dgorman/overlanding/battery-box/renders/cube/cards-lifted.png

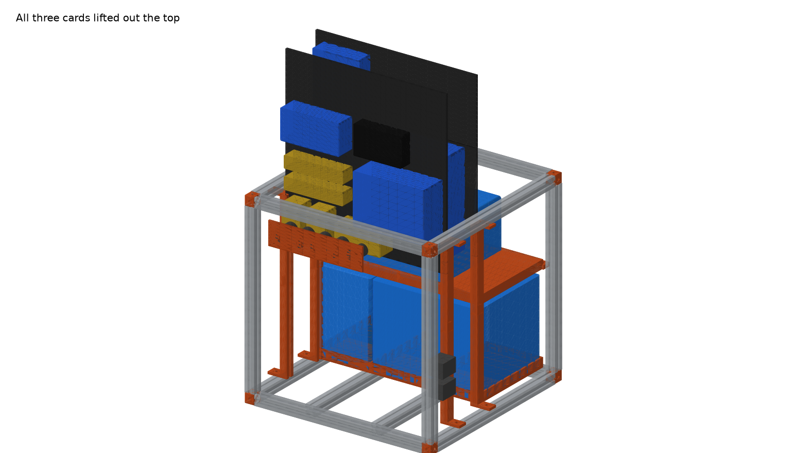
battery-box/renders/cube/cards-lifted.png
