dgorman/overlanding/battery-box/renders/master/front.png

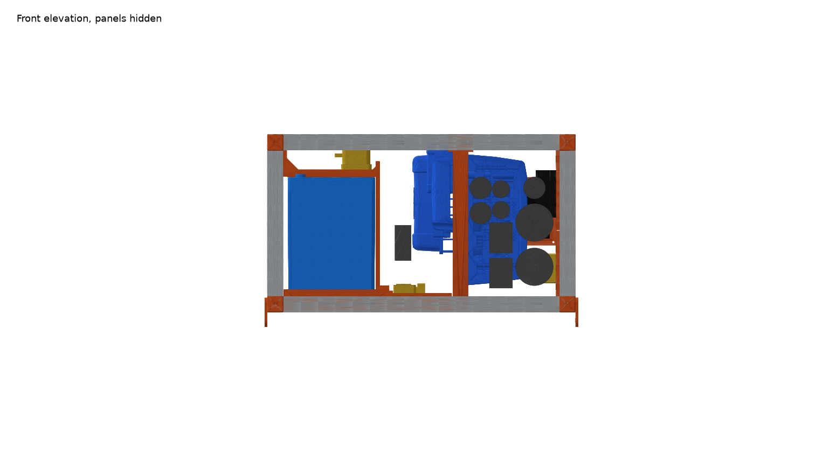
battery-box/renders/master/front.png
