dgorman/overlanding/battery-box/renders/master/iso-back.png

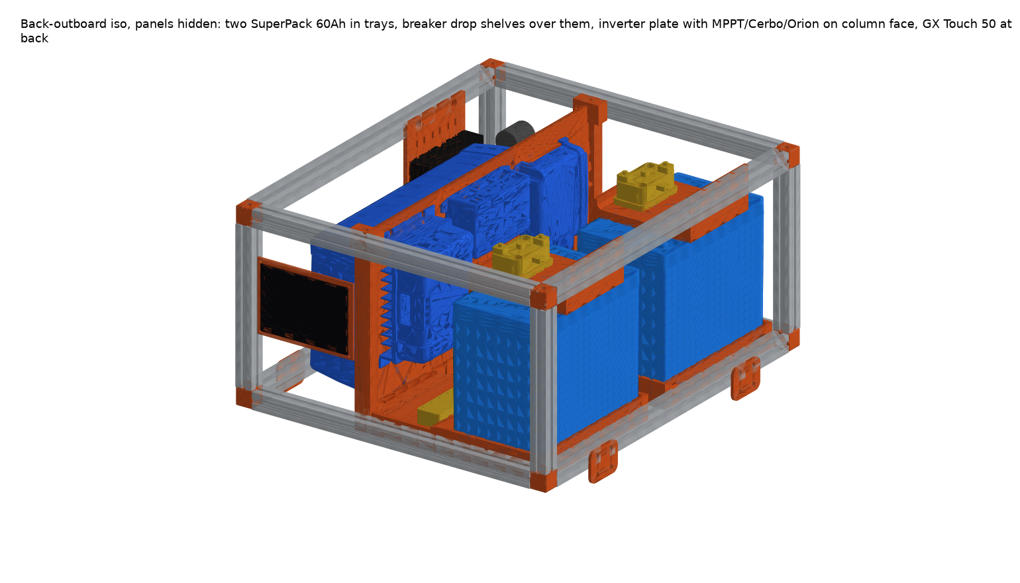
battery-box/renders/master/iso-back.png
