dgorman/overlanding/battery-box/renders/master/with-icebox-top.png

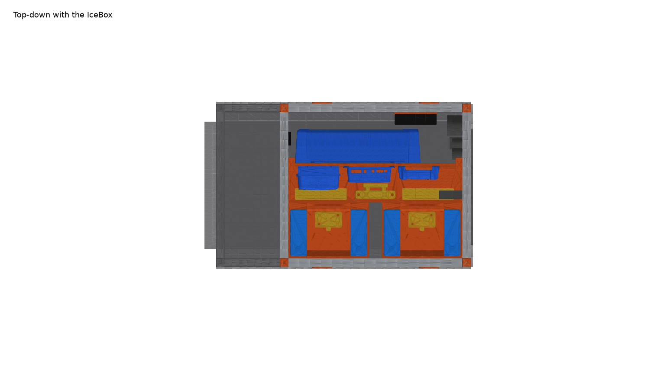
battery-box/renders/master/with-icebox-top.png
