dgorman/overlanding/battery-box/renders/pack2/cards-lifted.png

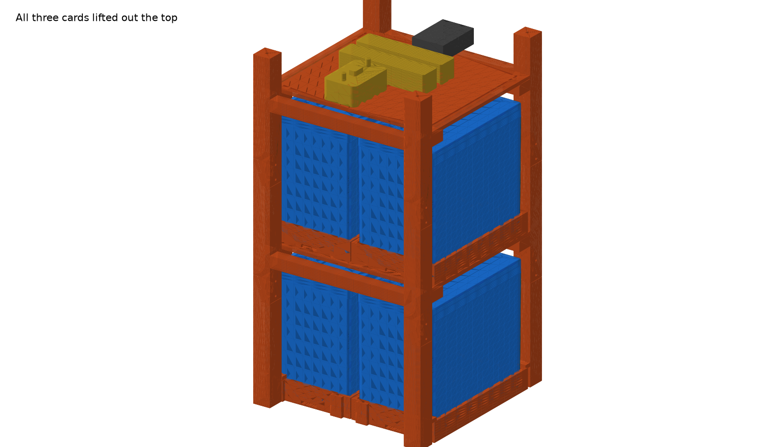
battery-box/renders/pack2/cards-lifted.png
