dgorman/overlanding/goose-gear-icebox-matching-parts.md

# Building a Matching Box for the Goose Gear IceBox 1.3

> **Outcome (updated 2026-10-30):** The matching electronics box (**`v12s`**) is built from the frame, corner cubes, and panels of a **donor 25 in Goose Gear IceBox 1.3** cut down to `571.5 × 488.1 × 281.7 mm` (`22.5 × 19.2 × 11.1 in`), plus **one bar from a Goose Gear Extrusion Frame Modification Kit x.31** to supply the missing bottom-front width rail (`436.6 mm`). Caliper measurement of the donor frame confirmed the MaxLite™ profile is **metric 25-series (`25.0 × 25.0 mm`, `6.5 mm` slot opening)** with **`25.75 mm` corner cubes** and **`6.0 mm` phenolic-faced plywood panels** captured in the rail centre slots (`1/4-20` 10-series drop-in T-nuts `6000N501` fit the `6.5 mm` slot). See [`battery-box/README.md`](battery-box/README.md) and [`battery-box/MANUAL.md`](battery-box/MANUAL.md). The notes below remain as the initial identification research.

**Vehicle:** Toyota 4Runner
**Goal:** Build an additional storage box that attaches to the Goose Gear IceBox 1.3 and looks identical — same silver extrusion, black corner cubes, and black textured panels.
**Why DIY:** Goose Gear will not sell raw parts. Their current frame profile is a proprietary extrusion they call **MaxLite™** (6063-T6 aluminum), which is why nothing ships as components — but every element has an off-the-shelf visual twin.

*Researched 2026-09-25 from close-up photos of the actual box (macro shots of the extrusion, tape-measure shot of the profile, corner detail).*

---

## What the IceBox is made of (identified from photos)

| Element | Identification |
|---|---|
| Frame | **1" × 1" T-slot aluminum extrusion** (measured ~1" wide), clear anodized — the "silver" finish is standard clear anodize, not paint |
| Corners | **Black 3-way squared corner cube** with counterbored thru-holes on each face (Goose Gear describes theirs as fiber-reinforced nylon; the 80/20 black-anodized aluminum part is a dead ringer) |
| Top panel | Birch-core plywood faced with **black phenolic film, hexa-grip anti-slip texture** (the dotted pattern) |
| Side panels | Same plywood, **smooth black phenolic** face — CNC-cut slots show the bare yellow ply core edges |
| Fasteners | Stainless Torx flanged button-head screws into slot T-nuts; wing-bolt eyelet tie-downs riding in the T-slot |
| Panel core note | Goose Gear's own spec is Joubert **okoume** marine ply (Lloyds-certified, ~half the weight of birch), laminated in-house with PVA cold-press. Phenolic-faced birch is the accessible look-alike; expect a few extra pounds per panel. |

---

## Parts list (10-series, 1" fractional)

### Extrusion

80/20 **10-series** 1" × 1", clear anodize. The smooth-faced variant (1010-S) matches the IceBox's clean look better than the grooved standard 1010.

| Source | Notes |
|---|---|
| [TNUTZ](https://www.tnutz.com) — EX-1010 | Economy equivalent, cut-to-length + end-tap service, roughly half of 80/20 pricing |
| [8020.net — 1010 family](https://8020.net/4042.html) | Cut-to-length, offers the 1/4-20 end-tap machining |
| Amazon | Stock lengths (24–48") if cutting at home |

#### About the bevel

The MaxLite profile has a **beveled/soft-edged face** that standard 80/20 1010 (square edges, small corner radius) doesn't replicate. Options, best match first:

1. **Genuine Goose Gear extrusion via their mod kits.** They won't sell raw stock, but they DO sell the [Extrusion Frame Modification Kit x.31](https://www.goose-gear.com/products/extrusion-frame-modification-kit-x-31-for-campkitchen-icebox) (~$139) — "includes both Extrusion Bars and hardware," sized for the CampKitchen 2.3 / IceBox 1.3 footprint. Buying one or two mod kits = real MaxLite bars with the exact bevel and anodize. Call Goose Gear for bar lengths before ordering (8-week build-to-order lead time). Their [Anchor Kits](https://www.goose-gear.com/products/goose-gear-anchor-kits) cover matching tie-down hardware.
2. **TSLOTS (Futura) TS10-10QR "Quarter Round"** — 1" × 1", **two T-slots + large radius outer corner**: slots face the panels, the soft corner faces out. Much closer to the Goose Gear edge than square 1010. Sold by [Framing Tech](https://www.framingtech.com/shop/1-0x1-0-r-240inch-1-x-1-t-slot-profile-2-26-tslots-quarter-round-402620) and [Automation Werks](https://www.automationwerks.com/products/tslots-1012-s-1-in-x-1-in-quarter-round-extrusion-650040/2217522000016375453); 0.26" slots, center bore taps 1/4-20.
3. **Standard 1010 / 1010-S** — square-edged but visually close at arm's length; cheapest and most available.

Don't chamfer standard 1010 yourself — routed edges expose bare (shinier) aluminum that won't match the anodize.

### Corner cubes

**80/20 #4042-Black — 10 Series 3-Way Squared Corner Connector.**

- [8020.net product page](https://8020.net/4042-black.html)
- [Amazon](https://www.amazon.com/80-20-Inc-4042-Black-Connector/dp/B09QXFMVCX)
- [Global Industrial](https://www.globalindustrial.com/p/8020-10-series-3-way-squared-corner-connector-black)

Fastens with bolts threaded into the **ends** of the extrusion → order extrusion with **1/4-20 end taps**, or hand-tap the center bore yourself (easy).

### Panels

Black phenolic film-faced birch plywood — hexa-grip texture for the top, smooth black for sides:

| Source | Notes |
|---|---|
| [Penn Elcom — 12mm black hexa birch (M847113)](https://www.penn-elcom.com/12mm-film-faced-high-quality-birch-with-black-hexa-pattern-m847113) | Road-case supplier, sells cut panels; also [12mm smooth black phenolic (X11120S)](https://www.penn-elcom.com/us/12mm-film-faced-high-quality-birch-with-black-smooth-phenolic-x11120s) |
| [Woodworkers Source — Ultra-X pre-cut packs](https://www.woodworkerssource.com/birch-plywood/UltraGripX/12-thin-black-hex-pattern-anti-slip-phenolic-exterior.html) | 1/2", hex pattern one side / smooth the other, exterior glue |
| [MakerStock — Hex-Ply](https://makerstock.com/products/hex-phenolic-baltic-birch-plywood-black) | 12–18mm anti-slip phenolic birch |

### Hardware

- 1/4-20 **flanged button-head screws** (stainless Torx to match) + **10-series economy T-nuts** — TNUTZ, 8020, or Amazon 10-series kits
- Slot-mount **eyelet / wing-bolt tie-down anchors** in 10-series

---

## ⚠️ Measure before ordering

Two caliper checks on the existing IceBox:

1. **Profile width:** exactly **1.000"** → fractional 10-series (order above). **0.984" (25mm)** → metric 25-series instead (8020 sells that too; M6 hardware).
2. **Slot opening:** 10-series ≈ **0.26"**; 25-series ≈ 6mm. Determines which T-nuts fit.

Goose Gear builds in the USA, so fractional 10-series is the strong bet — but the check costs nothing and a wrong guess costs a return.

---

## Build approach

1. Cut 1010 to length with 1/4-20 end taps at every corner-cube joint.
2. Join the frame with 4042-Black cubes.
3. Screw phenolic panels to the frame faces: button-heads through the panel into T-nuts in the slots (exactly how the IceBox panels attach).
4. **Attaching to the IceBox:** both boxes have open T-slots — bolt them together with T-nuts and joining plates. No drilling into the Goose Gear unit.

---

## Reference links

- [Goose Gear IceBox 1.3 product page](https://www.goose-gear.com/products/icebox-1-3-25-deep-module) (MaxLite™ extrusion, okoume panel spec, ~42 lb)
- [80/20 3-way squared corner connector family](https://8020.net/fasteningmethods/externalfasteners/bracketsgussetscorners/triconnectioncornerbrackets/3waysquaredcornerconnector.html)
- [Expedition Portal — Goose Gear thread](https://expeditionportal.com/forum/threads/goose-gear.132936/)
- [Expedition Portal — 80/20 "erector set for campers"](https://forum.expeditionportal.com/threads/80-20-erector-set-for-campers.154860/)
