dgorman/overlanding/battery-box/stl/icebox/print_post_main_1_0.stl

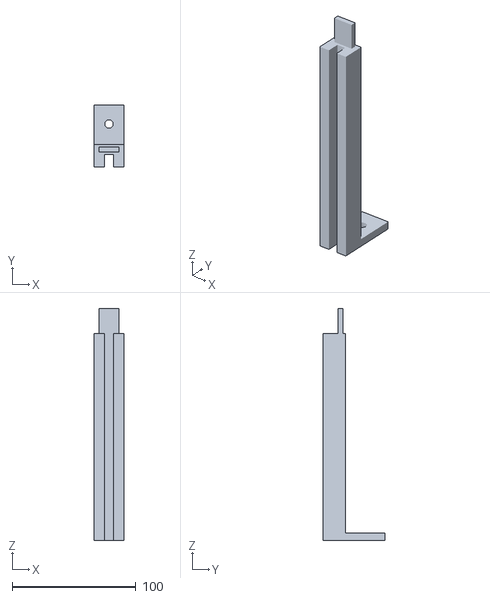
[picture p10: CAD file, 2026-10-23]
battery-box/stl/icebox/print_post_main_1_0.stl
24.0 x 50.0 x 187.3
