dgorman/overlanding/battery-box/stl/cube/print_post_main_1_0.stl

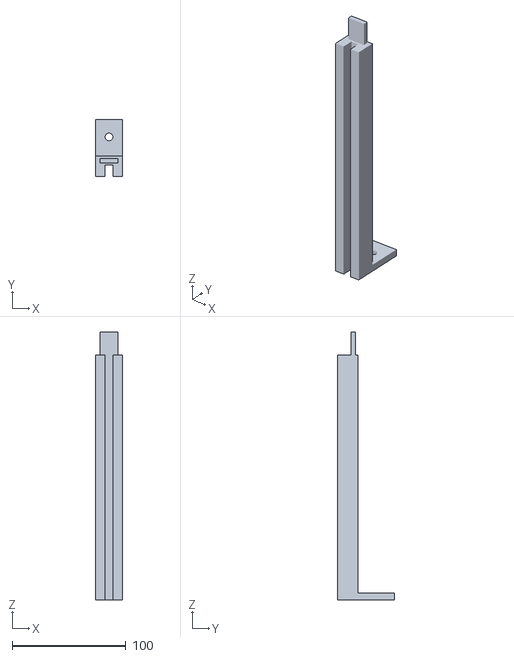
[picture p11: CAD file, 2026-10-23]
battery-box/stl/cube/print_post_main_1_0.stl
24.0 x 50.0 x 235.3
