dgorman/overlanding/battery-box/stl/icebox/print_post_main_0_2.stl

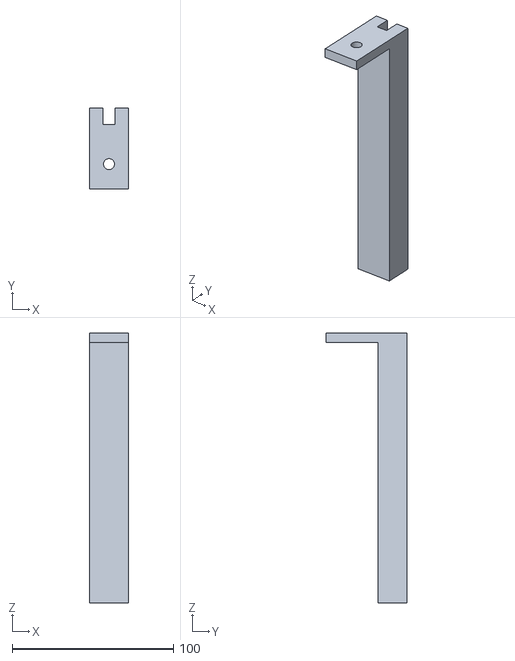
[picture p12: CAD file, 2026-10-23]
battery-box/stl/icebox/print_post_main_0_2.stl
24.0 x 50.0 x 167.3
