dgorman/overlanding/battery-box/stl/cube/print_post_main_0_1.stl

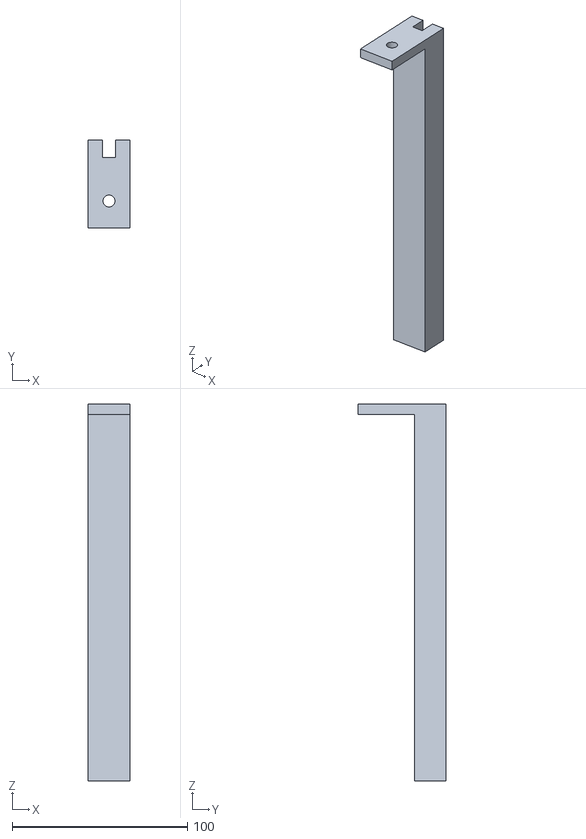
[picture p13: CAD file, 2026-10-23]
battery-box/stl/cube/print_post_main_0_1.stl
24.0 x 50.0 x 215.3
