dgorman/overlanding/battery-box/stl/icebox/print_post_main_1_1.stl

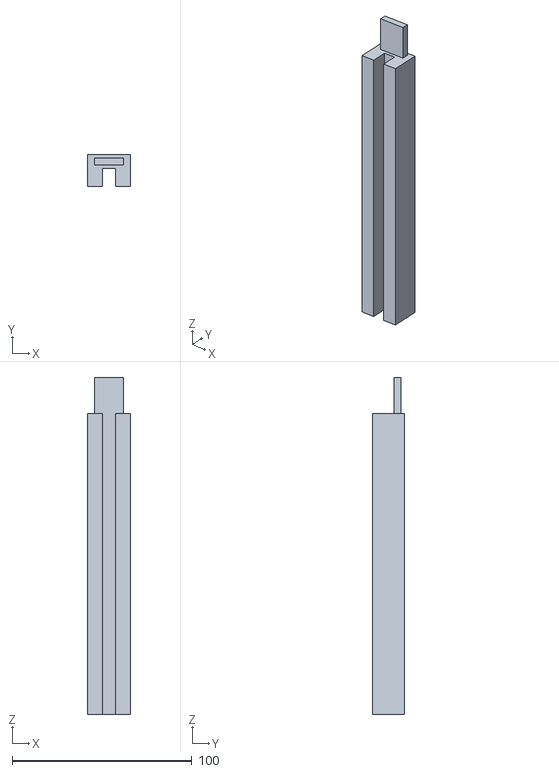
[picture p14: CAD file, 2026-10-23]
battery-box/stl/icebox/print_post_main_1_1.stl
24.0 x 18.0 x 187.3
