dgorman/overlanding/battery-box/cad/step/anderson_sb50_housing.stp

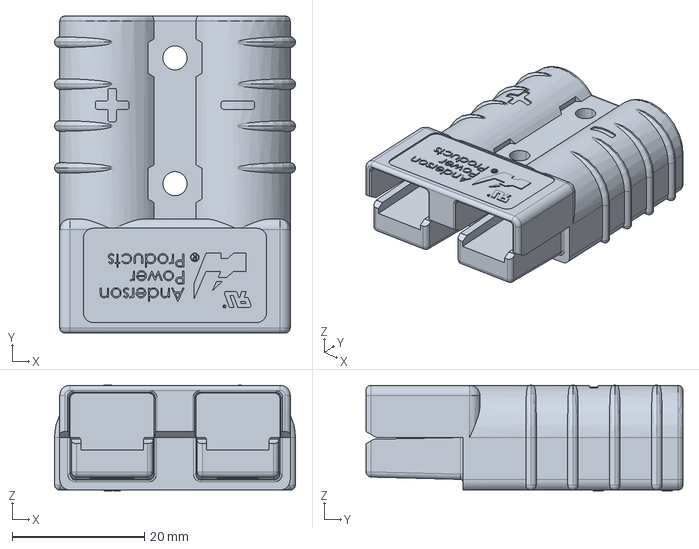
[picture p15: CAD file, 2026-10-23]
battery-box/cad/step/anderson_sb50_housing.stp
36.5 x 48.0 x 16.0 mm
