dgorman/overlanding/battery-box/stl/bookshelf/print_cube_101.stl

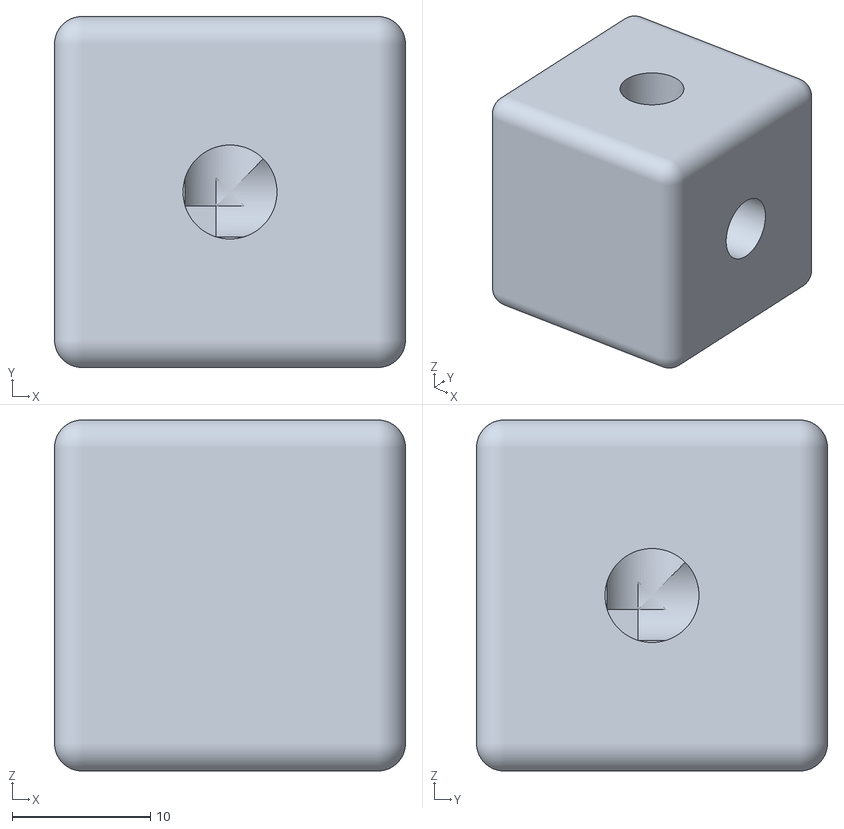
[picture p16: CAD file, 2026-10-23]
battery-box/stl/bookshelf/print_cube_101.stl
25.4 x 25.4 x 25.4
