dgorman/overlanding/battery-box/stl/icebox/print_shelf_stack_0.stl

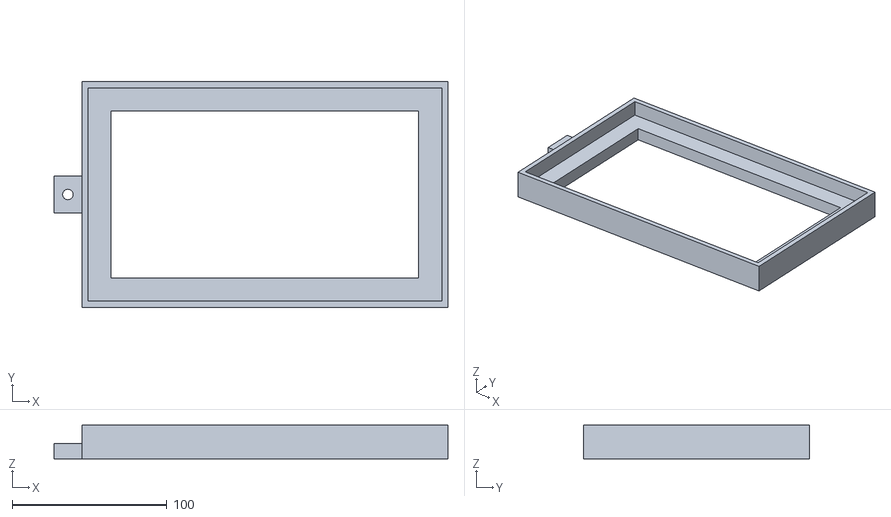
[picture p17: CAD file, 2026-10-23]
battery-box/stl/icebox/print_shelf_stack_0.stl
255.0 x 146.0 x 22.0
