dgorman/overlanding/battery-box/stl/master/print_panel_front_inboard_ports_multicolor.3mf

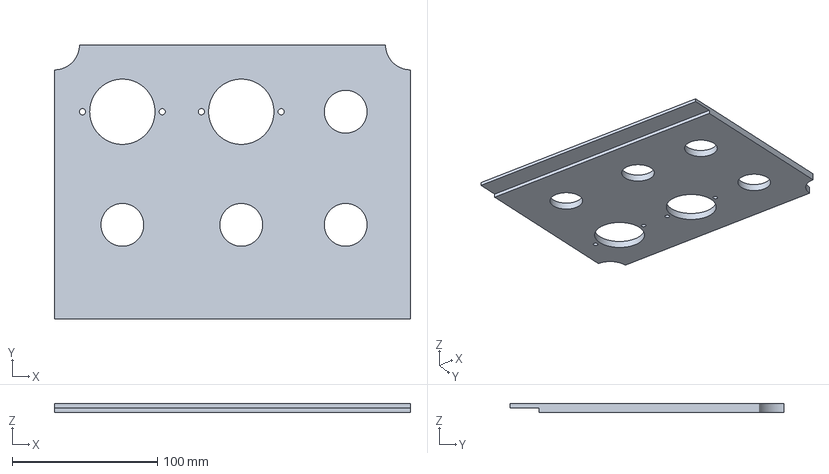
[picture p18: CAD file, 2026-11-13]
battery-box/stl/master/print_panel_front_inboard_ports_multicolor.3mf
245.5 x 189.1 x 6.25 mm
