dgorman/overlanding/battery-box/stl/pack2/print_pack_panel_front_spline_v1_424.stl

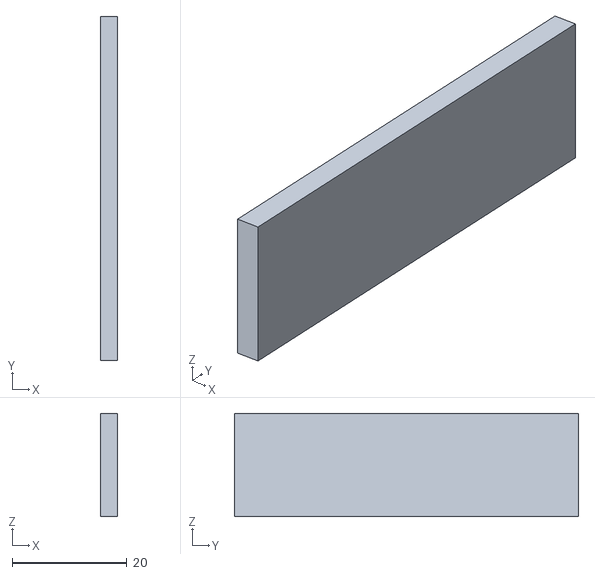
[picture p19: CAD file, 2026-10-23]
battery-box/stl/pack2/print_pack_panel_front_spline_v1_424.stl
3.00 x 60.0 x 18.0
