dgorman/overlanding/battery-box/stl/v12_1200/print_plate_inverter_tile_00.stl

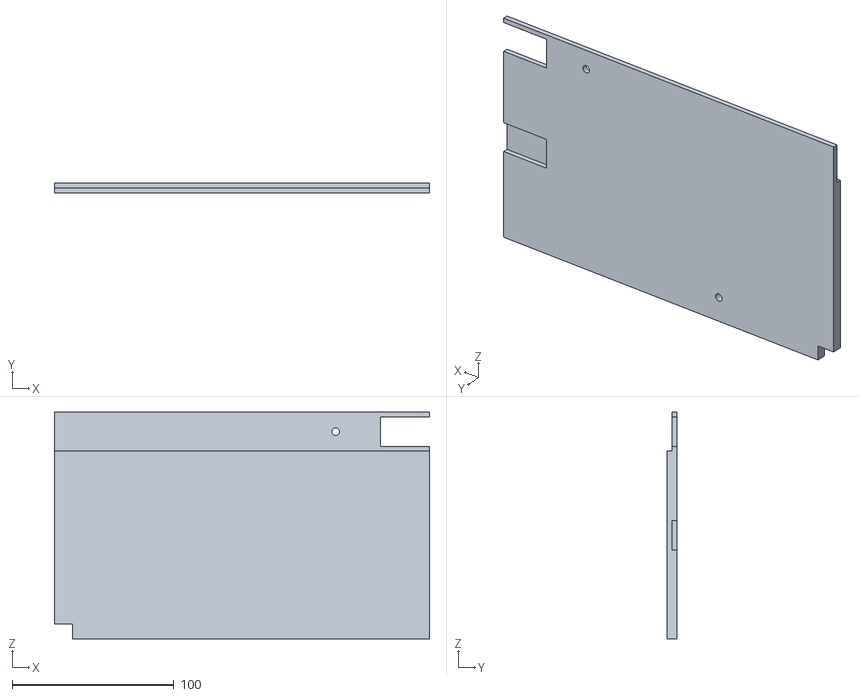
[picture p20: CAD file, 2026-10-23]
battery-box/stl/v12_1200/print_plate_inverter_tile_00.stl
231.7 x 6.00 x 140.0
