dgorman/overlanding/battery-box/stl/v12s/print_breaker_shelf_1.stl

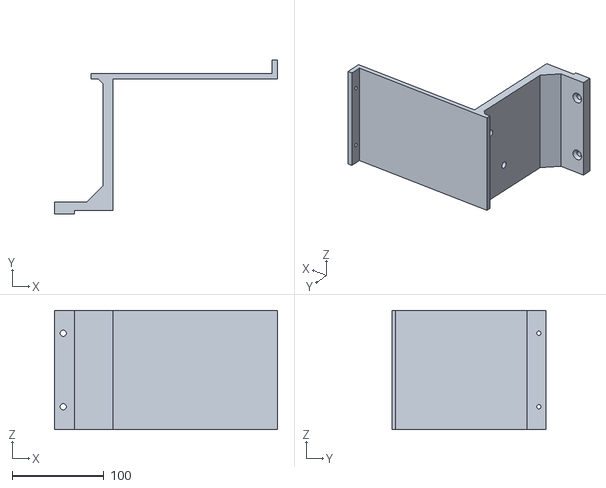
[picture p21: CAD file, 2026-11-07]
battery-box/stl/v12s/print_breaker_shelf_1.stl
242.7 x 168.0 x 130.0
