dgorman/overlanding/battery-box/stl/v14/print_panel_front_outboard.stl

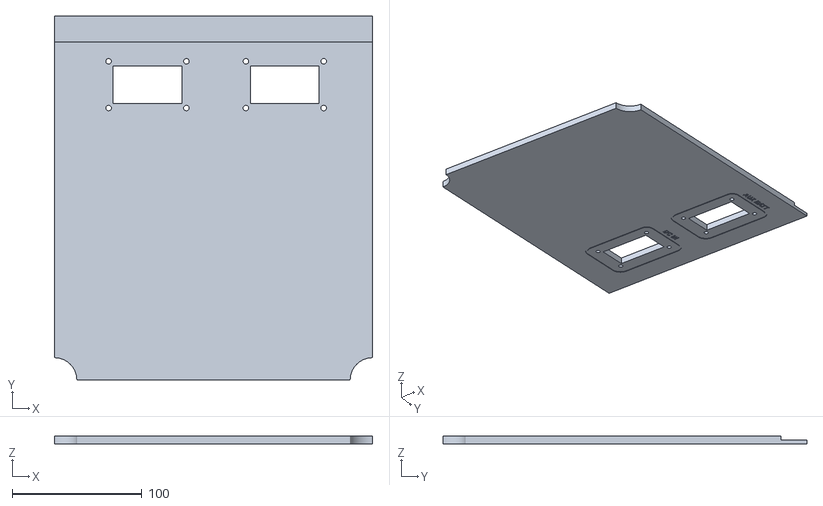
[picture p22: CAD file, 2026-11-13]
battery-box/stl/v14/print_panel_front_outboard.stl
245.5 x 281.0 x 6.25
