dgorman/overlanding/battery-box/cad/step/anderson_sb175_housing.stp

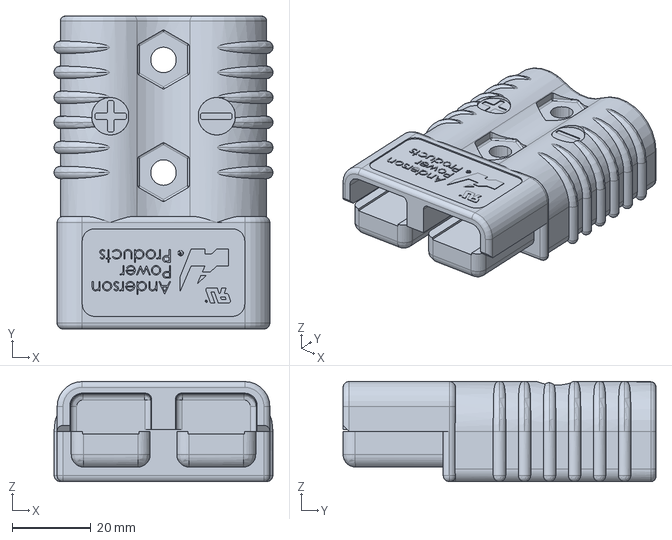
[picture p23: CAD file, 2026-10-23]
battery-box/cad/step/anderson_sb175_housing.stp
55.6 x 79.4 x 25.5 mm
