dgorman/overlanding/battery-box/stl/bookshelf60/print_leg_1_0_364_42.stl

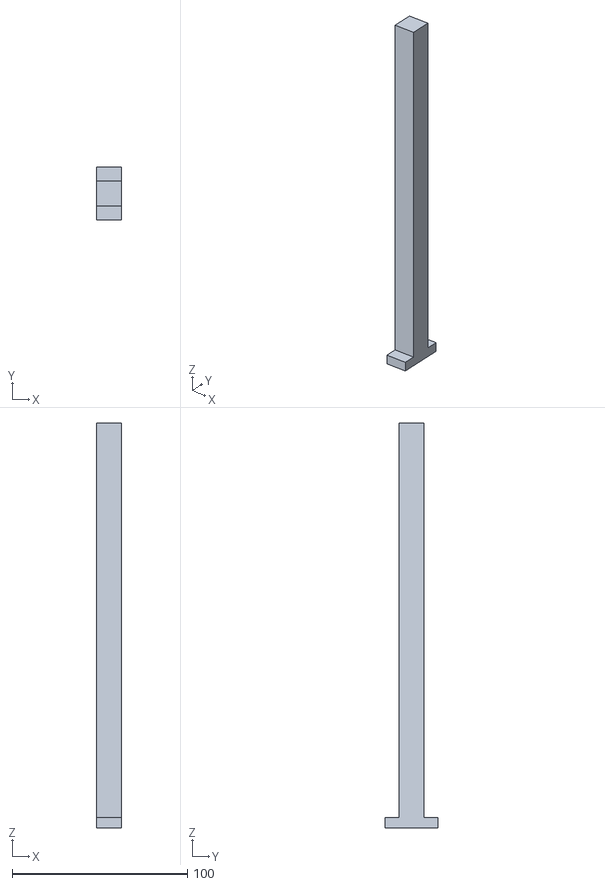
[picture p24: CAD file, 2026-10-23]
battery-box/stl/bookshelf60/print_leg_1_0_364_42.stl
14.0 x 30.0 x 231.0
