dgorman/overlanding/battery-box/stl/master/print_panel_front_outboard_inlay_white.stl

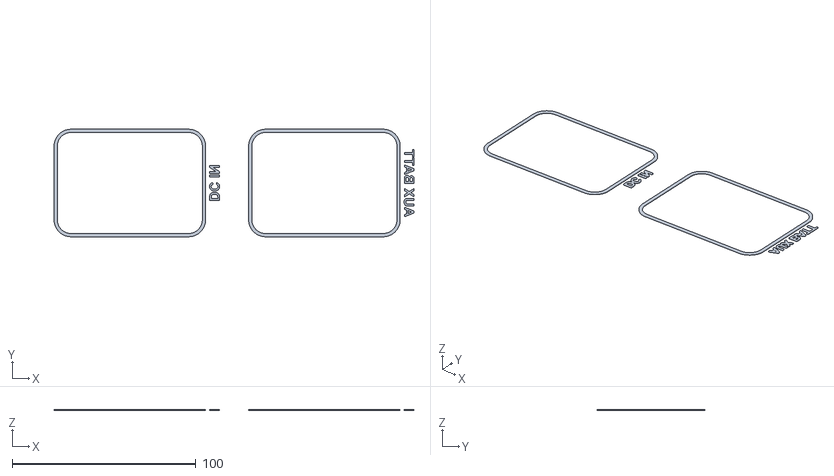
[picture p25: CAD file, 2026-11-13]
battery-box/stl/master/print_panel_front_outboard_inlay_white.stl
196.1 x 58.6 x 0.6
