dgorman/overlanding/battery-box/stl/pack2/print_pack_tray_11.stl

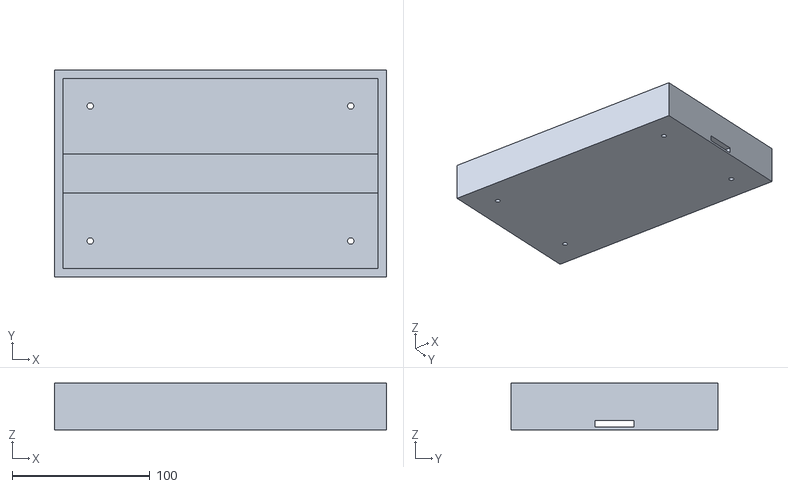
[picture p26: CAD file, 2026-10-23]
battery-box/stl/pack2/print_pack_tray_11.stl
241.0 x 150.0 x 34.0
