dgorman/overlanding/battery-box/stl/bookshelf/print_feet_mp_484.stl

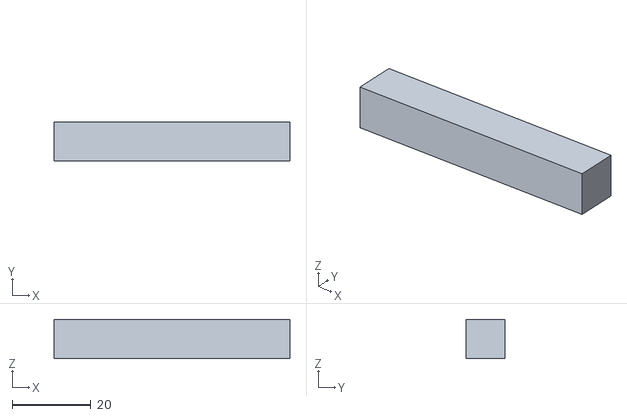
[picture p27: CAD file, 2026-10-23]
battery-box/stl/bookshelf/print_feet_mp_484.stl
60.0 x 10.0 x 10.0
