dgorman/overlanding/battery-box/stl/cube/print_socket_insert.stl

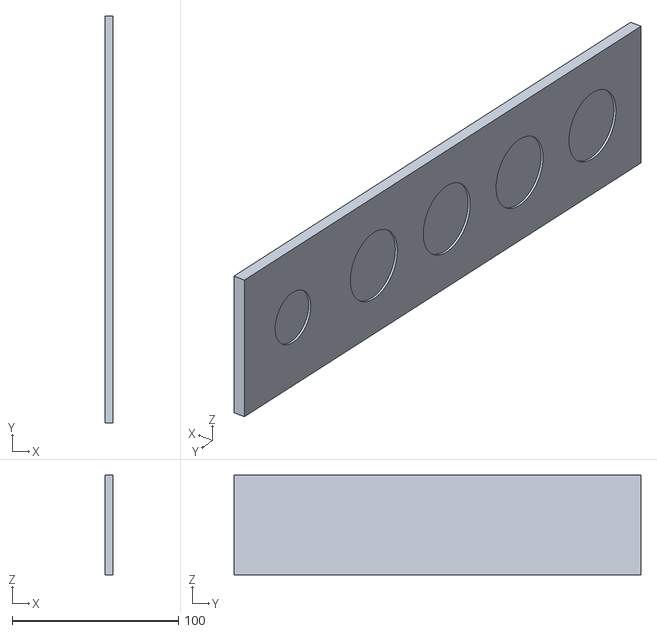
[picture p28: CAD file, 2026-10-23]
battery-box/stl/cube/print_socket_insert.stl
5.00 x 245.0 x 60.0
