dgorman/overlanding/battery-box/stl/pack2/print_pack_panel_back_tile_10.stl

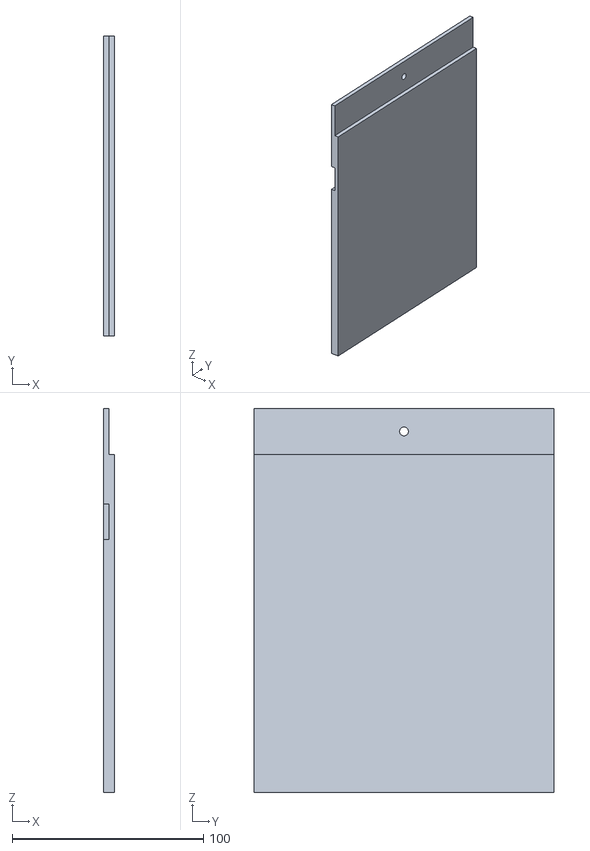
[picture p29: CAD file, 2026-10-23]
battery-box/stl/pack2/print_pack_panel_back_tile_10.stl
6.00 x 157.0 x 200.7
