dgorman/overlanding/battery-box/stl/v12_1200/print_bus_shelf_1.stl

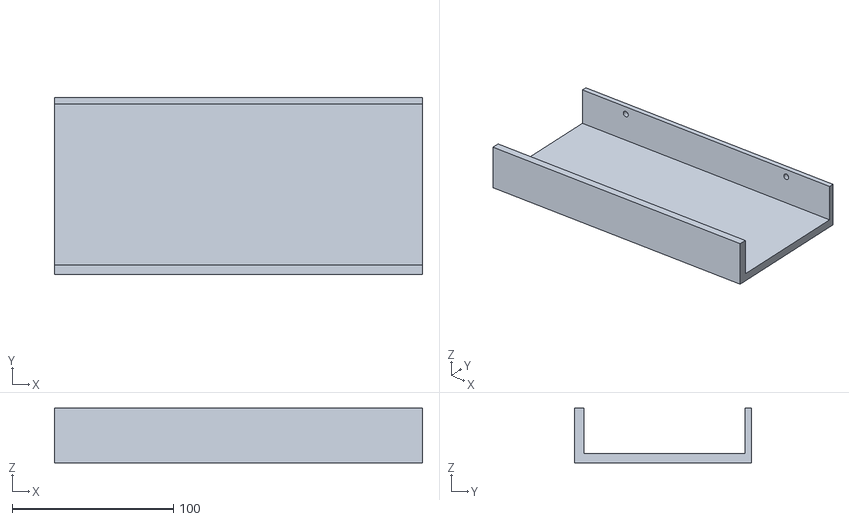
[picture p30: CAD file, 2026-10-23]
battery-box/stl/v12_1200/print_bus_shelf_1.stl
228.0 x 109.6 x 34.0
