dgorman/overlanding/battery-box/stl/v12s_pack/print_stack_strap.dxf

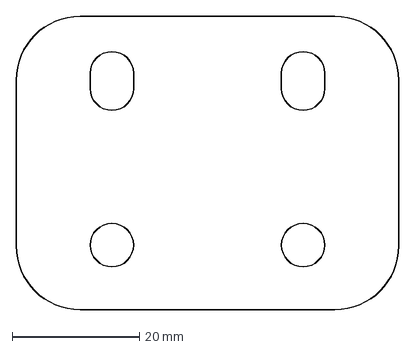
[picture p31: CAD file, 2026-11-07]
battery-box/stl/v12s_pack/print_stack_strap.dxf
60.0 x 46.0 mm
