dgorman/overlanding/battery-box/stl/cube/print_feet_mp_343.stl

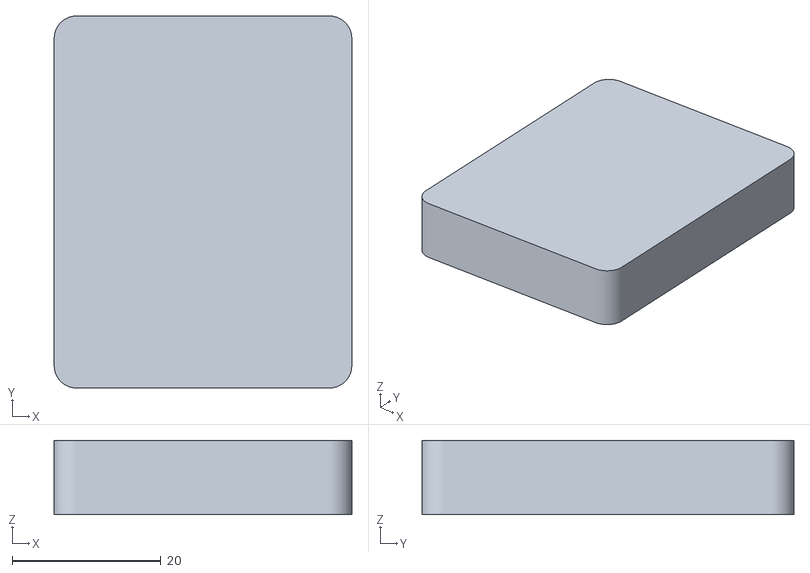
[picture p32: CAD file, 2026-10-23]
battery-box/stl/cube/print_feet_mp_343.stl
40.0 x 50.0 x 10.0
