dgorman/overlanding/battery-box/stl/pack2/print_pack_tray_00.stl

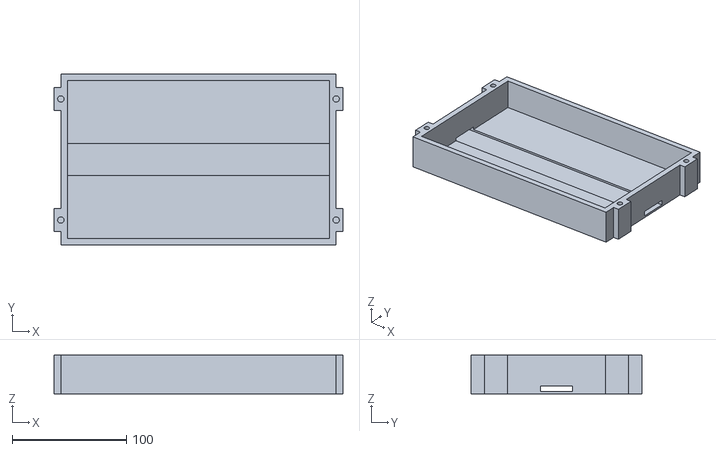
[picture p33: CAD file, 2026-10-23]
battery-box/stl/pack2/print_pack_tray_00.stl
253.0 x 150.0 x 34.0
