dgorman/overlanding/battery-box/stl/v12_1200/print_plate_inverter_tile_01.stl

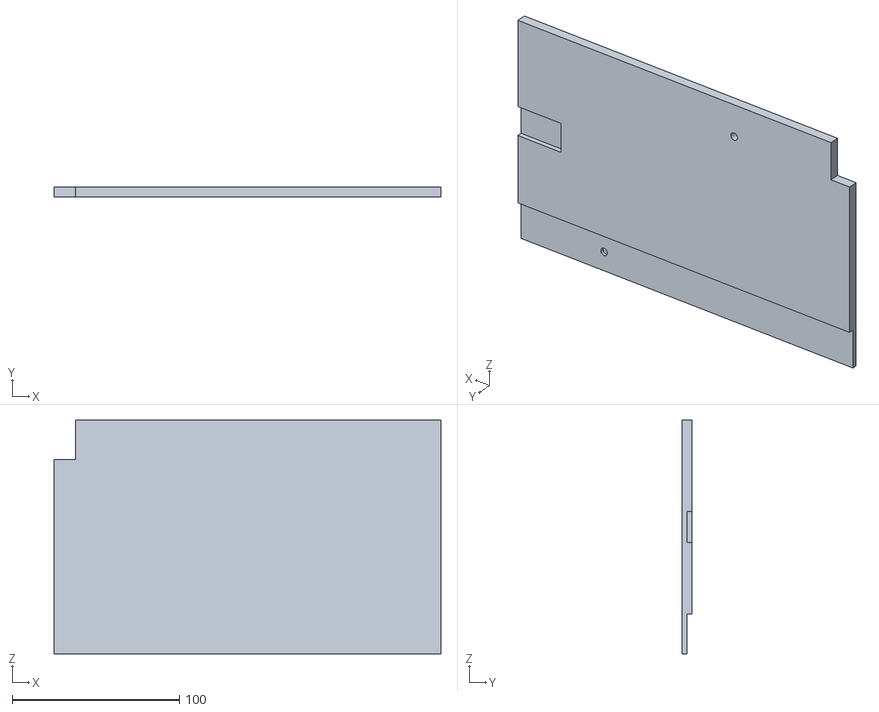
[picture p34: CAD file, 2026-10-23]
battery-box/stl/v12_1200/print_plate_inverter_tile_01.stl
231.7 x 6.00 x 140.0
