dgorman/overlanding/battery-box/stl/v12s/print_bus_shelf_2.stl

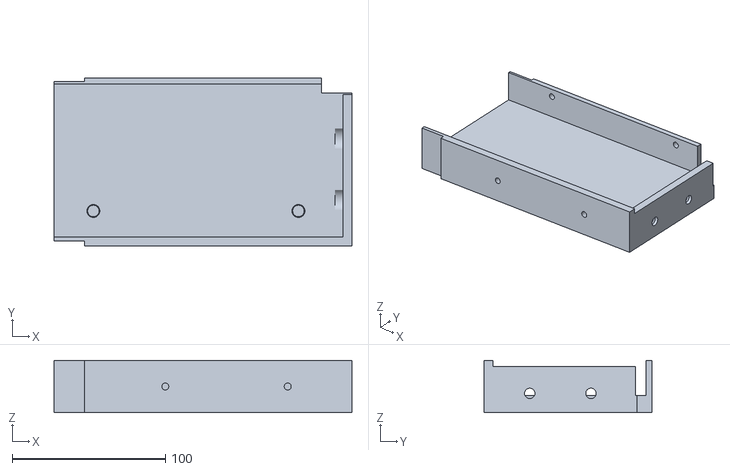
[picture p35: CAD file, 2026-11-07]
battery-box/stl/v12s/print_bus_shelf_2.stl
194.7 x 110.0 x 34.0
