dgorman/overlanding/battery-box/stl/v12s_h2d/print_tray_battery_1.stl

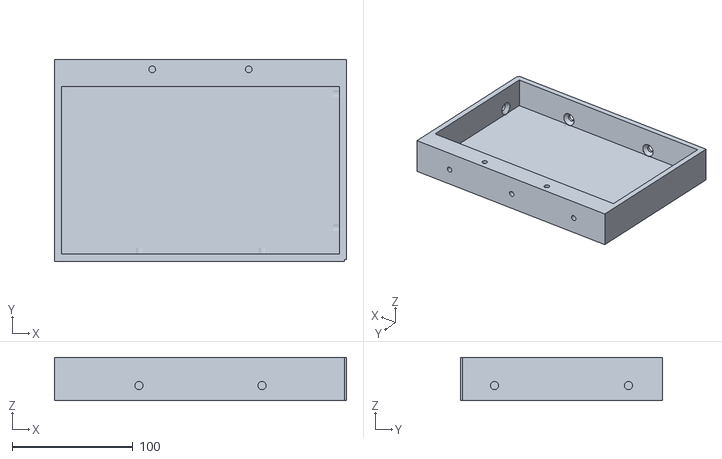
[picture p36: CAD file, 2026-11-07]
battery-box/stl/v12s_h2d/print_tray_battery_1.stl
242.0 x 167.0 x 36.0
