dgorman/overlanding/battery-box/stl/v14/print_panel_front_inboard_ports.stl

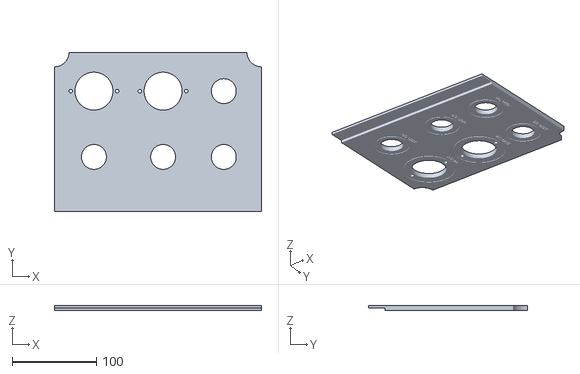
[picture p37: CAD file, 2026-11-13]
battery-box/stl/v14/print_panel_front_inboard_ports.stl
245.5 x 189.1 x 6.25
