dgorman/overlanding/battery-box/stl/bookshelf/print_socket_insert.stl

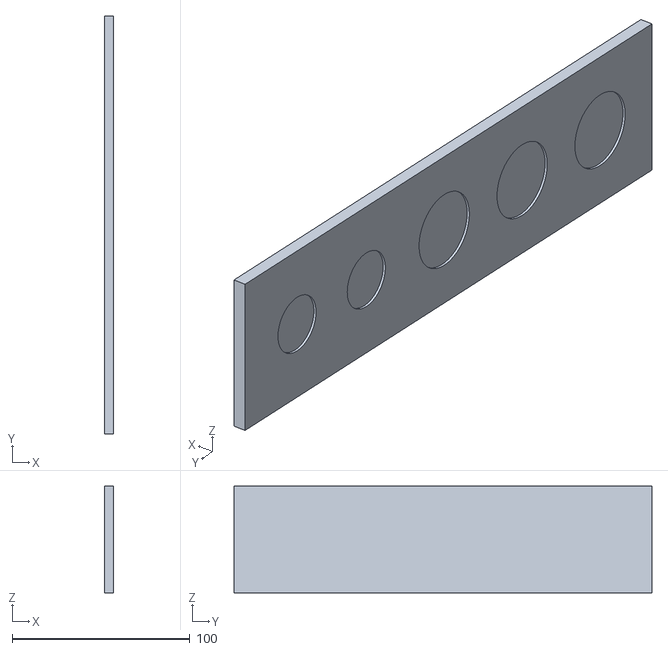
[picture p39: CAD file, 2026-10-23]
battery-box/stl/bookshelf/print_socket_insert.stl
5.00 x 235.0 x 60.0
