dgorman/overlanding/battery-box/stl/master/print_panel_side_inboard_back_inlay_green.stl

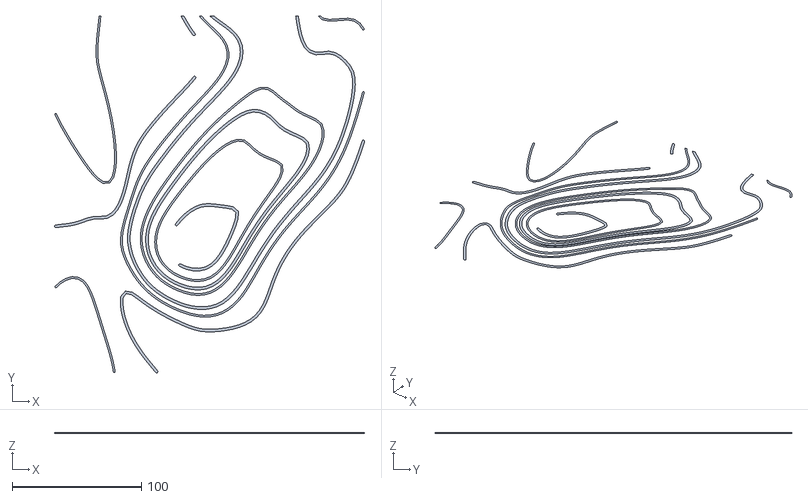
[picture p40: CAD file, 2026-11-13]
battery-box/stl/master/print_panel_side_inboard_back_inlay_green.stl
239.7 x 275.8 x 0.6
