dgorman/overlanding/battery-box/stl/pack2/print_pack_panel_outboard_tile_11.stl

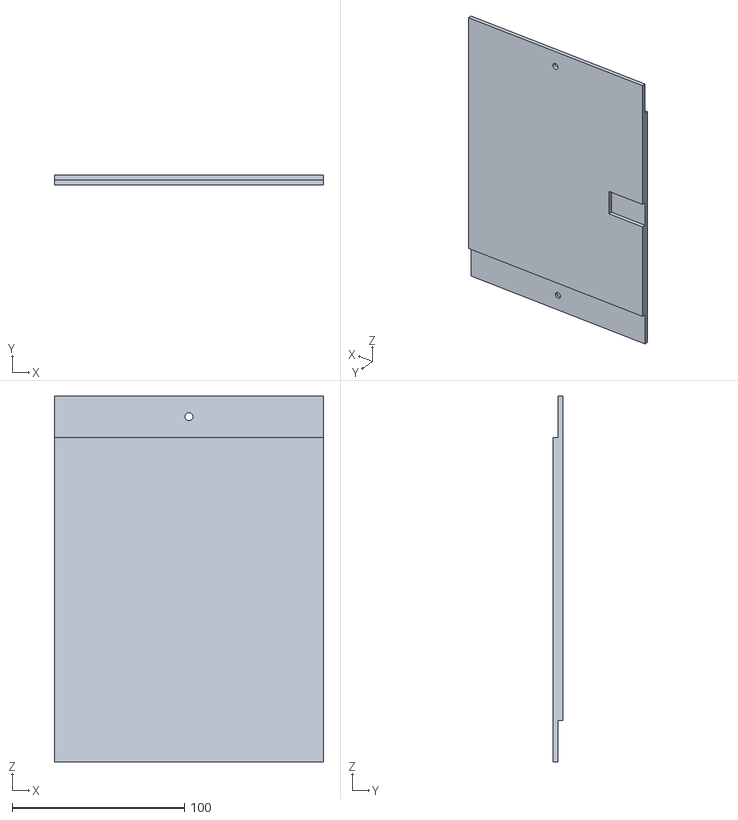
[picture p41: CAD file, 2026-10-23]
battery-box/stl/pack2/print_pack_panel_outboard_tile_11.stl
156.5 x 6.00 x 212.7
