dgorman/overlanding/battery-box/stl/v12s/print_bus_shelf_0.stl

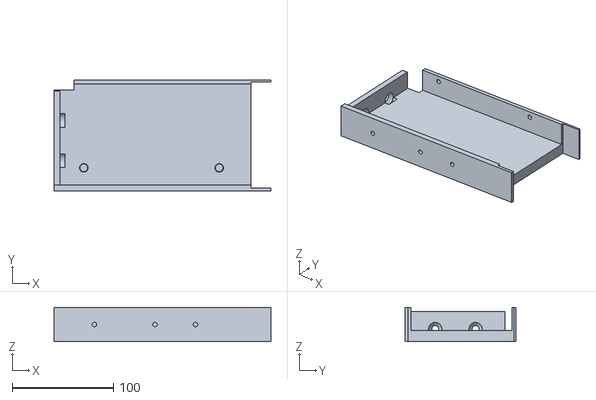
[picture p42: CAD file, 2026-11-07]
battery-box/stl/v12s/print_bus_shelf_0.stl
214.7 x 110.0 x 34.0
