dgorman/overlanding/battery-box/stl/v14/print_panel_side_inboard_front.stl

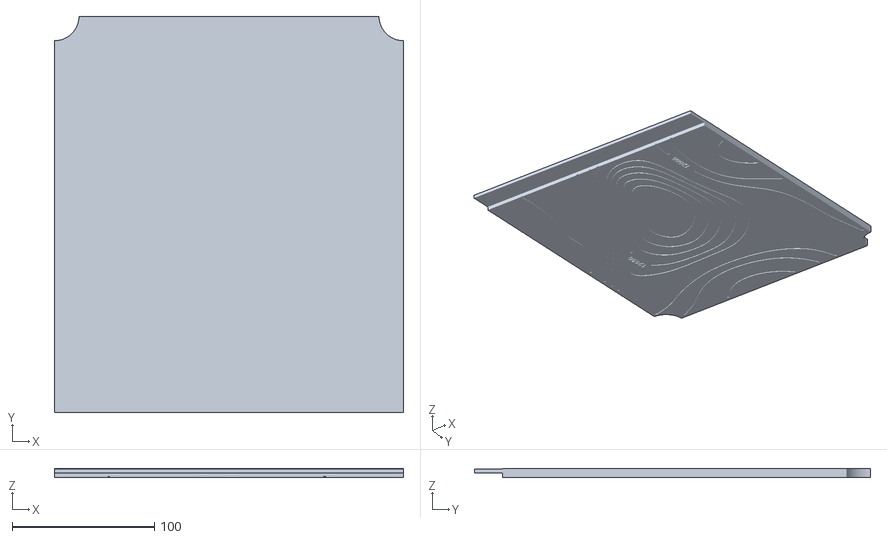
[picture p43: CAD file, 2026-11-13]
battery-box/stl/v14/print_panel_side_inboard_front.stl
245.5 x 278.9 x 6.25
