dgorman/overlanding/battery-box/stl/pack2/print_pack_lid_01.stl

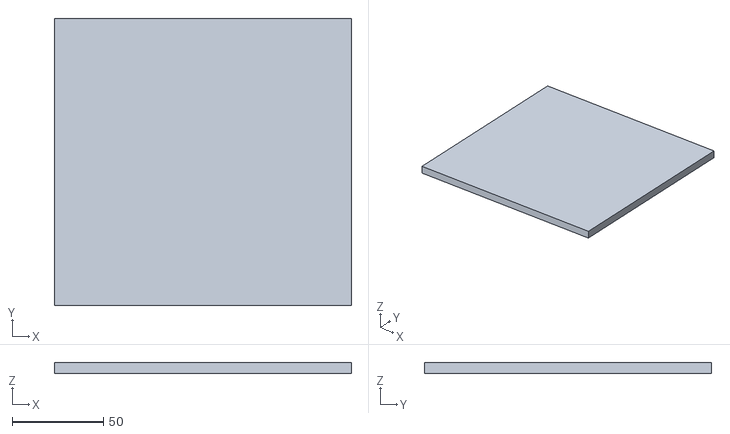
[picture p45: CAD file, 2026-10-23]
battery-box/stl/pack2/print_pack_lid_01.stl
162.5 x 157.0 x 6.00
