dgorman/overlanding/battery-box/stl/v12_1200/print_tray_rail_bracket_11.stl

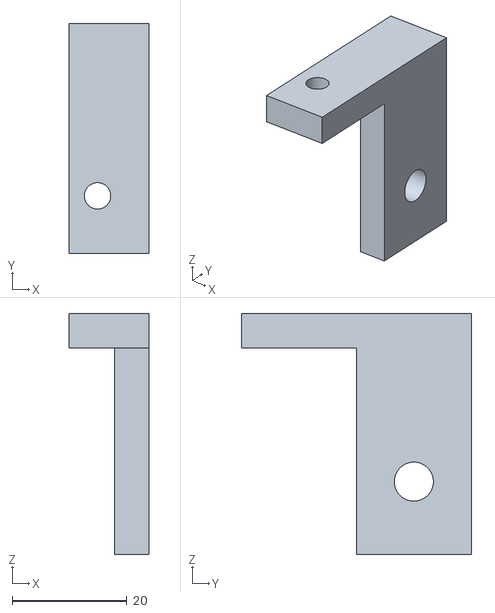
[picture p46: CAD file, 2026-10-23]
battery-box/stl/v12_1200/print_tray_rail_bracket_11.stl
14.0 x 40.0 x 42.0
