dgorman/overlanding/battery-box/stl/v14/print_panel_side_inboard_front_inlay_green.stl

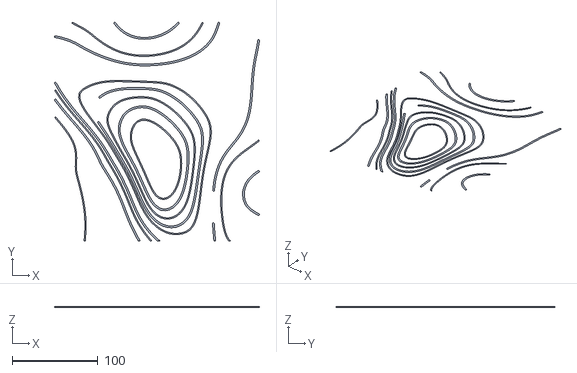
[picture p47: CAD file, 2026-11-13]
battery-box/stl/v14/print_panel_side_inboard_front_inlay_green.stl
239.8 x 255.8 x 0.6
