dgorman/overlanding/battery-box/stl/bookshelf/print_leg_1_0_364_42.stl

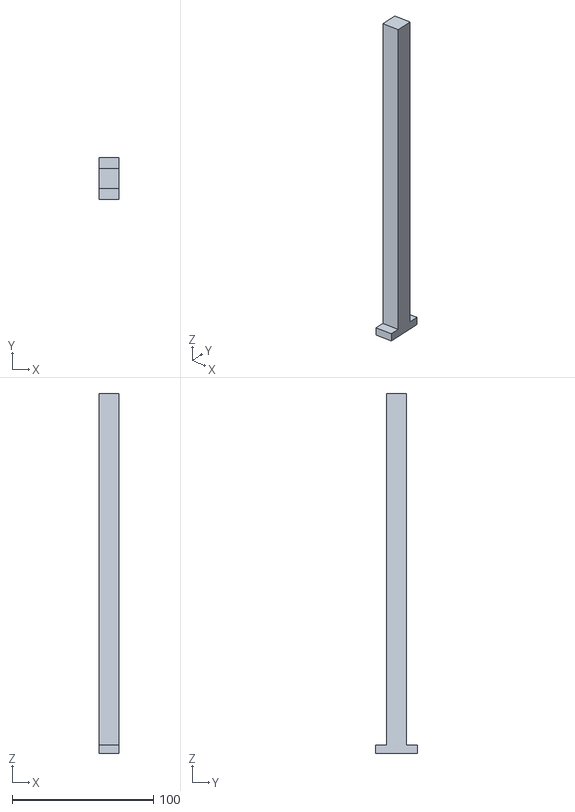
[picture p48: CAD file, 2026-10-23]
battery-box/stl/bookshelf/print_leg_1_0_364_42.stl
14.0 x 30.0 x 255.0
