dgorman/overlanding/battery-box/stl/v12s_h2d/print_touch_bezel.stl

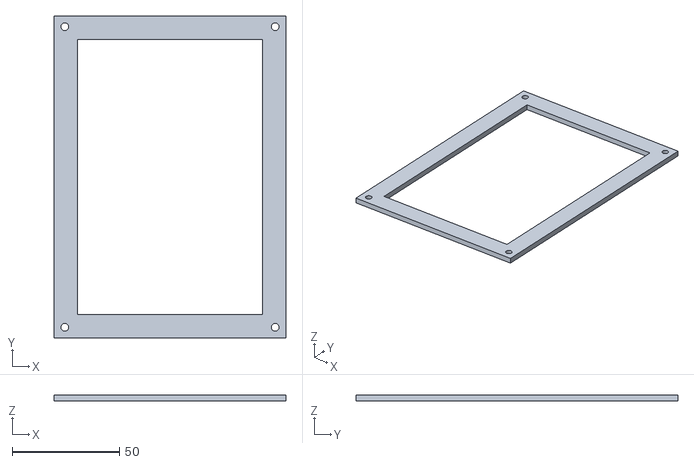
[picture p51: CAD file, 2026-10-31]
battery-box/stl/v12s_h2d/print_touch_bezel.stl
108.0 x 150.0 x 3.00
