dgorman/overlanding/battery-box/stl/master/print_panel_side_outboard_back_inlay_white.stl

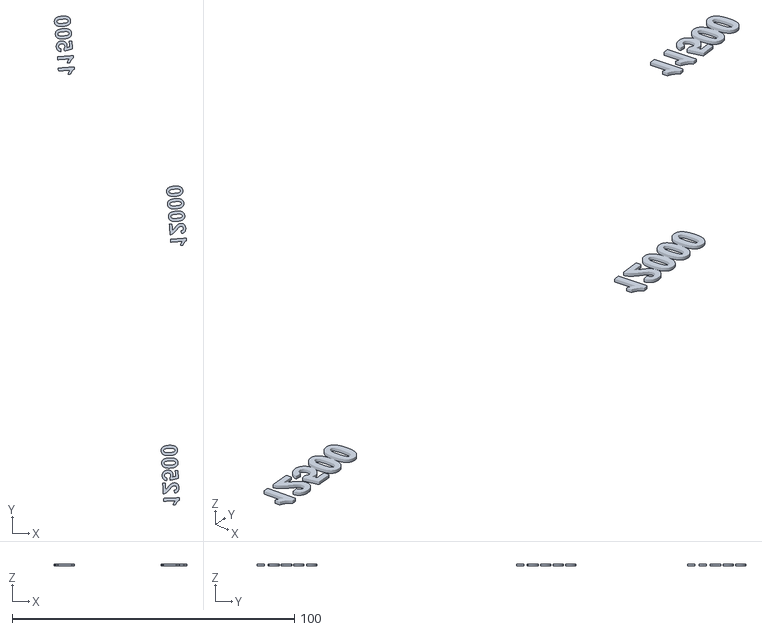
[picture p53: CAD file, 2026-11-13]
battery-box/stl/master/print_panel_side_outboard_back_inlay_white.stl
47.0 x 173.3 x 0.6
