dgorman/overlanding/battery-box/stl/v12s/print_plate_inverter_tile_11.stl

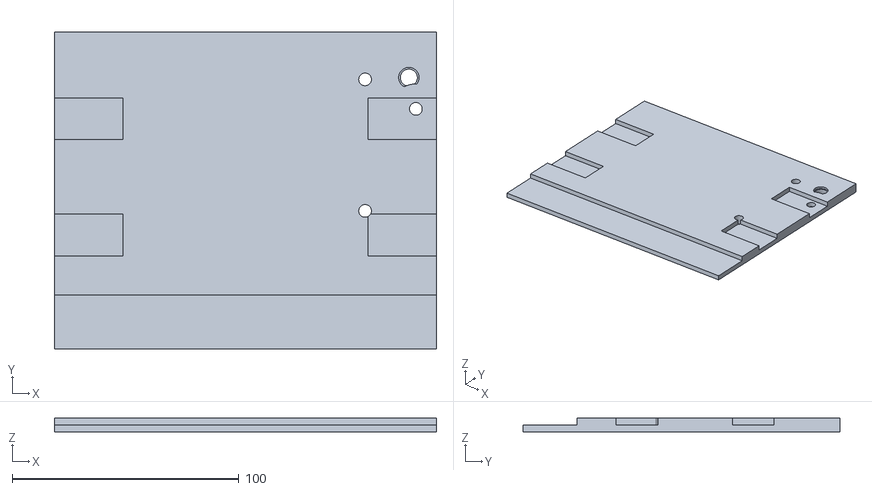
[picture p54: CAD file, 2026-11-02]
battery-box/stl/v12s/print_plate_inverter_tile_11.stl
168.5 x 140.0 x 6.00
