dgorman/overlanding/battery-box/stl/master/print_panel_side_outboard_back_multicolor.3mf

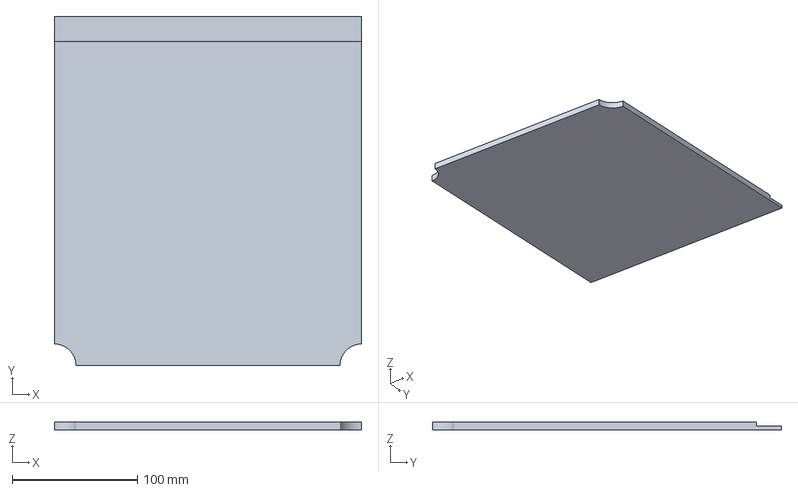
[picture p55: CAD file, 2026-11-13]
battery-box/stl/master/print_panel_side_outboard_back_multicolor.3mf
245.5 x 278.9 x 6.25 mm
