dgorman/overlanding/battery-box/stl/v12_1200/print_bus_shelf_2.stl

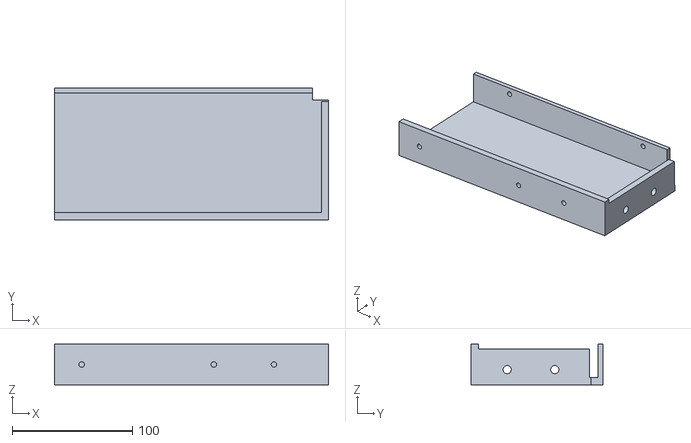
[picture p56: CAD file, 2026-10-23]
battery-box/stl/v12_1200/print_bus_shelf_2.stl
228.0 x 109.6 x 34.0
