dgorman/overlanding/battery-box/stl/v14/print_panel_side_inboard_back_inlay_white.stl

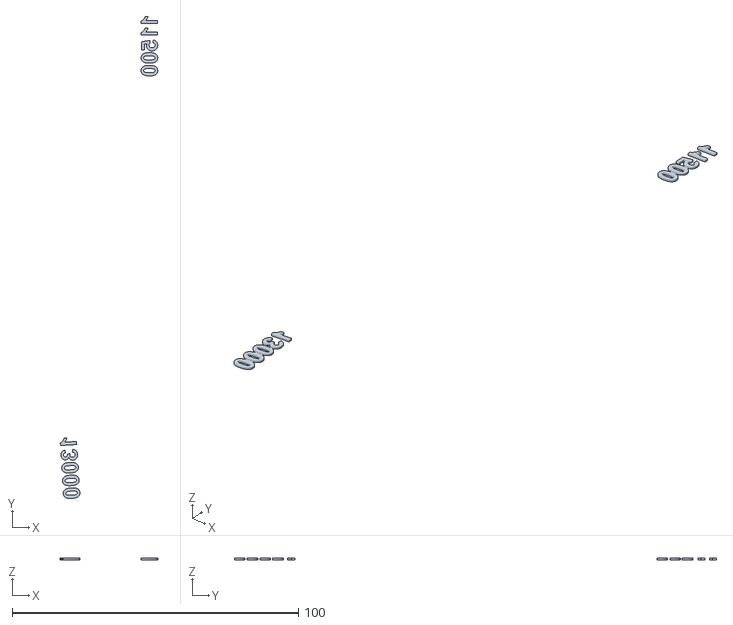
[picture p57: CAD file, 2026-11-13]
battery-box/stl/v14/print_panel_side_inboard_back_inlay_white.stl
34.1 x 168.5 x 0.6
