dgorman/overlanding/battery-box/stl/bookshelf60/print_tray_battery_1.stl

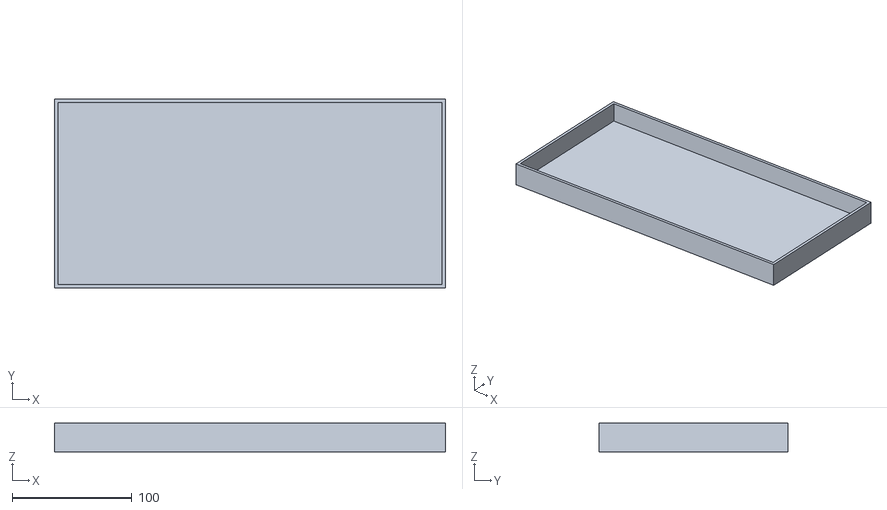
[picture p58: CAD file, 2026-10-23]
battery-box/stl/bookshelf60/print_tray_battery_1.stl
327.0 x 158.0 x 24.0
