dgorman/overlanding/battery-box/stl/pack2/print_pack_shelf_0.stl

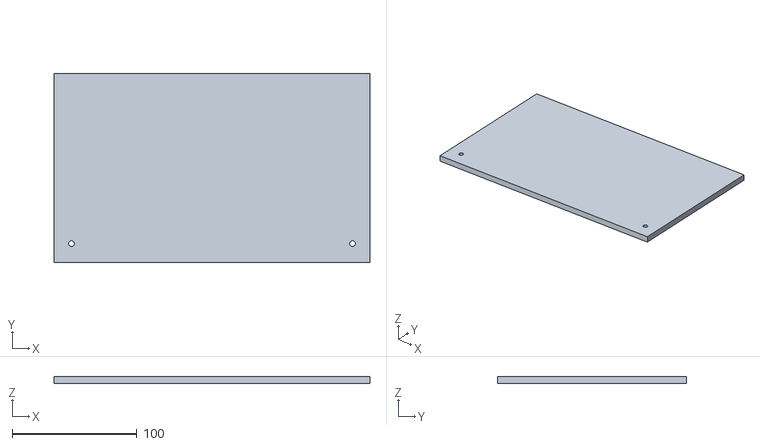
[picture p59: CAD file, 2026-10-23]
battery-box/stl/pack2/print_pack_shelf_0.stl
253.0 x 151.0 x 6.00
