dgorman/overlanding/battery-box/stl/v12_1200/print_tray_battery_0.stl

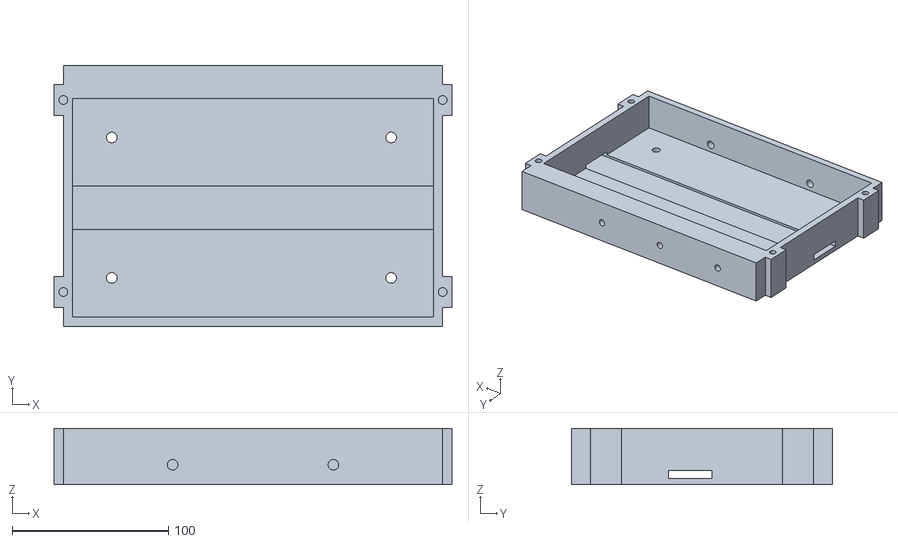
[picture p60: CAD file, 2026-10-23]
battery-box/stl/v12_1200/print_tray_battery_0.stl
255.0 x 167.0 x 36.0
