dgorman/overlanding/battery-box/stl/v12s_pack/print_plate_inverter_tile_20.stl

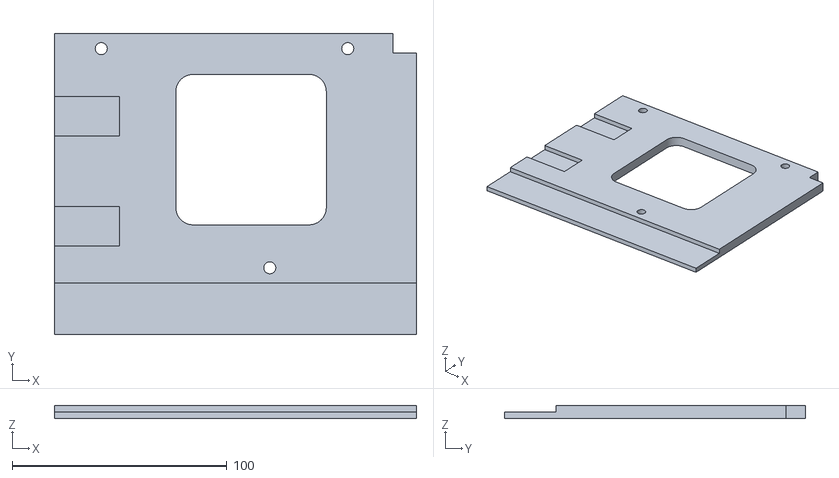
[picture p61: CAD file, 2026-10-31]
battery-box/stl/v12s_pack/print_plate_inverter_tile_20.stl
168.5 x 140.0 x 6.00
