dgorman/overlanding/battery-box/stl/pack2/print_pack_post_289_6_1.stl

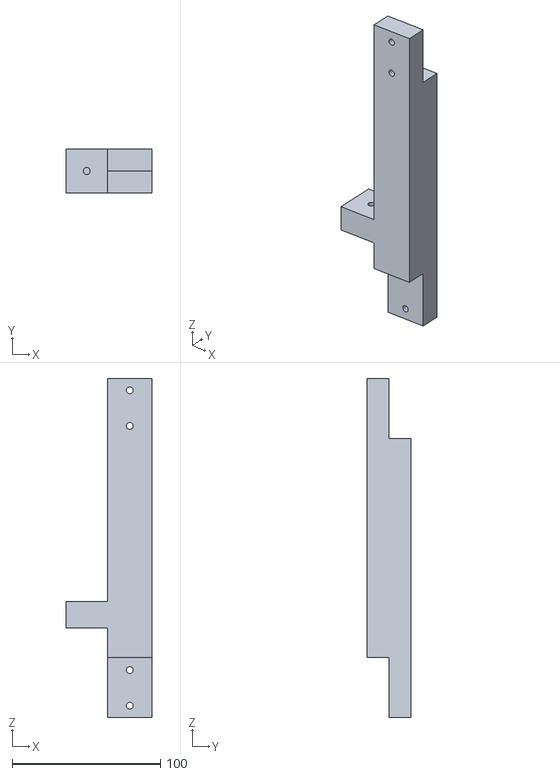
[picture p62: CAD file, 2026-10-23]
battery-box/stl/pack2/print_pack_post_289_6_1.stl
58.0 x 30.0 x 228.7
