dgorman/overlanding/battery-box/stl/v12_1200/print_post_inverter_0.stl

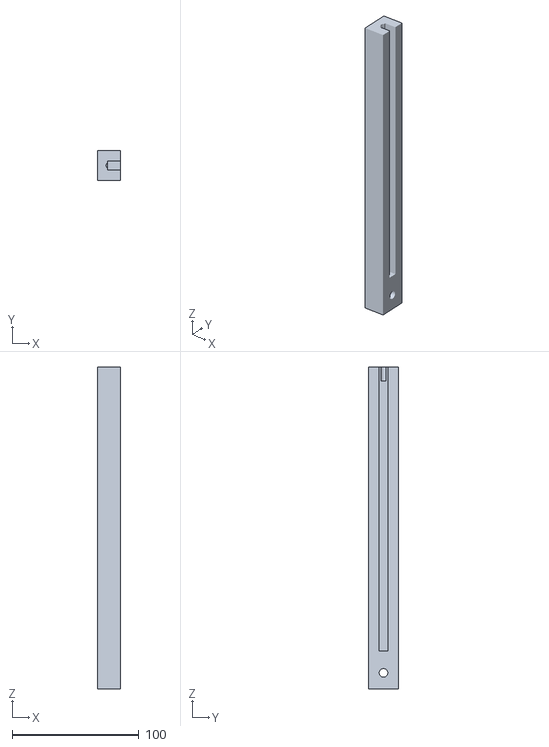
[picture p63: CAD file, 2026-10-23]
battery-box/stl/v12_1200/print_post_inverter_0.stl
18.0 x 24.0 x 254.0
