dgorman/overlanding/battery-box/stl/v14/print_panel_side_inboard_front_inlay_white.stl

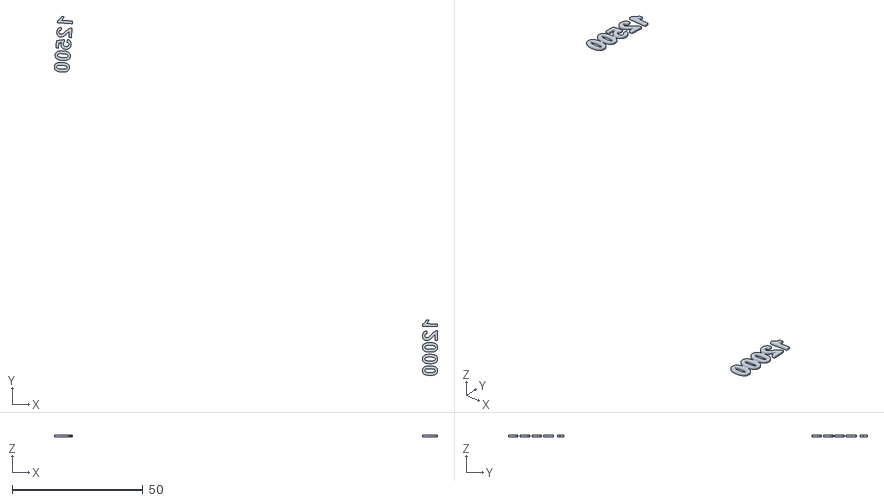
[picture p64: CAD file, 2026-11-13]
battery-box/stl/v14/print_panel_side_inboard_front_inlay_white.stl
146.7 x 137.4 x 0.6
