dgorman/overlanding/battery-box/stl/bookshelf60/print_shelf_1_0.stl

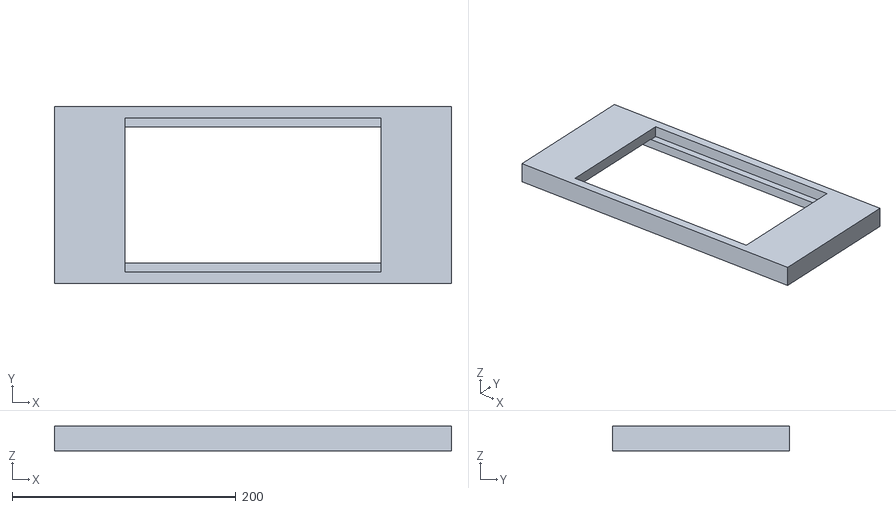
[picture p65: CAD file, 2026-10-23]
battery-box/stl/bookshelf60/print_shelf_1_0.stl
355.0 x 158.0 x 22.0
