dgorman/overlanding/(list of files, cad)

Other CAD files:
battery-box/stl/icebox/print_post_main_0_0.stl
battery-box/stl/cube/print_post_main_0_0.stl
battery-box/stl/icebox/print_post_main_1_2.stl
battery-box/stl/cube/print_post_main_1_1.stl
battery-box/stl/icebox/print_post_main_0_1.stl
battery-box/stl/bookshelf60/print_post_dist_back_1.stl
battery-box/stl/cube/print_cube_010.stl
battery-box/stl/v12s_pack/print_breaker_shelf_0.stl
battery-box/stl/bookshelf/print_post_inverter_front_2.stl
battery-box/stl/bookshelf2/print_cube_111.stl
battery-box/stl/cube/print_cube_100.stl
battery-box/stl/icebox/print_post_dist_0_1.stl
battery-box/stl/v12s/print_breaker_shelf_0.stl
battery-box/stl/v12s_h2d/plate_breaker_shelf.stl
battery-box/stl/v14/print_panel_front_outboard_multicolor.3mf
battery-box/stl/bookshelf2/print_post_dist_back_2.stl
battery-box/stl/bookshelf60/print_cube_110.stl
battery-box/stl/icebox/print_post_dist_1_1.stl
battery-box/stl/master/print_panel_front_outboard_multicolor.3mf
battery-box/stl/v12s/plate_breaker_shelf.stl
battery-box/stl/v12s_h2d/print_breaker_shelf_0.stl
battery-box/stl/bookshelf/print_post_dist_back_0.stl
battery-box/stl/bookshelf2/print_post_dist_front_2.stl
battery-box/stl/bookshelf60/print_post_dist_front_1.stl
battery-box/stl/v12s_pack/plate_breaker_shelf.stl
battery-box/stl/bookshelf/print_cube_110.stl
battery-box/stl/bookshelf2/print_post_inverter_front_0.stl
battery-box/stl/cube/print_cube_101.stl
battery-box/stl/pack2/print_pack_panel_inboard_tile_10.stl
battery-box/stl/v12_1200/print_bus_shelf_0.stl
battery-box/stl/v12s/print_tray_battery_0.stl
battery-box/stl/v14/print_panel_front_inboard_ports_multicolor.3mf
battery-box/stl/bookshelf60/print_post_dist_back_0.stl
battery-box/stl/v12_1200/print_cube_111.stl
battery-box/stl/v12s_h2d/print_tray_battery_0.stl
battery-box/stl/bookshelf/print_post_dist_front_1.stl
battery-box/stl/bookshelf2/print_post_dist_back_1.stl
battery-box/stl/bookshelf60/print_post_inverter_front_0.stl
battery-box/stl/cube/print_post_dist_1_0.stl
battery-box/stl/v12s_pack/print_tray_battery_0.stl
battery-box/stl/bookshelf2/print_feet_mp_218.stl
battery-box/stl/bookshelf60/print_leg_1_0_705_186.stl
battery-box/stl/cube/print_cube_011.stl
battery-box/stl/icebox/print_cube_110.stl
battery-box/stl/pack2/print_pack_panel_front_tile_01.stl
battery-box/stl/bookshelf/print_post_inverter_back_0.stl
battery-box/stl/bookshelf2/print_post_dist_front_1.stl
battery-box/stl/bookshelf60/print_leg_0_0_23_42.stl
battery-box/stl/cube/print_feet_mp_93.stl
battery-box/stl/icebox/print_post_dist_0_2.stl
battery-box/stl/pack2/print_pack_panel_outboard_tile_12.stl
battery-box/stl/v12_1200/print_cube_101.stl
battery-box/stl/v12s_h2d/print_plate_inverter_spline_v1_200.stl
battery-box/stl/v12s_pack/print_plate_inverter_tile_10.stl
battery-box/stl/bookshelf/print_post_inverter_front_1.stl
battery-box/stl/bookshelf2/print_post_inverter_back_1.stl
battery-box/stl/bookshelf60/print_cube_011.stl
battery-box/stl/cube/print_cube_001.stl
battery-box/stl/icebox/print_post_dist_0_0.stl
battery-box/stl/pack2/print_pack_panel_back_tile_11.stl
battery-box/stl/v12s/print_plate_inverter_tile_10.stl
battery-box/stl/v12s_pack/print_plate_inverter_tile_21.stl
battery-box/stl/bookshelf/print_post_dist_back_2.stl
battery-box/stl/bookshelf2/print_cube_010.stl
battery-box/stl/icebox/print_post_dist_1_2.stl
battery-box/stl/master/print_panel_side_outboard_front.stl
battery-box/stl/v12s/print_plate_inverter_tile_01.stl
battery-box/stl/v14/print_panel_side_outboard_back_multicolor.3mf
battery-box/stl/bookshelf/print_leg_0_0_23_186.stl
battery-box/stl/bookshelf2/print_tray_battery_1.stl
battery-box/stl/bookshelf60/print_cube_100.stl
battery-box/stl/cube/print_post_dist_0_1.stl
battery-box/stl/icebox/print_feet_mp_93.stl
battery-box/stl/bookshelf/print_cube_111.stl
battery-box/stl/bookshelf2/print_cube_011.stl
battery-box/stl/cube/print_post_dist_0_0.stl
battery-box/stl/backup/bookshelf/print_cube_000.stl
battery-box/stl/backup/bookshelf/print_cube_001.stl
battery-box/stl/backup/bookshelf/print_cube_010.stl
battery-box/stl/backup/bookshelf/print_cube_011.stl
battery-box/stl/backup/bookshelf/print_cube_100.stl
battery-box/stl/backup/bookshelf/print_cube_110.stl
battery-box/stl/backup/bookshelf/print_cube_111.stl
battery-box/stl/backup/bookshelf/print_feet_mp_218.stl
battery-box/stl/backup/bookshelf/print_leg_0_0_23_186.stl
battery-box/stl/backup/bookshelf/print_leg_0_0_23_42.stl
battery-box/stl/backup/bookshelf/print_leg_1_0_364_186.stl
battery-box/stl/backup/bookshelf/print_leg_1_0_705_186.stl
battery-box/stl/backup/bookshelf/print_leg_1_0_705_42.stl
battery-box/stl/backup/bookshelf/print_post_dist_back_0.stl
battery-box/stl/backup/bookshelf/print_post_dist_back_1.stl
battery-box/stl/backup/bookshelf/print_post_dist_back_2.stl
battery-box/stl/backup/bookshelf/print_post_dist_front_0.stl
battery-box/stl/backup/bookshelf/print_post_dist_front_1.stl
battery-box/stl/backup/bookshelf/print_post_dist_front_2.stl
battery-box/stl/backup/bookshelf/print_post_inverter_back_0.stl
battery-box/stl/backup/bookshelf/print_post_inverter_back_1.stl
battery-box/stl/backup/bookshelf/print_post_inverter_back_2.stl
battery-box/stl/backup/bookshelf/print_post_inverter_front_0.stl
battery-box/stl/backup/bookshelf/print_post_inverter_front_1.stl
battery-box/stl/backup/bookshelf/print_post_inverter_front_2.stl
battery-box/stl/backup/bookshelf/print_shelf_0_0.stl
battery-box/stl/backup/bookshelf/print_shelf_1_0.stl
battery-box/stl/backup/bookshelf/print_tray_battery_0.stl
battery-box/stl/backup/bookshelf2/print_cube_000.stl
battery-box/stl/backup/bookshelf2/print_cube_001.stl
battery-box/stl/backup/bookshelf2/print_cube_010.stl
battery-box/stl/backup/bookshelf2/print_cube_011.stl
battery-box/stl/backup/bookshelf2/print_cube_100.stl
battery-box/stl/backup/bookshelf2/print_cube_110.stl
battery-box/stl/backup/bookshelf2/print_cube_111.stl
battery-box/stl/backup/bookshelf2/print_feet_mp_218.stl
battery-box/stl/backup/bookshelf2/print_post_dist_back_0.stl
battery-box/stl/backup/bookshelf2/print_post_dist_back_1.stl
battery-box/stl/backup/bookshelf2/print_post_dist_back_2.stl
battery-box/stl/backup/bookshelf2/print_post_dist_front_0.stl
battery-box/stl/backup/bookshelf2/print_post_dist_front_1.stl
battery-box/stl/backup/bookshelf2/print_post_dist_front_2.stl
battery-box/stl/backup/bookshelf2/print_post_inverter_back_0.stl
battery-box/stl/backup/bookshelf2/print_post_inverter_back_1.stl
battery-box/stl/backup/bookshelf2/print_post_inverter_back_2.stl
battery-box/stl/backup/bookshelf2/print_post_inverter_front_0.stl
battery-box/stl/backup/bookshelf2/print_post_inverter_front_1.stl
battery-box/stl/backup/bookshelf2/print_post_inverter_front_2.stl
battery-box/stl/backup/bookshelf2/print_tray_battery_0.stl
battery-box/stl/backup/bookshelf2/print_tray_battery_1.stl
battery-box/stl/backup/bookshelf60/print_cube_000.stl
battery-box/stl/backup/bookshelf60/print_cube_001.stl
battery-box/stl/backup/bookshelf60/print_cube_010.stl
battery-box/stl/backup/bookshelf60/print_cube_011.stl
battery-box/stl/backup/bookshelf60/print_cube_100.stl
battery-box/stl/backup/bookshelf60/print_cube_110.stl
battery-box/stl/backup/bookshelf60/print_cube_111.stl
battery-box/stl/backup/bookshelf60/print_feet_mp_218.stl
battery-box/stl/backup/bookshelf60/print_leg_0_0_23_186.stl
battery-box/stl/backup/bookshelf60/print_leg_0_0_23_42.stl
battery-box/stl/backup/bookshelf60/print_leg_1_0_364_186.stl
battery-box/stl/backup/bookshelf60/print_leg_1_0_705_186.stl
battery-box/stl/backup/bookshelf60/print_leg_1_0_705_42.stl
battery-box/stl/backup/bookshelf60/print_post_dist_back_0.stl
battery-box/stl/backup/bookshelf60/print_post_dist_back_1.stl
battery-box/stl/backup/bookshelf60/print_post_dist_back_2.stl
battery-box/stl/backup/bookshelf60/print_post_dist_front_0.stl
battery-box/stl/backup/bookshelf60/print_post_dist_front_1.stl
battery-box/stl/backup/bookshelf60/print_post_dist_front_2.stl
battery-box/stl/backup/bookshelf60/print_post_inverter_back_0.stl
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
