dgorman/overlanding/battery-box/manual/audit-2026-10-30.md

# Audit against the box as built (2026-10-30)

Done before the 22.5 in redo, against the donor IceBox 1.3 and the rails already cut. Each line says what was modelled, what is real, and what changed.

| Item | Was modelled | Real / decided | Done |
|---|---|---|---|
| Rail section | 25.4 mm (1 in, 10-series) | **25 × 25 mm metric 25-series**; slot 6.5 mm (the 6000N501 drop-in nuts fit, user to confirm in a slot) | model `bar=25.0`; slot centrelines now 12.5 up |
| Corner cubes | 25.4 | **25.75**; stand 0.375–0.75 proud of the rail faces at every corner | model `cube=25.75`; trays notched 2 mm at the corner that meets two rails; panel tongues stop at the cubes |
| Height rails | 231.2 | **cut to 230.2** (9 1/16 in) | box height 281.7; clips 27.7; hangers follow |
| Depth rails | 584.2 uncut, box 635 (25 in) | **cut to 520.0**, box 571.5 (22.5 in) | 4 cuts + 4 taps still to do |
| Width rails | 436.6 uncut | unchanged; box width 488.1 with the real cubes | |
| Bottom front width rail | assumed from the donor | **donor has none**; mod-kit x.31 bar ordered | docs |
| Lid | full 635 × 487 sheet on top | the IceBox top panel is slot-captured and too small; **user sourcing a flat 571.5 × 488 panel** (lid) and optionally a floor; both bolt to the rails' free top/bottom-face slots | model draws the lid as a flat sheet on top at the real size; nothing printed mounts to it |
| Floor | none | none (trays hang from the rails; a flat floor can be added under the frame later) | |
| Garmin PowerSwitch | plate's inverter face, 59 mm in front of the MultiPlus cable end | at 571.5 deep that gap is 21 mm: **on a two-piece full-height printed hanger panel between the top and bottom inboard rails** (user's idea), in the 76 mm lane beside the MultiPlus, 20 mm behind the port bodies, with 5 rows of cable-tie slots; feed through the plate window | `print_garmin_hanger` + `print_garmin_hanger_lower`: 4 countersunk 1/4-20 + 4 drop-in nuts (24 total in box), 2 short M4 inserts |
| Bus shelf | 3 equal plates | **end plates unchanged (194.7, as printed)**, middle plate 132 + tongue | `shelf_end_len` |
| Inverter plate | 6 tiles 189 × 140 | 6 tiles 168.5 × 140, window and layout moved with the front rail | |
| Screws | 1/4-20 × 3/4 everywhere; M4 × 10, M5 × 12 | per joint: 1/2 in on the 6 mm walls, 7/8 in for the clips and sills; M4 × 8 band/Cerbo/Orion; M4 × 35 clip-to-post; M5 × 10 keyholes/breakers; M5 × 8 MPPT (order 3 placed) | manual hardware table |
| Countersinks | counterbores cut in the air | 82° cones, probed by `--clash` (16/16) | since 2026-10-25 |
| Plate pilots | bottom band missing | all pilots probed by `--clash` (22/22) | since 2026-10-25 |
| Top front width rail | assumed present | **unverified**: confirm the donor has it (the post clip and the lid hold-down use it) | ask |
| Rail on cube offset | flush | flush on the outside faces assumed; if the rails are centred on the cubes every tie is 0.375 off, inside the bolt-hole play | note |
| Cube screw thread | 1/4-20 | **unverified**: 25-series bores are M6-sized; check a donor cube screw against a 1/4-20 nut before tapping | ask |

Slot ledger (what occupies each slot of each rail, so no two parts claim one):

| Rail | top face | bottom face | inner face | outer face |
|---|---|---|---|---|
| bottom depth rails | side panel tongue | free (floor, if any) | outboard: tray outer walls (2 per tray); inboard: the Garmin hanger's lower plate (2) | free |
| top depth rails | free (lid hold-down) | side panel tongue | outboard: drop-shelf hangers (2 per shelf); inboard: the Garmin hanger plate (2) | free |
| bottom width rails | back/front panel tongue | free (floor) | tray end wall (2), bus shelf end wall (2), post sill (1) | free |
| top width rails | free (lid hold-down) | back/front panel tongue | post clip (1) | free |
