dgorman/overlanding/battery-box/manual/img/part-print_bus_shelf_1.png

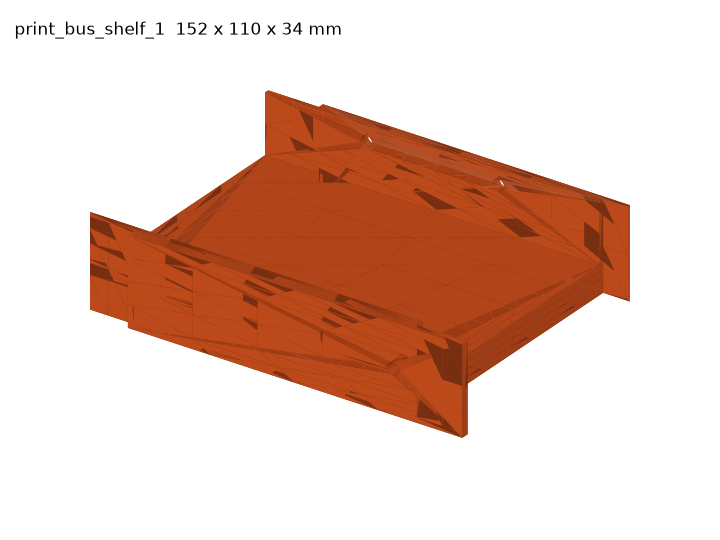
battery-box/manual/img/part-print_bus_shelf_1.png
