dgorman/overlanding/battery-box/v14_200ah_battery_and_bms_verification.jpg

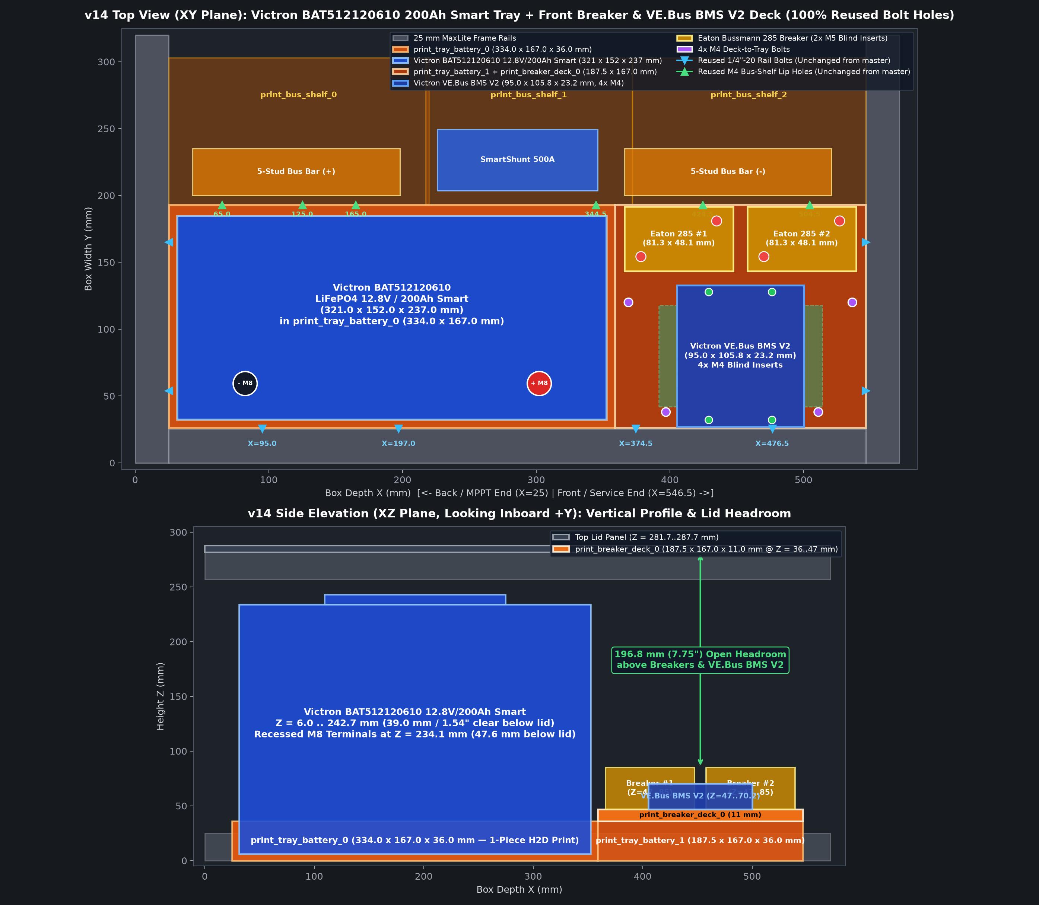
battery-box/v14_200ah_battery_and_bms_verification.jpg
