dgorman/overlanding/(commit log)

2026-09-25 Document Goose Gear IceBox 1.3 matching parts research
2026-09-25 Add bevel-matching options: Goose Gear mod kit, TSLOTS quarter round
2026-10-04 Add 4Runner electronics card cage: concept, parametric CAD, STLs, viewer
    Replaces the plywood battery box with a MaxLite-framed box whose small
    electronics ride on a drop-in card. Two Victron SuperPack 60Ah batteries
    and the MultiPlus 12/1200 stay on the floor; MPPT stands under the card.
    - battery-box/README.md: design, layout, printed parts, cut list,
    Phase 2 (4 batteries + MultiPlus-II) envelope check, open questions
    - battery-box/components.md: datasheet dims + sources for every unit
    - cad/cage.py: CadQuery model, fit report, STL/GLB export
    - cad/render.py: shaded PNG views
    - stl/: 23 printable parts, viewer/: three.js GLB viewer, photos/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
    [print_bracket_mppt.stl, print_cradle_multiplus_00.stl, print_cradle_multiplus_01.stl, print_cradle_multiplus_10.stl, print_cradle_multiplus_11.stl, print_cube_000.stl, print_cube_001.stl, print_cube_010.stl]
2026-10-04 Card cage: IceBox 1.3 in the model, kit-bar + printed-rail frame, confirmed inventory
    - IceBox 1.3 (19-3/16 x 22 x 25 in) modelled with its slotted back panel
    against the cage end; ghosted/toggleable in the viewer, new renders
    - No off-the-shelf extrusion: allocate_rails() splits the 4 mod kits'
    bars (count/length still unverified) across the short rails and the
    first 635 mm of each long rail, prints the rest as 250 mm segments
    with cross-shaped splices
    - Inventory per owner: MultiPlus 12/800/35 (360x240x100, 6.4 kg) replaces
    the 12/1200 guess; unidentified parts dropped; 2x Anderson SB50 solar
    ingress cut into the far end panel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
    [print_cradle_multiplus_00.stl, print_cradle_multiplus_01.stl, print_cradle_multiplus_10.stl, print_cradle_multiplus_11.stl, print_rail_0_1.stl, print_rail_0_2.stl, print_rail_1_1.stl, print_rail_1_2.stl]
2026-10-04 Card cage v2: half-depth twin of the IceBox 1.3 with three drop-in cards
    Owner's framing: another IceBox 1.3 at half depth, everything on cards
    that slide down from the top. Outer 317.5 x 487.4 x 558.8 mm.
    - Rear layer: two SuperPacks stacked (printed tray + mid-shelf) outboard,
    a distribution card (breakers, SmartShunt, bus bars, Cerbo) inboard in
    its own printed guides
    - Lower card: MultiPlus 12/800 on its side on printed feet; upper card:
    MPPT 100/30 and Orion XS upright, Garmin PowerSwitch above
    - Removable front panel with vent slots + socket insert; Anderson SB50
    solar inlets in the inboard side
    - Frame: 8 kit bars take the height/width rails, depth rails print
    - Report now g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
    [print_bracket_mppt.stl, print_cradle_multiplus_00.stl, print_cradle_multiplus_01.stl, print_cradle_multiplus_10.stl, print_cradle_multiplus_11.stl, print_cube_001.stl, print_cube_010.stl, print_cube_011.stl]
2026-10-04 Card cage: frame from 16 kit bars with a cut plan, no printed rail
    Four more Extrusion Frame Modification Kits ordered (8 total, 16 bars).
    Each bar is an IceBox width rail (~437 mm). allocate_rails() is now a
    cut-plan allocator over the bar pool: height rails = full bar + 71 mm
    piece (all four pieces from one bar) with a printed splice, width rails
    = full bars, depth rails = bars cut to 267. 13 bars used, 3 spare.
    [print_rail_d0_0.stl, print_rail_d0_1.stl, print_rail_d1_0.stl, print_rail_d1_1.stl, print_rail_d2_0.stl, print_rail_d2_1.stl, print_rail_d3_0.stl, print_rail_d3_1.stl]
2026-10-04 Card cage v3: 487 mm cube from 12 uncut kit bars, rail-bolted guide posts
    - No cutting: every rail is one full ~437 mm kit bar, so the frame is
    487.4 mm each way (IceBox width, 71 mm lower than the IceBox); 4 bars spare
    - Card guides are now printed posts with feet that bolt through the floor
    panel into the bottom rail T-slot and up into the top rail; the dist
    card's divider post reaches back to the back width rails. Nothing
    depends on side panels any more
    - Panels screw to the outside of the bars (Goose Gear style); the floor
    panel rests on the bottom rails
    - Batteries end to end in depth (431 mm inner height can't take a stack),
    one printed tray each; Garmin joins the upper ca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
    [print_cube_001.stl, print_cube_010.stl, print_cube_011.stl, print_cube_100.stl, print_cube_101.stl, print_cube_110.stl, print_cube_111.stl, print_feet_mp_343.stl]
2026-10-04 Card cage v4: four SuperPacks in the cube, dist card in the front layer
    - Three batteries upright in a row (one printed tray each) with the
    fourth on its long side on a two-piece printed shelf; Victron permits
    upright or long side. Stack is 379 of 431 mm.
    - Distribution card moves to the front layer, full width, parts facing
    the removable front panel: breakers, shunt, bus bars, Cerbo, Garmin.
    Sockets in the panel's top band clear its parts by 9 mm.
    - Lower card gets 60 mm corner notches so the 6 AWG battery runs pass the
    main cards; two spare kit bars become floor joists under the batteries.
    - Report prints the battery stack and the depth chain; ~57 kg.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
    [print_feet_mp_343.stl, print_feet_mp_93.stl, print_post_dist_0_0.stl, print_post_dist_0_1.stl, print_post_dist_1_0.stl, print_post_dist_1_1.stl, print_post_dist_div_0.stl, print_post_dist_div_1.stl]
2026-10-04 Card cage v5: second-IceBox variant alongside the v4 cube
    cage.py now takes a variant: 'cube' (v4, tagged cage-v4-cube) or
    'icebox' (v5: a stock IceBox 1.3 frame, 635 x 487 x 559, fridge slide
    removed). v5 has 502 mm inside so the four SuperPacks go in two upright
    stacks of two on printed mid-shelves, with 149 mm beside them for a third
    stack; the dist card moves right up to the front panel, leaving 132 mm
    of air behind it for a future card. Kit bars are not needed for v5.
    Renders and STLs are per variant; the viewer gets a version switch and
    loads cage-cube.json / cage-icebox.json. README adds a Versions table.
    [print_cube_000.stl, print_cube_001.stl, print_cube_010.stl, print_cube_011.stl, print_cube_100.stl, print_cube_101.stl, print_cube_110.stl, print_cube_111.stl]
2026-10-05 Card cage: MPPT + Cerbo on the dist card, battery stacks at the walls, inverter sizing check
    - Dist card (front) now carries the MPPT next to the shunt, with the
    Cerbo and Garmin; the upper card keeps only the Orion
    - v5 battery stacks justified to the side walls, 145 mm channel between
    - cage.py takes --inverter=multiplus|multiplus_ii|multiplus_4k and reports
    the fit: the MultiPlus-II 12/3000 (578 mm) and 12/4k (631 mm) do not
    fit a 437 mm card in any orientation
    - README: inverter sizing table against four SuperPack 60Ah (30 A
    continuous each = 120 A, ~1.5 kW); SuperPack weight corrected to 7.5 kg
    from the Victron datasheet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
    [print_post_dist_0_0.stl, print_post_dist_0_1.stl, print_post_dist_0_2.stl, print_post_dist_1_0.stl, print_post_dist_1_1.stl, print_post_dist_1_2.stl, print_shelf_stack_1.stl, print_tray_battery_1.stl]
2026-10-05 Card cage: name the cards (distribution, inverter/charger) and the battery bay
2026-10-05 Card cage v6 draft: side-mount cards front to back for a MultiPlus-II
    Third variant 'bookshelf': the inverter/charger and distribution cards
    run along the inboard wall in the XZ plane, sliding down between posts on
    the back and front width rails. MultiPlus-II 12/3000 on its side on
    12 mm standoffs (578 on a 567 card, 3 mm to the end rails), MPPT + Orion
    above it; dist card with bus bars, shunt, breakers, VE.Bus BMS V2, Cerbo,
    Garmin facing the battery column. Battery column 180 mm wide: two
    Lithium Smart 100Ah stacked (200 Ah), tray + mid-shelf with a back-rail
    tab and printed front legs into the joists, independent of the cards.
    Viewer gets the third version; README has the Y-stack table.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
    [print_cube_000.stl, print_cube_001.stl, print_cube_010.stl, print_cube_011.stl, print_cube_100.stl, print_cube_101.stl, print_cube_110.stl, print_cube_111.stl]
2026-10-05 Card cage: owner's IceBox is the 30" model; v6 column = two Lithium Smart 200Ah end to end
    - icebox_D / v5 / v6 frame depth 635 -> 762 (711 inside); renders redone
    - v6 battery column: --column and --arrange options; default is two
    Lithium Smart 12.8/200 end to end (662 of 711 deep, 400 Ah, 400 A rec),
    one printed tray each, no shelf. A stacked arrangement now gets a
    printed rack with four legs through the floor into the joists
    - README/components/viewer updated; Victron allows mixed capacities in
    parallel (max 20)
    [print_cube_100.stl, print_cube_101.stl, print_cube_110.stl, print_cube_111.stl, print_feet_mp_132.stl, print_feet_mp_506.stl, print_feet_mp_570.stl, print_feet_mp_68.stl]
2026-10-05 Card cage v6: 2 x 200Ah column with 20 mm vents, plus a 4 x 200Ah 2x2 variant with a printed rack
    - Column widened to 192 mm (Victron's 20 mm vent gap on every side of a
    Lithium Smart) by moving the Cerbo up to the inverter card and trimming
    the standoff/gaps; two 200Ah end to end use 702 of 711 mm
    - New 'bookshelf4' variant: two stacks of two 200Ah in a printed rack
    (trays, mid-shelves, six 14 mm legs in three rows bolted through the
    floor into the joists). Fits only with 15 mm end gaps and 11 mm above
    the top lugs; README recommends against it
    - Column height now checked against the lid underside (527) rather than
    the rail underside, since the column sits inboard of the rails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
    [print_cube_000.stl, print_cube_001.stl, print_cube_010.stl, print_cube_011.stl, print_cube_100.stl, print_cube_101.stl, print_cube_110.stl, print_cube_111.stl]
2026-10-05 Card cage v6: MultiPlus 12/1200, four 200Ah in a 2x2 rack, Victron STEP geometry
    - Inverter is the owner's MultiPlus 12/1200/50 (406x250x100); column widens
    to 240 mm. 'bookshelf' = 2x2 of Lithium Smart 200Ah on the plate (user's
    choice), 'bookshelf2' = two end to end
    - Real Victron STEP bodies (housing solids only, cached as BREP, raw files
    gitignored with URLs in components.md); MPPT flipped 180 about the card
    axis so the fins sit on the card and the terminals point down
    - Battery column stands on the Goose Gear plate (floor cut away under it):
    43 mm over the top lugs in the 2x2
    - glTF repacked to one primitive per mesh without normals (viewer computes
    them); model files 4-6 M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
    [print_cube_000.stl, print_cube_001.stl, print_cube_010.stl, print_cube_011.stl, print_cube_100.stl, print_cube_101.stl, print_cube_110.stl, print_cube_111.stl]
2026-10-05 Card cage v6: narrow 440 mm frame, SuperPack-in-200Ah-trays check, dimension lines
    - narrow=True sizes the frame width from the Y stack (column tray + 20 mm
    vents + cards): 440 mm, 48 mm narrower than the IceBox for bike pedals;
    width rails are kit bars cut to 389. pedal_gap adds slack back
    - bookshelf60: the owner's four SuperPack 60Ah in the 200Ah trays (fits
    with 92 x 14 mm of slack -> printed spacer blocks), 240 Ah
    - dims_bookshelf() writes dims-<variant>.json; the viewer draws labelled
    dimension lines with a toggle
    [print_cube_000.stl, print_cube_001.stl, print_cube_010.stl, print_cube_011.stl, print_cube_100.stl, print_cube_101.stl, print_cube_110.stl, print_cube_111.stl]
2026-10-05 Card cage v7: 345 mm wide, four SuperPack 60Ah touching, lengthwise cards in front
    - 200Ah Smarts and MultiPlus-II shelved
    - Battery bay at the IceBox end on the plate: two touching stacks of two
    SuperPack 60Ah in printed trays/shelves/legs (294 of 294 wide, 266 deep)
    - Two spare kit bars cut to the inner width as cross-members top and
    bottom at the bay's front edge (printed corner brackets); they stop the
    batteries and carry the rear card posts
    - Inverter/charger and distribution cards lengthwise in front (396 x 494):
    MultiPlus 12/1200 upright + Orion + Cerbo; bus/shunt/breakers/MPPT/Garmin.
    96 mm of cable space against the outboard wall
    - 5.6 in narrower than the IceBox for bike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
    [print_bracket_bot_25.stl, print_bracket_bot_289.stl, print_bracket_top_25.stl, print_bracket_top_289.stl, print_cube_000.stl, print_cube_001.stl, print_cube_010.stl, print_cube_011.stl]
2026-10-05 Card cage v7: port wall pulled in to the gear (642 deep), printed lattice cards
    - depth='fit': frame depth = battery bay + cross-bar + 280 mm card zone,
    642 x 345 x 559 (4.7 in shorter in depth, 5.6 in narrower, same height)
    - Cards are 2 x 2 ribbed printed tiles (141 x 247 x 6) joined by splines;
    the 12/1200 stands upright alone on its card, Orion and Cerbo move to
    the distribution card
    - 9 mm rack legs so the shelves fit the bed; IceBox depth rails cut to 592
    [print_bracket_bot_25.stl, print_bracket_bot_289.stl, print_bracket_top_25.stl, print_bracket_top_289.stl, print_card_dist_spline_h1_397.stl, print_card_dist_spline_h1_427.stl, print_card_dist_spline_h1_467.stl, print_card_dist_spline_h1_527.stl]
2026-10-05 Card cage v8: three cards across the box, 598 x 345 x 559
    - v7's battery bay (four SuperPack 60Ah, two touching stacks on the plate)
    with the cards turned to face across the box like v4: inverter card
    (12/1200 upright + shunt), charge card (MPPT, Orion, Cerbo, Garmin),
    distribution card (bus bars, breakers). Each card only costs its own
    thickness in depth: 6.5 in shorter than the IceBox
    - Posts on the depth rails, no cross-members; sockets in the front
    panel's lower band; printed 2 x 2 lattice tiles per card
    - README: v8 section, v7 depth update, printed-card notes
    [print_card_charge_spline_h1_138.stl, print_card_charge_spline_h1_207.stl, print_card_charge_spline_h1_69.stl, print_card_charge_spline_v1_123.stl, print_card_charge_spline_v1_246.stl, print_card_charge_spline_v1_370.stl, print_card_charge_tile_00.stl, print_card_charge_tile_01.stl]
2026-10-05 Card cage: how units attach to the printed cards
    Mounting hole patterns per unit (Victron drawings; bus bar/breaker/Garmin
    marked verify). Lattice tiles grow a 22 mm solid boss with a 4.6 mm
    pilot at every hole for heat-set inserts (M4/M5/M6 by unit); the
    MultiPlus gets M6 through-bolts with printed backing plates and sits on
    its feet. Report prints the fastener list. v7 renders added.
    [print_backing_inverter_14_343.stl, print_backing_inverter_14_99.stl, print_backing_inverter_235_343.stl, print_backing_inverter_235_99.stl, print_card_charge_tile_00.stl, print_card_charge_tile_01.stl, print_card_charge_tile_10.stl, print_card_charge_tile_11.stl]
2026-10-05 README: insert counts match the report
2026-10-05 Card cage: MultiPlus stands on 18 mm printed feet, bosses follow
    [print_backing_inverter_14_343.stl, print_backing_inverter_14_99.stl, print_backing_inverter_235_343.stl, print_backing_inverter_235_99.stl, print_card_dist_tile_00.stl, print_card_dist_tile_01.stl, print_card_dist_tile_10.stl, print_card_dist_tile_11.stl]
2026-10-05 Card cage: MultiPlus bosses on the 374.6 mm body, solid card region under the inverter
    The datasheet's 406 mm includes the bracket; the STEP body is 374.6.
    Keyholes now 68 / 311.8 mm above the body bottom. Lattice tiles keep
    the inverter footprint (+10 mm) solid so it can be re-drilled.
    [print_backing_inverter_14_311.stl, print_backing_inverter_14_68.stl, print_backing_inverter_234_311.stl, print_backing_inverter_234_68.stl, print_card_charge_spline_h1_138.stl, print_card_charge_spline_h1_207.stl, print_card_charge_spline_h1_69.stl, print_card_charge_spline_v1_123.stl]
2026-10-05 Card cage: all cards printed as solid 6 mm tiles
    Same construction as the region under the inverter, on every card in v7
    and v8: pilot holes for inserts, splined 2 x 2 tiles, nothing threaded
    through the card so it still lifts out. Lattice kept as an option.
    [print_card_charge_tile_00.stl, print_card_charge_tile_01.stl, print_card_charge_tile_10.stl, print_card_charge_tile_11.stl, print_card_dist_tile_00.stl, print_card_dist_tile_01.stl, print_card_dist_tile_10.stl, print_card_dist_tile_11.stl]
2026-10-05 Card cage v9: bus deck on the battery rack, two cards that unplug and lift alone
    - Printed 6 mm deck on extended rack legs at 468 mm: bus bars, two
    battery breakers, SmartShunt, SB175 + 3 x SB50 receptacles at its front
    edge, hand window over the lugs
    - Two cards (inverter + SB175 pigtail; MPPT/Orion/Cerbo/Garmin + SB50s),
    nothing wired card to card; 539 x 345 x 559
    - Cable/fuse/connector table from the Victron manuals in the report and
    README (12/1200: 2 AWG + 150 A; Orion XS: 6 AWG + 60-70 A; MPPT: 10 AWG + 40 A)
    [print_backing_inverter_14_311.stl, print_backing_inverter_14_68.stl, print_backing_inverter_234_311.stl, print_backing_inverter_234_68.stl, print_bus_deck.stl, print_card_charge_spline_h1_138.stl, print_card_charge_spline_h1_207.stl, print_card_charge_spline_h1_69.stl]
2026-10-05 Card cage v9: wiring room (70 mm deck-to-inverter card, 45 mm card-to-ports), 636 deep; inverter run 4 AWG
    [anderson_sb50_housing.stp, print_backing_inverter_14_311.stl, print_backing_inverter_14_68.stl, print_backing_inverter_234_311.stl, print_backing_inverter_234_68.stl, print_card_charge_spline_h1_138.stl, print_card_charge_spline_h1_207.stl, print_card_charge_spline_h1_69.stl]
2026-10-05 Card cage v9: real Anderson SB175/SB50 housings, sideways-unplug layout, every part fits the P1S bed
    - Anderson STEP housings on the deck, mating axis across the box; the
    cards' flying halves mate from the inboard side and pull off sideways
    (25 / 15 mm) from above. Report checks the travel room
    - Rack legs split into two 12 mm segments on a tenon, top segment ends in
    a 16 mm boss with an M4 insert; deck in two 255 x 147 halves on splines,
    8 x M4 into the bosses; shelves 237 long. No part exceeds the bed
    - README: connector explanation, printing and assembly table; components:
    Anderson file sources
    [anderson_sb175_housing.stp, print_backing_inverter_14_311.stl, print_backing_inverter_14_68.stl, print_backing_inverter_234_311.stl, print_backing_inverter_234_68.stl, print_bus_deck_0.stl, print_bus_deck_1.stl, print_bus_deck_spline_127.stl]
2026-10-05 Card cage v9: each card carries its own upward-facing Andersons; deck extended with forward-facing halves
    Inverter card: SB175 on its rear face at the bottom. Charge card: 3 x SB50
    rear (deck pigtails) + 2 x SB50 front (panel inlets). Pigtail halves lift
    off before a card is pulled. Deck gains a 40 mm extension carrying its
    halves pointed at the cards with room to unplug forward. 657 deep.
    [print_bus_deck_ext_0.stl, print_bus_deck_ext_1.stl, print_bus_deck_ext_spline_0.stl, print_bus_deck_ext_spline_1.stl, print_card_charge_spline_h1_138.stl, print_card_charge_spline_h1_207.stl, print_card_charge_spline_h1_69.stl, print_card_charge_spline_v1_123.stl]
2026-10-05 Card cage v9: card connectors at the top of the rear faces; charge card's inlet SB50s join the rear row
2026-10-05 Card cage v9: cards cut down 25 mm; connector stacks leave 35 mm of cable room under the lid
    [print_card_charge_spline_h1_138.stl, print_card_charge_spline_h1_207.stl, print_card_charge_spline_h1_69.stl, print_card_charge_spline_v1_117.stl, print_card_charge_spline_v1_234.stl, print_card_charge_spline_v1_351.stl, print_card_charge_tile_00.stl, print_card_charge_tile_01.stl]
2026-10-05 Card cage v9: cards cut down 50 mm (444 tall), 60 mm of cable room under the lid
    [print_card_charge_spline_h1_138.stl, print_card_charge_spline_h1_207.stl, print_card_charge_spline_h1_69.stl, print_card_charge_spline_v1_110.stl, print_card_charge_spline_v1_221.stl, print_card_charge_spline_v1_332.stl, print_card_charge_tile_00.stl, print_card_charge_tile_01.stl]
2026-10-05 Card cage v9: Garmin PP45 block, stronger battery rack, assembly procedure
    - Powerpole PP45 block (10 AWG, 4 circuits) at the top of the charge card's
    front face for the Garmin socket harness, mating face up
    - Rack: 6 mm tray walls, 30 mm lips, 4 x M6 per tray into the plate, strap
    slots; shelves with 15 mm lips screwed M4 through their end walls into
    inserts in the legs; loads explained in the report and README
    - README: 7-step assembly order, rack strength table, ASA recommendation
    [print_backing_inverter_14_311.stl, print_backing_inverter_14_68.stl, print_backing_inverter_234_311.stl, print_backing_inverter_234_68.stl, print_bus_deck_0.stl, print_bus_deck_1.stl, print_bus_deck_ext_0.stl, print_bus_deck_ext_1.stl]
2026-10-05 Renders for v9 (bus deck, upward-facing card connectors, strengthened rack)
2026-10-06 Card cage v9: tray L tabs onto the bottom rails, guide-post feet on the rails
    Each battery tray gets two integral L tabs on its outer side wall (flange on
    the depth rail, 1/4-20 T-nut) and two printed back brackets (M5 into pads on
    the back wall, T-nut into the back width rail) so the frame carries the
    stacks when the box is lifted as one unit; the tray floor stays flat on the
    plate. Guide-post bottom feet step down 6 mm to sit on the depth rail
    instead of floating above it beside the floor panel; hole on the slot
    centreline; feet no longer poke through the side panels. README dims
    corrected to 661 x 353 (6 mm tray walls).
    [print_post_charge_0_0.stl, print_post_charge_0_2.stl, print_post_charge_1_0.stl, print_post_charge_1_2.stl, print_post_inverter_0_0.stl, print_post_inverter_0_2.stl, print_post_inverter_1_0.stl, print_post_inverter_1_2.stl]
2026-10-06 Card cage v9: rack connections reworked (foot tabs, half-lap legs, deck ties, lengthwise straps)
    Audit of how the battery supports connect found four broken joints: leg
    feet collided with the bottom rails and each other and bolted to the plate
    (so the box could not lift as a unit); the shelf's M4 landed in the leg
    tenon pocket; the deck's M4 holes were 1 mm from the deck edge; the
    crosswise strap slots were blocked by the touching trays and the rail.
    Now: trays get corner pads with M4 inserts; each lower leg stands on the
    plate and has a foot tab screwed to its pad; the two leg segments join on a
    37 mm half-lap that the shelf's end-wall M4 pins (one screw, shelf + lap);
    each upper leg ends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
    [print_bus_deck.stl, print_bus_deck_0.stl, print_bus_deck_1.stl, print_bus_deck_ext_0.stl, print_bus_deck_ext_1.stl, print_bus_deck_ext_spline_0.stl, print_bus_deck_ext_spline_1.stl, print_bus_deck_spline_122.stl]
2026-10-06 Card cage v9: flush card backs, strap slot cleared
    The "bumps" on the card backs were the 3 mm splines glued across the tile
    joints and the MultiPlus backing plates. Splines now sit in 3 mm pockets
    recessed into the back face (tiles print front face down, pockets up) and
    the backing plates are replaced by M6 fender washers, so the back of each
    card is flat apart from its Anderson halves. The tray's back bracket pads
    moved from y 30-70 to 18-58 so they no longer half-cover the lengthwise
    strap slot at 61-89.
    [print_backing_inverter_14_311.stl, print_backing_inverter_14_68.stl, print_backing_inverter_234_311.stl, print_backing_inverter_234_68.stl, print_card_charge_spline_h1_142.stl, print_card_charge_spline_h1_213.stl, print_card_charge_spline_h1_71.stl, print_card_charge_spline_v1_110.stl]
2026-10-06 Card cage v9: two-tile cards on a half-lap, posts stood off the rails
    Guide posts move 18 mm in from the depth rails (post_standoff), so each
    card is 249 mm wide and prints as two 249 x 234 x 6 tiles instead of four.
    The tiles meet on a 24 mm half-lap across the card's middle: the lower tile
    keeps the back half of the strip, the upper the front half, so each prints
    flat with its rabbet facing up and needs no supports; glued and bolted with
    3 x M4 through the lap. Splines remain only for vertical joints (legacy
    variants). Inverter card is exactly the MultiPlus width (unit at y=0);
    Garmin PowerSwitch turned 90 deg beside the Orion (garmin_up); the SB50 row
    re-pitched to 47 mm; the solid-foot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
    [print_card_charge_spline_h1_142.stl, print_card_charge_spline_h1_213.stl, print_card_charge_spline_h1_71.stl, print_card_charge_spline_v1_110.stl, print_card_charge_spline_v1_221.stl, print_card_charge_spline_v1_332.stl, print_card_charge_tile_00.stl, print_card_charge_tile_01.stl]
2026-10-06 Card cage v10 study: full-length deck, charge card removed
    cage.py v10 = v9 with deck="full": the bus deck continues past the inverter
    card through a slot (middle plates to the card, front plates ahead of it on
    post ledges and front corner-bar ties). MPPT, Garmin and Cerbo lie on the
    front plate, the Orion on the middle plate, bus bars/breakers/shunt over the
    rack; the charge card, its posts and its five SB50s are gone, only the
    inverter keeps an SB175. 634 deep: 27 mm shorter than v9, because MPPT 186 +
    Orion 123 = 309 exceeds the 302 mm deck width so they can't share the front
    plate. Report lists fits, lid clearances, coverage and the Victron
    vertical-mounting caveat. Viewer gets the v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
    [print_bus_deck_0.stl, print_bus_deck_1.stl, print_bus_deck_ext_0.stl, print_bus_deck_ext_1.stl, print_bus_deck_ext_spline_0.stl, print_bus_deck_ext_spline_1.stl, print_bus_deck_front_0.stl, print_bus_deck_front_1.stl]
2026-10-06 Revert "Card cage v10 study: full-length deck, charge card removed"
    This reverts commit a2e4ad8b01494d68d24823a7fc03688e7d5a8fb4.
    [print_bus_deck_0.stl, print_bus_deck_1.stl, print_bus_deck_ext_0.stl, print_bus_deck_ext_1.stl, print_bus_deck_ext_spline_0.stl, print_bus_deck_ext_spline_1.stl, print_bus_deck_front_0.stl, print_bus_deck_front_1.stl]
2026-10-06 Card cage v9: MPPT at the top, 618 mm deep (24.3 in)
    The MPPT (70 deep) moves to the top of the charge card; the Orion and a
    turned Cerbo fill the middle band and the bottom band of the card is left
    empty. Every panel-mounted connector now sits in that bottom band (12 V /
    USB socket row at socket_z 90, and the newly modelled L14-30 shore inlet,
    L14-30 inverter outlet and two SB50 panel inlets, FRONT_INLETS) with 90 mm
    of depth behind the panel, so the front grace drops from 45 to 10 mm, the
    charge gap from 8 to 4 and the inverter gap from 26 to 22: 661 -> 618 deep.
    The Garmin PowerSwitch moves to the inverter card's rear face (layout
    face="rear") facing the 70 mm wiring gap, with its own SB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
    [print_card_charge_tile_00.stl, print_card_charge_tile_01.stl, print_card_inverter_tile_00.stl, print_cube_100.stl, print_cube_101.stl, print_cube_110.stl, print_cube_111.stl, print_post_charge_0_0.stl]
2026-10-06 Card cage v9: deck connector row removed, Garmin on the deck, 568 mm deep (22.4 in)
    The deck no longer carries fixed Anderson halves: every pigtail is lugged
    to a bus bar or breaker on the deck and plugs into the card's own receptacle
    at its far end (SB175 on the inverter card; five SB50s on the charge card,
    whose pigtails run forward in the 18 mm chase between the outboard rail and
    the guide posts). The 40 mm deck extension goes, the Garmin PowerSwitch
    lies on the deck where the SB50 row was with a PP45 output block at the
    deck's front edge, and the inverter card closes up to 20 mm from the deck
    (its SB175 housing + 4). 618 -> 568 deep. Clash check clean.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
    [print_bus_deck_ext_0.stl, print_bus_deck_ext_1.stl, print_bus_deck_ext_spline_0.stl, print_bus_deck_ext_spline_1.stl, print_card_charge_tile_00.stl, print_card_charge_tile_01.stl, print_card_inverter_tile_00.stl, print_card_inverter_tile_01.stl]
2026-10-06 Card cage v10: two batteries in one stack, charge card in the column, 454 mm deep
    cage.py v10 (deck="column"): one SuperPack stack with the v9 rack and a
    245 x 151 deck (bus bars along the depth, breakers, hand window); the charge
    card turns lengthwise along the inboard wall in the freed column (250 x 444,
    units facing the stack, five SB50s + PP45 on its rear face mating upward;
    16 x 24 posts standing 12 mm off the inboard rail with feet on the bottom
    and top inboard depth rails, three half-lapped segments pinned by M4s); the
    inverter card 10 mm in front of the bay; the whole port band above the
    MultiPlus. 454 x 353 x 559 (17.9 in deep). Report states the tradeoff:
    120 Ah, 60 A continuous,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
    [print_bus_deck_0.stl, print_card_charge_tile_00.stl, print_card_charge_tile_01.stl, print_card_inverter_tile_00.stl, print_card_inverter_tile_01.stl, print_colpost_back_0.stl, print_colpost_back_1.stl, print_colpost_back_2.stl]
2026-10-06 Card cage v10: add-on battery pack from the IceBox offcuts
    build_pack(): the two displaced SuperPacks side by side in their own
    329 x 353 x 359 cage, rendered 80 mm in front of the v10 box. Same trays,
    tabs, one-piece 231 mm legs and deck halves as the main rack; bus bars
    along the depth between the hand windows and a breaker per battery on the
    deck; SB175 panel inlet on its back panel facing the main box. The main
    box gets a matching SB175 inlet beside its socket row (sockets shifted
    left; inlet bodies generalized). Height rails = the four 308 mm offcuts
    of the IceBox depth rails, uncut; width and depth rails from 8 kit bars.
    Pack dims in the overlay; cut list in the report. Clash check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
    [print_pack_cube_000.stl, print_pack_cube_001.stl, print_pack_cube_010.stl, print_pack_cube_011.stl, print_pack_cube_100.stl, print_pack_cube_101.stl, print_pack_cube_110.stl, print_pack_cube_111.stl]
2026-10-06 Card cage v10: all-printed add-on pack, Blue Sea 187 breakers
    The pack cage is now printed (P pack="printed", --pack=bars keeps the bar
    frame): four 30 x 30 x 306 ASA corner posts in two half-lapped segments
    with foot tabs into the tray corner pads and lid inserts on top, deck
    corners on post ledges, 6 mm panel tiles (2 x 2 per side, card-style
    joints) screwed outside the posts, a four-tile lid with handle. 325 x 314
    x 312. The two batteries are paralleled battery-to-battery with ONE Blue
    Sea 187-series 150 A breaker in the + lead to the SB175 and no bus bars;
    the inlet drops to z 240 and the lid to 312. Blue Sea 187 dimensions
    (67 x 43 x 66, long axis along the depth) replace the generic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
    [print_pack_cube_000.stl, print_pack_cube_001.stl, print_pack_cube_010.stl, print_pack_cube_011.stl, print_pack_cube_100.stl, print_pack_cube_101.stl, print_pack_cube_110.stl, print_pack_cube_111.stl]
2026-10-06 v10 renders: two-battery box with the printed add-on pack
2026-10-06 Treat the printed pack's panel and lid tiles as panels in the renders and the viewer legend
2026-10-06 v10 renders: printed add-on pack shown open beside the box
2026-10-06 Blue Sea 7148 breaker at its real size, STEP hook, decks re-laid
    The 187-series surface-mount 150 A breaker is Blue Sea part 7148 (not
    7187, which is the 285-series 100 A); 3.439 x 2.323 x 1.797 in = 87.4 x
    59 x 45.6 mm. COMPONENTS updated, a dimensioned stand-in with two 5/16
    studs and the trip button draws until cad/step/BlueSea-7148.step exists
    (STEP_FILES wired; Blue Sea's site blocks scripted downloads, so the file
    is fetched by hand). Decks re-laid for the real footprint: 100 x 55 hand
    windows at the back, bus bars along the depth between them, breakers along
    the depth at the deck edges; v9 gets the SmartShunt across and the Garmin
    on edge; v10 and the pack keep one breaker between t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
    [print_bus_deck_0.stl, print_bus_deck_1.stl, print_pack_deck_0.stl, print_pack_deck_1.stl]
2026-10-06 Card cage v10: ports moved to the inboard side beside the inverter
    Ports above the MultiPlus blocked the inverter card's lift. Every external
    port (5 sockets, 2 x L14-30, 2 x SB50 inlets, the pack SB175) now sits on
    the inboard side panel in the column zone, beside the inverter's vertical
    face (SIDE_PORTS); the front panel is plain. The column card's posts stand
    55 mm off the inboard rail so 64 mm behind the card takes the port bodies;
    the inverter card's SB175 moves to y 130 to clear the column card's front
    post. Clash checks clean for v9 and v10.
    [print_card_charge_tile_00.stl, print_card_charge_tile_01.stl, print_colpost_back_0.stl, print_colpost_back_1.stl, print_colpost_back_2.stl, print_colpost_front_0.stl, print_colpost_front_1.stl, print_colpost_front_2.stl]
2026-10-06 Inverter SB175 position per variant: 150 in v9 (clears the rack legs), 132 in v10 (clears the column post)
2026-10-06 Card cage v10: ports in one vertical line beside the inverter, outboard
    The inverter card rides on asymmetric posts (36 mm off the outboard rail,
    0 off the inboard) so a 44 mm strip opens on the front panel between the
    outboard corner bar and the MultiPlus's side. Every external port stacks
    there (FRONT_PORTS): pack SB175 on end, 3 x 12 V, 2 x USB, SB50 solar and
    alternator inlets, IEC C20 AC in and C19 AC out (L14-30 flanges don't fit
    the strip; the 12/1200 is a 16 A unit). Port bodies sit beside the
    inverter, out of its lift path. Column card back to 12 mm off the inboard
    rail; inverter SB175 back to y 150. Clash check clean.
    [print_card_charge_tile_00.stl, print_card_charge_tile_01.stl, print_card_inverter_tile_00.stl, print_card_inverter_tile_01.stl, print_colpost_back_0.stl, print_colpost_back_1.stl, print_colpost_back_2.stl, print_colpost_front_0.stl]
2026-10-06 Card cage v10: ports on the pedal-side wall beside the inverter, 365 wide; pedal-room dimension
    Every v10 port moves to the y=0 side wall (the side set in from the IceBox
    face) in the inverter zone, bodies pointing at the MultiPlus's side: 2 x
    L14-30 (restored), 2 x SB50 inlets, 3 x 12 V, 2 x USB and the SB175 pack
    inlet, between the card's post and the front corner bar. The inverter
    card rides on 48 / 0 posts and the frame gets extra_width=12 (365) so the
    82 mm gap takes the SB175's 79. The dimension overlay now shows the
    pedal room from the IceBox face (123 mm / 4.8 in at 365; 134 / 5.3 in for
    v9 at 353). Clash checks clean.
    [print_card_charge_tile_00.stl, print_card_charge_tile_01.stl, print_card_inverter_tile_00.stl, print_card_inverter_tile_01.stl, print_colpost_back_0.stl, print_colpost_back_1.stl, print_colpost_back_2.stl, print_colpost_front_0.stl]
2026-10-06 Card cage v11: v10 swapped, MultiPlus in the column, 431 mm deep
    cage.py v11 (deck="column", swap=True): the MultiPlus stands lengthwise on
    the column card beside the stack (249 along the card, 10 mm feet, SB175 on
    the rear face; column posts 21 off the inboard rail for 30 mm behind) -
    147 of the 163 mm column; the charge gear (MPPT, Orion, Cerbo, Garmin,
    SmartShunt) is the front card with five SB50s on its rear face and the
    Garmin's PP45 on the front. Front zone = MPPT 70 instead of MultiPlus
    101: 431 x 365 x 559. Ports in a single column on the pedal-side wall
    beside the front card. build_column_card takes layout/conn/feet. Clash
    check clean.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
    [print_bus_deck_0.stl, print_card_charge_tile_00.stl, print_card_charge_tile_01.stl, print_card_inverter_tile_00.stl, print_card_inverter_tile_01.stl, print_colpost_back_0.stl, print_colpost_back_1.stl, print_colpost_back_2.stl]
2026-10-06 Card cage v11: one port column at the IceBox end, inverter SB175 removed, inverter 35 mm off the batteries
    Round ports and the rectangular faces share one vertical line on the
    pedal-side wall, centred 32 mm from the front card's post (as far toward
    the IceBox as the L14-30 flange allows), so the holes are spread and the
    panel stays stiff. The inverter's SB175 is removed pending a decision on
    where it goes; with nothing behind the column card its posts stand 2 mm
    off the rail and the MultiPlus moves to 35 mm from the tray wall.
    [print_card_inverter_tile_00.stl, print_card_inverter_tile_01.stl, print_colpost_back_0.stl, print_colpost_back_1.stl, print_colpost_back_2.stl, print_colpost_front_0.stl, print_colpost_front_1.stl, print_colpost_front_2.stl]
2026-10-06 Card cage v11: inverter SB175 lateral above the MultiPlus, column card raised to 480
    The SB175 (sb175_h, 79 x 26 x 56) lies on the column card's unit face
    above the inverter's top, mating forward along the box; the pigtail's
    flying half pulls forward 25 mm to unplug before the card lifts. The
    column card is full height again (480: two 252 mm tiles; 494 would put
    them 3 mm over the bed). Standing it mating-face-up would need 193 mm
    above the inverter; there are 99. Clash check clean.
    [print_card_inverter_tile_00.stl, print_card_inverter_tile_01.stl]
2026-10-06 Card cage v11: built to the 17.25 in limit (437.8), the 7 mm spent on wiring room
    [print_card_charge_tile_00.stl, print_card_charge_tile_01.stl, print_card_inverter_tile_00.stl, print_card_inverter_tile_01.stl, print_colpost_front_0.stl, print_colpost_front_1.stl, print_colpost_front_2.stl, print_cube_100.stl]
2026-10-06 Card cage v11: MultiPlus flush on a 264 mm column card, bracket modelled, SB175 above it
    The inverter is bolted flush to the column card (no feet) at its keyholes;
    the card grows to 264 (2 x 2 tiles) so the body sits between the posts'
    slot lips, which are cut 7 mm deep on this card; the 31 mm wall bracket is
    drawn above the body and the lateral SB175 moves up above it (z 414-470
    on the 480 card). The 7 mm of depth to the 17.25 in limit now goes 6
    behind the front card's SB50 row (which also gives the column card its
    length) and 1 in front of the MPPT. Clash check clean.
    [print_card_charge_tile_00.stl, print_card_charge_tile_01.stl, print_card_inverter_spline_v1_153.stl, print_card_inverter_spline_v1_273.stl, print_card_inverter_spline_v1_393.stl, print_card_inverter_tile_00.stl, print_card_inverter_tile_01.stl, print_card_inverter_tile_10.stl]
2026-10-06 v11 renders: swapped cards, flush MultiPlus, single port column, printed pack
2026-10-06 Card cage v11: deck extended over the inverter column, notch along the card, breaker on the extension
    A second deck plate (118 x 245) runs from the stack half's edge to 32 mm
    short of the inverter card, splined to the stack half and screwed to
    ledges on the column card's posts. The 32 mm notch along its length is
    for the SB175 lying above the inverter and the MultiPlus leads. The Blue
    Sea breaker moves onto it, uncrowding the stack half. The inverter card
    now lifts only after that plate is unbolted (user's call). Front card's
    SB50 row re-pitched to 38 to clear the front ledge. Clash check clean.
    [print_bus_deck_ext_column.stl, print_bus_deck_spline_122.stl, print_bus_deck_spline_183.stl, print_bus_deck_spline_61.stl, print_colpost_ledge_1.stl, print_colpost_ledge_268.stl]
2026-10-06 v11 deck extension: ledges reach under the plate, screw holes 9 mm inside its edge and through the plate
    [print_colpost_ledge_1.stl, print_colpost_ledge_268.stl]
2026-10-06 v11 deck extension: post to post in two splined plates, ledge holes inside the plates
    [print_bus_deck_ext_column.stl, print_bus_deck_ext_column_0.stl, print_bus_deck_ext_column_1.stl, print_bus_deck_ext_column_spline.stl, print_colpost_ledge_258.stl, print_colpost_ledge_268.stl]
2026-10-06 Card cage v11: no deck windows, 30 mm lug room, three-segment legs
    The hand windows would pin the battery leads under the deck, so v11
    drops them; the leads run under the deck to its back edge and up in the
    end gap. The 14 mm between battery top and deck was not enough for a
    4 AWG lug on an M6 stud (lug + bolt head ~19, cable 9), so v11 sets
    term_clear=30: deck at 500 (53 under the lid, breaker clears), shelf
    screw at 256 (SHELF_SCREW_Z now follows term_clear), rack legs 500 tall
    in three half-lapped segments (200 / 220 / 120) with M4 pins through the
    laps. The pack's SB175 inlet follows its deck. Clash check clean.
    [print_bus_deck_0.stl, print_bus_deck_ext_column_0.stl, print_bus_deck_ext_column_1.stl, print_bus_deck_ext_column_spline.stl, print_bus_deck_spline_122.stl, print_bus_deck_spline_183.stl, print_bus_deck_spline_61.stl, print_colpost_ledge_1.stl]
2026-10-06 v11 renders: deck extension on the ledges, no windows, 30 mm lug room
2026-10-06 Card cage v11: stack deck plate runs forward to the extension's line
    The stack half of the deck now ends on the same line as the column
    extension (5 mm short of the front card's SB50 row, over the front legs)
    instead of stepping back 15 mm. To stay under 256 mm it starts 8 mm
    later, on back-leg boss tabs lengthened from 16 to 24 mm (hole at tx+14);
    the back deck tie's pad grows to 66 with its holes at 52 / 60. The lead
    exit behind the deck widens to 21 mm as a side effect. Clash check clean.
    [print_bus_deck_0.stl, print_bus_deck_spline_122.stl, print_bus_deck_spline_126.stl, print_bus_deck_spline_183.stl, print_bus_deck_spline_190.stl, print_bus_deck_spline_61.stl, print_bus_deck_spline_63.stl, print_deck_tie_0.stl]
2026-10-06 Card cage v11: column floor plates tie the tray's inboard wall to the inverter card's posts
    The tray's inboard corners had nothing to hold them (no rail on that
    side). Two 4 mm plates now run under the column from the tray to the
    column posts, lap-joined at the middle: a 34 mm lip bolts through the
    tray's inboard wall (3 x M4, heads inside) and a 28 mm lip at each end
    bolts into the post's solid sill (2 x M4 inserts added there). The tray
    is tied to the frame on all four sides. Clash check clean.
    [print_colpost_back_0.stl, print_colpost_front_0.stl, print_column_floor_0.stl, print_column_floor_1.stl, print_tray_battery_0.stl]
2026-10-06 Card cage v11: column brackets replace the lap-joined floor plates
    The two 4 mm floor plates with a 2 mm lap were flimsy. Each of the
    tray's inboard corners now gets a jointless printed channel bracket:
    70 x 137 x 6 plate on the floor, 34 mm lip bolted through the tray's
    inboard wall (2 x M4, heads inside), 28 mm lip bolted into the column
    post's sill (2 x M4 inserts), 12 mm rib along the inner edge. The floor
    between them stays open for the MultiPlus leads. Clash check clean.
    [print_column_bracket_back.stl, print_column_bracket_front.stl, print_column_floor_0.stl, print_column_floor_1.stl, print_tray_battery_0.stl]
2026-10-06 Card cage v11: deck runs unbroken to the inboard rail; inverter card and SB175 under it
    The column extension now reaches the inboard rail as one flat surface,
    with cutouts only where the two column posts pass through (161 mm wide,
    two splined plates). The inverter card is cut to 464 and its lateral
    SB175 sits directly on the MultiPlus bracket, so both end 2.6 mm under
    the deck; the MultiPlus leads run under the deck along the floor. To
    unplug the SB175 and lift the inverter card the two plates come off
    first. Clash check clean.
    [print_bus_deck_ext_column_0.stl, print_bus_deck_ext_column_1.stl, print_bus_deck_ext_column_spline.stl, print_card_inverter_spline_v1_149.stl, print_card_inverter_spline_v1_153.stl, print_card_inverter_spline_v1_265.stl, print_card_inverter_spline_v1_273.stl, print_card_inverter_spline_v1_381.stl]
2026-10-06 Revert "Card cage v11: deck runs unbroken to the inboard rail; inverter card and SB175 under it"
    This reverts commit 80cf77bf194a8379379bb4fb7037fb1d1c300da1.
    [print_bus_deck_ext_column_0.stl, print_bus_deck_ext_column_1.stl, print_bus_deck_ext_column_spline.stl, print_card_inverter_spline_v1_149.stl, print_card_inverter_spline_v1_153.stl, print_card_inverter_spline_v1_265.stl, print_card_inverter_spline_v1_273.stl, print_card_inverter_spline_v1_381.stl]
2026-10-06 Card cage v11: continuous full-width column floor, two butted halves
    The column floor is a continuous 6 mm plate from the tray's inboard wall
    to the inverter card's posts, the full width of the column, in two halves
    that butt at the middle with no lap: each half is bolted at both ends
    (34 mm lip, 3 x M4 through the tray wall; 28 mm lip, 2 x M4 into the
    post's sill). Replaces the two short channel brackets. Deck unchanged
    (the previous deck edit was reverted). Clash check clean.
    [print_column_bracket_back.stl, print_column_bracket_front.stl, print_column_floor_back.stl, print_column_floor_front.stl, print_tray_battery_0.stl]
2026-10-06 Card cage v11: stack deck half post to post on the extension's lines, two splined plates
    The stack half of the deck now starts on the same back line as the column
    extension (x_in0 + 2), sitting on the whole of the back legs' boss tabs
    instead of leaving 17 mm of them exposed, and runs to the same front
    line; at 271 mm it prints as two plates splined at the middle, so the
    deck is four plates on common lines. Boss-tab reach and the deck tie
    revert to the standard 16 / 58; deck layout shifted 18 to match. Clash
    check clean.
    [print_bus_deck_0.stl, print_bus_deck_0_front.stl, print_bus_deck_0_spline_30.stl, print_bus_deck_0_spline_90.stl, print_bus_deck_spline_126.stl, print_bus_deck_spline_135.stl, print_bus_deck_spline_190.stl, print_bus_deck_spline_203.stl]
2026-10-06 v11 renders: four-plate deck, continuous column floor
2026-10-08 Card cage v11: 386 wide (4 in pedal room), SB175 behind the card, deck really connected to the posts
    Width 385.8 (extra_width 33): the column grows to 184, the inverter's
    SB175 goes back onto the column card's rear face mating upward (30 mm
    behind the card, card 444, no deck notch), and the extension runs to the
    card face with cutouts where the posts pass through. The deck-to-post
    connection is now real: each column post's top segment carries an
    integral gusseted ledge with an M4 insert from above, and two cleats under
    the stack/extension joint carry inserts on both sides of the line, so
    each extension plate is held by four screws and the splines only locate.
    Clash check clean.
    Co-Authored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
    [print_bus_deck_0.stl, print_bus_deck_0_front.stl, print_bus_deck_ext_column_0.stl, print_bus_deck_ext_column_1.stl, print_bus_deck_ext_column_spline.stl, print_card_inverter_spline_v1_144.stl, print_card_inverter_spline_v1_153.stl, print_card_inverter_spline_v1_255.stl]
2026-10-08 Card cage v11: ports on the front face in a 78 mm strip beside the front card
    The front card sits against the inboard rail (posts 69 / 0), which opens
    a 78 mm strip on the front panel between the pedal-side corner bar and
    the card. All ports stand there in one vertical column (SB175 pack inlet
    on end, sockets two per row, SB50 inlets, L14-30 in/out); bodies sit
    beside the card, 80 mm clear of its post, nothing in front of the MPPT,
    and the box works mirrored for the IceBox on the other side. The column's
    front-post ledge is 12 mm (hole at half length) to clear the front card's
    SB50 pigtails. Clash check clean.
    [print_bus_deck_ext_column_0.stl, print_card_charge_tile_00.stl, print_card_charge_tile_01.stl, print_colpost_back_2.stl, print_colpost_front_2.stl, print_post_charge_0_0.stl, print_post_charge_0_1.stl, print_post_charge_0_2.stl]
2026-10-08 Card cage v11: front column-post ledge hole brought under the deck plate; every deck hole asserted inside its plate
    The front post's integral ledge had its M4 hole 8 mm ahead of the post's
    back face while the extension plate ends 5 mm ahead of it, so the hole
    was 3 mm outside the plate. The ledge (and its gusset) now overhang the
    post 12 mm rearward with the hole at the overhang's centre, 9 mm inside
    the plate. The build now asserts that every deck screw hole (leg tabs,
    post ledges) lies at least 4 mm inside its plate, and the report lists
    the deck's fasteners. Clash check clean.
    [print_bus_deck_ext_column_1.stl, print_colpost_front_2.stl]
2026-10-08 Fastener rule: no loose nuts inside the box; deck ties and column floor lip use inserts
2026-10-08 v11 renders: 386 wide, front-face ports, deck on the post ledges
2026-10-12 Card cage v12: half-height IceBox footprint, not card based
    cage.py v12: v5's second-IceBox frame (487 x 762) at half the IceBox
    height (279.4), height rails cut to 229. Nothing lifts out: four
    SuperPacks in one 2 x 2 layer in the v9 trays (outboard tabs, back
    brackets, rows and columns bolted to each other); a three-plate printed
    bus shelf in the 135 mm column (breakers, shunt, Cerbo on end, bus bars)
    lipped to the trays and flanged onto the inboard rail; the MultiPlus on
    its long side (375 x 101 x 249) on a fixed two-tile plate in single-piece
    rail-footed posts; the Orion and a two-column port strip inside the front
    panel; the MPPT upright and the Garmin inside the inboard side panel on
    p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
    [print_bus_shelf_0.stl, print_bus_shelf_1.stl, print_bus_shelf_2.stl, print_cube_000.stl, print_cube_001.stl, print_cube_010.stl, print_cube_011.stl, print_cube_100.stl]
2026-10-12 Card cage v12: panels in the rail slots, every tie horizontal into the rails' inner slots
    The IceBox's panels are captured in the rails' centreline slots, so the
    rails' top and bottom slots are taken and L tabs lying on a rail cannot
    work. v12 now puts its panels in the slots (inside the bar envelope, 3 mm
    tongues into each slot, clear of the corner cubes) and ties everything
    through the rails' inner slots with horizontal 1/4-20 T-nut bolts:
    countersunk through the outboard trays' outer walls and the bus shelf's
    outer wall (heads flush inside), through the posts' solid sills, and
    through printed top clips on the posts into the top rails. Tray side
    flanges and back brackets removed. Clash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
    [print_bus_shelf_0.stl, print_bus_shelf_1.stl, print_bus_shelf_2.stl, print_mount_garmin.stl, print_mount_mppt.stl, print_mount_orion.stl, print_plate_inverter_tile_00.stl, print_plate_inverter_tile_10.stl]
2026-10-13 v12: 10 in tall, Cerbo flat on a pedestal, Orion on its lugs
    - Height 279 -> 254 mm (10.0 in): the top rails only run along the box
    edges, so the MultiPlus (249 + 2 mm plate) and the batteries sit under
    the lid, not under a rail. Height rails now cut to 203. Ports re-stacked
    in three columns and the MPPT mount shortened so both stay under the rail.
    - Cerbo GX lies flat on the bus shelf (new cerbo_flat component, lugs down)
    on a printed pedestal: four M4-insert bosses + U wall, 36 mm tall so its
    plug edges clear the shelf lips. Was standing on end.
    - Orion XS flipped 180 so its mounting lugs face the front-panel mount
    (victron_shape gets a caller-side flip); the fins now face into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
    [print_cerbo_pedestal.stl, print_cube_001.stl, print_cube_011.stl, print_cube_101.stl, print_cube_111.stl, print_mount_garmin.stl, print_mount_mppt.stl, print_plate_inverter_spline_v1_112.stl]
2026-10-13 v12: plate to the MultiPlus tabs, Garmin to the front, Cerbo + Orion on the wall
    - Inverter plate 250 mm tall (was 225) so the MultiPlus's upper tabs bolt
    to it; it stands 21 mm above the posts in the rail-free middle with its
    top corners notched around the post clips.
    - Garmin PowerSwitch on the front panel beside the external ports it feeds.
    - Inboard wall now carries the Cerbo (edges horizontal), the Orion and the
    MPPT; the Cerbo pedestal leaves the bus shelf. victron_shape gains a
    `lugs` option that measures which end slab spans the full outline and
    turns the unit so the lug face meets the mount.
    - Clash check clean (69 parts).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
    [print_cerbo_pedestal.stl, print_mount_cerbo.stl, print_mount_garmin.stl, print_mount_mppt.stl, print_mount_orion.stl, print_plate_inverter_spline_v1_112.stl, print_plate_inverter_spline_v1_125.stl, print_plate_inverter_spline_v1_168.stl]
2026-10-13 README: v12 is the primary candidate; v12 printing notes; refreshed renders
2026-10-13 v13: MultiPlus-II 3 kVA + two Lithium Smart 200Ah at 11.1 in
    - New variant for a 1500 W AC load with height the only dimension allowed
    to grow (10 -> 11 in): 762 x 487 x 282. The MultiPlus-II 12/3000/120-50
    (578 x 277 x 148, Victron datasheet) fits no other way, so it lies on its
    long side along the inboard side, back on a printed plate that runs the
    depth in two v12 posts turned 90 deg against the width rails. Two Smart
    200Ah end to end outboard (the 60Ah bank's 120 A cannot feed 1500 W).
    - Trays split on a 20 mm half-lap (345 > bed), 6 mm floors, 1.5 mm pocket
    clearance; bus column between trays and plate with the shelf's thin wall
    as the plate's sill; MPPT, Cerbo, Orion, shu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
    [print_bus_shelf_0.stl, print_bus_shelf_1.stl, print_bus_shelf_2.stl, print_cube_000.stl, print_cube_001.stl, print_cube_010.stl, print_cube_011.stl, print_cube_100.stl]
2026-10-13 v13: floor tied in, tray rail brackets, cable window in the plate
    - The Garmin's loose floor pad is gone: the bus shelf now runs to the front
    width rail and bolts into its inner slot, and the Garmin hangs on the
    inverter plate's column face with the other charge gear.
    - L brackets from each tray's outer pads bolt into the back and front
    width rails' inner slots (M4 down into the pad insert, countersunk 1/4-20
    into the rail), so every tray is tied to three rails plus the shelf lip.
    - 72 x 85 cable window in the plate's front tile above the Garmin for the
    MultiPlus DC leads, Garmin outputs and inlet pigtails.
    - v13 render captions. Clash check clean (76 parts).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
    [print_bus_shelf_0.stl, print_bus_shelf_1.stl, print_bus_shelf_2.stl, print_mount_garmin.stl, print_plate_inverter_tile_21.stl, print_tray_rail_bracket_00.stl, print_tray_rail_bracket_01.stl, print_tray_rail_bracket_10.stl]
2026-10-13 v13: renders with the floor ties, brackets and cable window
2026-10-14 v12 in v13's form factor: one box, upgradeable inverter and batteries
    - v12 is now 762 x 487 x 282 (height rails cut to 231) with v13's front
    panel: the port strip on the inboard 150 mm for both variants, the
    Garmin on the outboard side of v12's panel.
    - Posts capped at 254 with 28 mm clips in both variants (same parts).
    - Upgrade path documented: frame, panels, lid, posts, clips and port
    strip carry over; reprint the trays, bus shelf and inverter plate, swap
    the MultiPlus and batteries, re-size the DC side.
    - Both variants clash-clean (69 / 76 parts).
    [print_cube_001.stl, print_cube_011.stl, print_cube_101.stl, print_cube_111.stl, print_mount_garmin.stl, print_plate_inverter_tile_00.stl, print_plate_inverter_tile_10.stl, print_post_clip_0.stl]
2026-10-14 v12 uses v13's interior: two SuperPack 60Ah + 12/1200 on the long plate
    - build_v13 takes the battery (P["batt"]) and inverter (P["inverter_long"])
    from the variant. v12 = two SuperPack 60Ah, one tray at each end of the
    outboard zone (167 wide like v13's, hollow channel beside the pocket,
    single-piece prints), MultiPlus 12/1200 on 22 mm shims so its keyholes
    land on the plate. Everything else is v13's part for part.
    - The earlier 2 x 2 interior stays as variant v12_4batt.
    - Phase-1 limit noted: 2 x 60Ah = 60 A continuous, ~700 W AC.
    - Both variants clash-clean (74 / 76 parts). README, viewer, renders.
    [print_bus_shelf_0.stl, print_bus_shelf_1.stl, print_bus_shelf_2.stl, print_inverter_shim_0.stl, print_inverter_shim_1.stl, print_mount_cerbo.stl, print_mount_garmin.stl, print_mount_mppt.stl]
2026-10-14 v12: MultiPlus 12/1200 mounting tabs onto the plate
    The lug-face probe used a 3 mm end slab, which missed the 12/1200's keyhole
    tabs (4 mm inside its fan guard) and turned the unit fins-to-plate. Probe
    widened to 6 mm; v13's units are unchanged. Both variants clash-clean.
2026-10-14 v12: MultiPlus-II with the two SuperPack 60Ah (inverter ordered 2026-10-14)
    The 12/1200 build stays as variant v12_1200. Report, README and viewer
    carry the 60 A bank limit, the 60 A charger setting and the advice to
    build the DC side for v13 now. Upgrade to v13 = trays and batteries only.
    [print_inverter_shim_0.stl, print_inverter_shim_1.stl, print_plate_inverter_tile_00.stl, print_plate_inverter_tile_01.stl, print_plate_inverter_tile_10.stl, print_plate_inverter_tile_11.stl, print_plate_inverter_tile_20.stl]
2026-10-14 v12: renders with the MultiPlus-II; charger limit after the upgrade is 120 A, the II's maximum
2026-10-17 v12s: the 12/1200 + two 60Ah box cut to 620 mm deep (24.4 in)
    Same interior as v12 with the charge gear stacked on the plate (Garmin over
    the Orion, cable window over the shunt) and the shelf's third plate
    shorter. No upgrade path: the MultiPlus-II and the 200Ah pair need 762.
    v13 shown to be depth-bound at 762. Clash-clean (74 parts).
    [print_bus_shelf_0.stl, print_bus_shelf_1.stl, print_bus_shelf_2.stl, print_cube_000.stl, print_cube_001.stl, print_cube_010.stl, print_cube_011.stl, print_cube_100.stl]
2026-10-17 Shims out, tray-to-shelf joint reworked, v12s drawn stacked on the IceBox
    - The inverter hangs on the plate by its keyholes or hook; the two floor
    shims under it did nothing and are gone (v12, v13, v12s, v12_1200).
    - Tray-to-shelf joint: the bolt heads used to sit inside the 60Ah tray's
    hollow channel where no tool reaches. The 60Ah tray's inboard wall is
    now a solid 21 mm block with three M4 inserts in its outer face; the
    shelf's lip has through-holes and bolts to it from the column side,
    heads reachable from above, at x positions clear of the breakers.
    Same scheme on the 200Ah trays.
    - stack_on_icebox: v12s is drawn on the IceBox's deck with the port face
    flush with the IceBo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
    [print_bus_shelf_0.stl, print_bus_shelf_1.stl, print_bus_shelf_2.stl, print_cube_000.stl, print_cube_001.stl, print_cube_010.stl, print_cube_011.stl, print_cube_100.stl]
2026-10-17 Assembly order: sub-assemblies, access fixes (clips, shelf laps, drop-in T-nuts)
    - README: bench sub-assemblies (frame, trays, bus shelf, inverter plate)
    and the in-box order posts -> brackets -> trays -> shelf -> plate ->
    inverter -> batteries, with the tool access for every fastener.
    - Post clips 40 wide with the rail bolt 10 mm off the plate line, so a
    key reaches it past the plate's top edge (was on the plate line).
    - The three shelf plates join on 20 mm floor half-laps with two M4
    each: one bus-shelf sub-assembly that drops in wired.
    - Tray brackets go on the rails before the trays; trays slide under.
    - Drop-in 1/4-20 T-nuts so the inner-slot ties can be added after the
    frame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
    [print_bus_shelf_0.stl, print_bus_shelf_1.stl, print_bus_shelf_2.stl, print_post_clip_0.stl, print_post_clip_1.stl]
2026-10-17 Breakers high on the plate face, shunt to the shelf; IceBox cubes and panels; printed front panel
    - The two Blue Sea 7148s mount on the inverter plate's column face near
    the top (48 mm under the lid in v12/v13, stacked at the front in v12s),
    reached from above; the SmartShunt moves down to the shelf beside the
    bus bars so the column holds only the low, lugged parts. The cable
    window drops to bus level. A hanging breaker tray over the batteries
    was declined: 9 mm of headroom over a 200Ah.
    - Corner cubes come with the second IceBox (cube_*, not printed), as do
    the two side panels and the perforated rear panel (cut to 237) and the
    top panel as the lid. Only the front panel is prin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
    [print_cube_000.stl, print_cube_001.stl, print_cube_010.stl, print_cube_011.stl, print_cube_100.stl, print_cube_101.stl, print_cube_110.stl, print_cube_111.stl]
2026-10-17 v12s: perforated back panel, clean trays; viewer sub-assembly legend
    - Back panel carries the IceBox's slot pattern (cut-down perforated rear
    panel), clear of the rail tongues.
    - Trays: only the two pads that take rail brackets; the optional M6
    floor holes (a 2 x 2 layout leftover) are gone. v12/v13 unchanged.
    - Viewer: a second legend toggles sub-assemblies (frame, tray 0, tray 1,
    bus shelf, inverter plate, posts, ports); visibility is the AND of the
    material and sub-assembly toggles.
    [print_tray_battery_0.stl, print_tray_battery_1.stl]
2026-10-17 v12, v13 renders: breakers on the plate face, IceBox cubes and panels, printed front
2026-10-17 v12s: insert pilot holes in the plate under every column-face unit; fastener table
    - Plate tiles carry pilot holes for the MPPT (upright pattern, transposed),
    Cerbo, Orion, Garmin and both 7148 breakers, not just the inverter.
    - Bosses near a tile joint no longer refill the half-lap; v12s unit
    heights moved so no insert lands in the lap band.
    - README: how each unit bolts to the plate (pattern, insert, screw, side).
    - Clash-clean (74 parts).
    [print_plate_inverter_tile_00.stl, print_plate_inverter_tile_01.stl, print_plate_inverter_tile_10.stl, print_plate_inverter_tile_11.stl, print_plate_inverter_tile_20.stl, print_plate_inverter_tile_21.stl]
2026-10-17 v12s renders: plate pilot holes
2026-10-18 v12s: front panel from the slotted offcut with a one-piece printed port bezel
    The IceBox rear panel is 514 tall inside its rails: the box's back panel
    is its bottom 237 (slot rows 0-3), the front its next 237 (rows 4-7).
    Ports cannot land on slots, so the front gets a 139 x 210 opening and a
    printed bezel (153 x 227 x 6, one print, 5 M4 from outside into inserts)
    carries them behind it. The two-tile printed front panel is gone from
    v12s; v12/v13 unchanged. Clash-clean.
    [print_panel_front_inboard_ports.stl, print_panel_front_outboard.stl, print_port_bezel.stl]
2026-10-18 v12s: front panel is a solid IceBox side-panel offcut, ports cut through; bezel dropped
    Each side panel cut to 237 leaves a 762 x 277 solid offcut; the front
    needs 443 x 237. No printed sheet on the box. Clash-clean.
    [print_port_bezel.stl]
2026-10-18 README: cutting and tapping the rails in one shot
2026-10-18 README: tapping tools BOM for the rail cuts
2026-10-18 pack2: stacked 2 x 2 SuperPack add-on pack for v12s; SB175 umbilical inlet on the v12s front
    - All-printed pack 325 x 314 x 572: four 30 mm posts in three lapped
    segments with gusseted ledges at two levels, mid-deck plates carrying
    the upper trays (bolted down from inside), top shelf with the two bus
    bars and one 150 A breaker, panel ribs under both plate levels, SB175
    inlet in the back panel at shelf level, panels in tiles, lid in four.
    - v12s front panel: SB175 inlet in front of the bus column (y 215, z 110).
    - Both clash-clean.
    [print_pack_deck_0.stl, print_pack_deck_1.stl, print_pack_lid_00.stl, print_pack_lid_01.stl, print_pack_lid_10.stl, print_pack_lid_11.stl, print_pack_panel_back_spline_v1_141.stl, print_pack_panel_back_spline_v1_283.stl]
2026-10-18 v12s_pack: v12s on the IceBox with pack2 on the floor in front of it
    [print_bus_shelf_0.stl, print_bus_shelf_1.stl, print_bus_shelf_2.stl, print_pack_deck_0.stl, print_pack_deck_1.stl, print_pack_lid_00.stl, print_pack_lid_01.stl, print_pack_lid_10.stl]
2026-10-18 README restructured around the v12s build
    Top: status, links, the v12s box zone by zone, electrical limits, the
    parts that come from the second IceBox, rail cutting and tapping with
    the tools BOM, how the units bolt to the plate, assembly order, printing
    notes, pack2, working with the model. Everything from v4 to v13 and the
    cube-era notes are collapsed under Reference designs; build log kept.
2026-10-20 v12s on the 25 in donor IceBox: 635 deep, depth rails uncut
    The second IceBox is the 25 in model, so v12s takes its full depth: only
    the four height rails are cut and tapped. Interior positions unchanged;
    v12s and v12s_pack clash-clean. README cut table and viewer updated.
    [print_bus_shelf_0.stl, print_bus_shelf_1.stl, print_bus_shelf_2.stl, print_pack_deck_0.stl, print_pack_deck_1.stl, print_pack_lid_00.stl, print_pack_lid_01.stl, print_pack_lid_10.stl]
2026-10-20 v12s renders at 635 (25 in donor frame)
2026-10-20 v12s: Bussmann 285 breakers on drop shelves over the batteries
    - The owner's breakers are Eaton Bussmann 285060F-121-S (60 A, 81.3 x
    48.1 x 31.5 + 6.4 PTT, holes 56.64 x 26.67 diagonal, M6 studs); the
    model, hole pattern, stand-in shape and components.md now say so.
    - Each breaker sits on a printed drop shelf over the middle of its
    battery: plate hung from the top outboard rail's inner slot (two
    countersunk 1/4-20 into drop-in T-nuts) and standing on the tray's
    21 mm inboard wall (two M4 into its top); breaker top 13 mm under the
    lid, positive lead straight up from the battery. Breakers leave the
    plate's column face.
    - v12s and v12s_pack clash-clean; README zones, fastener tabl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
    [print_breaker_shelf_0.stl, print_breaker_shelf_1.stl, print_plate_inverter_tile_20.stl, print_plate_inverter_tile_21.stl, print_tray_battery_0.stl, print_tray_battery_1.stl]
2026-10-20 Breaker drop shelf made buildable: foot tab, lip, gussets; print-and-build section
    The leg's two M4s had been drawn going down through the leg plate. The
    leg now ends in a 15 mm foot on the tray wall top with the M4s through
    it, carries on 24 mm above the plate as a lip, and has gussets at the
    two top corners (nothing below the plate: the battery is 6 mm under).
    Hanger countersinks on the inner face. Breaker 7 mm off the lip. README:
    how the shelf prints (on its side, no supports), its inserts, hardware
    and build order. v12s and v12s_pack clash-clean.
    [print_breaker_shelf_0.stl, print_breaker_shelf_1.stl, print_tray_battery_0.stl, print_tray_battery_1.stl]
2026-10-20 Build manual: step-by-step assembly with rendered diagrams, print list with STL links
    - MANUAL.md: what comes from the 25 in IceBox and its cuts, the printed
    parts table linking every STL in stl/v12s/ with bed orientation and
    settings, hardware and tool lists, bench work (rails, panels with the
    port hole positions, inserts, bus shelf and plate sub-assemblies),
    eleven assembly steps each with a diagram, wiring table, pack2 pointer.
    - cad/manual.py renders the diagrams from the model: parts placed in a
    step in colour, earlier parts grey, plus one image per printed part.
    - Linked from both READMEs.
2026-10-20 Manual: batteries go in before the breaker drop shelves
    A shelf covers the middle of its battery, so the battery cannot be
    dropped in afterwards. Steps reordered (batteries 6, shelves 7, bus
    shelf 8, plate 9, inverter and lugs 10), diagrams re-rendered, README
    assembly order and drop-shelf build notes corrected.
2026-10-20 Manual: McMaster-Carr order list for the hardware, inserts and tapping tools
2026-10-20 Manual: dimensioned placement drawing, part positions and T-nut positions
    cad/placement.py builds v12s and emits a plan drawing with the rails,
    every part's footprint and the drop-in T-nut positions along each rail,
    plus a JSON of the numbers. MANUAL.md gets a placement section before
    step 1: part positions measured from the back rail's and outboard rail's
    inner faces, and an 18-nut table per rail.
2026-10-20 Fasteners: M5 + washer for the inverter keyholes, breakers and shunt; short M4 inserts for the 6 mm plate
    M6 heat-set inserts are longer than the 6 mm plate and the 7.9 mm M4s
    poke through it, so: inverter keyholes, breakers and shunt take M5
    inserts, M5 x 12 button heads and washers; the plate's own units and
    its bottom band take short M4 inserts (94180A351); the 7.9 mm M4s go in
    the thick parts. Manual, order list and fastener table updated; first
    McMaster order (six verified lines) recorded.
2026-10-20 v12s: no lap bolts; order 2 list with verified washer and flat-head numbers
    The lap-bolt nuts on the bus shelf landed under the shunt and bus bars
    and the plate's under the MPPT, Cerbo and Orion. Dropped: each shelf
    plate bolts to the trays and the inverter plate on its own, and the
    plate's tiles are held by the units screwed across the laps plus the
    glued splines. M4 x 16 and locknuts off the BOM; M5 washer 93475A240
    and 1/4-20 x 3/4 flat-head 92210A540 (verify) added; order 2 block.
2026-10-20 v12s: the breaker drop shelf is the battery hold-down
    Plate lowered onto a 3 mm closed-cell foam pad on the battery's top
    (pad modelled), breaker now 16 mm under the lid; straps optional. Also
    carries the no-lap-bolt STLs from the previous commit. Clash-clean.
    [print_breaker_shelf_0.stl, print_breaker_shelf_1.stl, print_bus_shelf_0.stl, print_bus_shelf_1.stl, print_bus_shelf_2.stl, print_pack_panel_back_tile_00.stl, print_pack_panel_back_tile_01.stl, print_pack_panel_back_tile_02.stl]
2026-10-20 README: drop shelf as the battery hold-down
2026-10-20 Printed rail-end tap guide; Milwaukee tap set usable with chip clearing
    cad/tools.py writes print_tool_tap_guide.stl: a cap over the 1 in rail
    end with a 6.5 mm bore on the rail's centre, so the 1/4-20 tap starts
    square. Manual tool list, README tapping table and order list updated;
    the bought tap, handle and guide block come off the McMaster list.
    [print_tool_tap_guide.stl]
2026-10-20 Order list: McMaster order 2 placed (6000N501 drop-in nuts for 1 in rail)
2026-10-20 Manual/README: show the cube arithmetic behind the 231.2 height-rail cut; fix stale depth-cut log line
2026-10-21 Manual: panel cutting (same D1084L blade, table-saw rip method, port holes)
2026-10-21 Model: IceBox lid recessed in its rail slots (box stands rail on rail); README: self-contained tray load path, PLA caveat
2026-10-21 Renders: v12s with the IceBox lid recessed in its slots
2026-10-21 Export keeps the print_tool_* STLs (tools.py output) instead of wiping them; tap guide restored
2026-10-22 README printing notes: 0.4 mm nozzle, 0.20 mm Standard preset
2026-10-23 Print plate: all four tray rail brackets on their sides on one bed (cad/plates.py); docs say never print them standing
    [plate_tray_rail_brackets.stl]
2026-10-23 Print plate: breaker drop shelf pre-oriented on its side (print twice); docs updated
    [plate_breaker_shelf.stl]
2026-10-23 Print plate: both inverter posts (flat, slot up, at 45 deg) and both clips on one bed; plates.py lays parts on their largest flat face and checks overlaps
    [plate_inverter_posts.stl]
2026-10-23 Bracket plate: front pair printed upside down on their 14 x 40 top leg (on their side the leg was a fin that printed badly)
    [plate_tray_rail_brackets.stl]
2026-10-23 Export every print STL in its print orientation (plates.py rules); front-bracket-only plate; tap guide pocket up; docs: supports only on bus shelf plates 1 and 2
    [plate_breaker_shelf.stl, plate_inverter_posts.stl, plate_tray_rail_brackets.stl, plate_tray_rail_brackets_front.stl, print_breaker_shelf_0.stl, print_breaker_shelf_1.stl, print_bus_shelf_0.stl, print_bus_shelf_1.stl]
2026-10-24 Bus shelf: sacrificial strip across each lap pocket so the ledge bridges 20 mm
    Plate 1's pocket ceiling bridged 105 mm floor-down and strung. The U-channel
    plates cannot print upside down, so a 0.84 mm strip closes the pocket mouth and
    is cut off after printing. Plate 0 unchanged.
    [print_bus_shelf_1.stl, print_bus_shelf_2.stl]
2026-10-24 Bus shelf: half-laps move from the floor into the lip and inboard wall
    The floor half-lap's 3 mm pocket ceiling was a 105 mm bridge open at the
    plate edge and strung; the U-channel plates cannot print upside down. Now the
    floors butt and each wall carries a 20 mm vertical half-lap whose tongue is
    the outer half of the wall standing on the bed: no bridge or overhang on any
    plate, no sacrificial strip. Asserts the trays' lip bolts clear the laps.
    Clash report: 0 pairs. Reprint plates 0 and 1.
    [print_bus_shelf_0.stl, print_bus_shelf_1.stl, print_bus_shelf_2.stl]
2026-10-24 Breaker drop shelf: sit on the battery body, 150 A 285150F holes the right way round
    The SuperPack's 213 mm is to the top of its terminals; the flat body top is at
    208 (Victron STEP, 5 mm studs). The shelf plate drops 5 mm so its 3 mm pad sits
    on the body with no gap (batt_body_h / shelf_pad parameters on v12s). The two
    breaker holes were on the mirrored diagonal and did not fit the printed shelf;
    now lower-left to upper-right per the 285 series drawing, breaker is the
    150 A 285150F-121-S, stand-in studs on the opposite diagonal. Clash: 0 pairs.
    [plate_breaker_shelf.stl, print_breaker_shelf_0.stl, print_breaker_shelf_1.stl]
2026-10-24 v12s_pack: re-export with the breaker shelf and wall-lap bus shelf; viewer blurb 150 A
    [plate_breaker_shelf.stl, plate_inverter_posts.stl, plate_tray_rail_brackets.stl, plate_tray_rail_brackets_front.stl, print_breaker_shelf_0.stl, print_breaker_shelf_1.stl, print_bus_shelf_0.stl, print_bus_shelf_1.stl]
2026-10-24 v12s plate: Garmin on the inverter face above the window; MPPT, Cerbo, Orion in one row
    Garmin PowerSwitch turned 90 deg on the plate's inverter face (x 480-555,
    z 145-270): 59 mm in front of the MultiPlus's cable end, 24 mm behind the
    socket bodies, so only its feed passes through the cable window and its
    outputs run straight to the front-panel ports. MPPT, Cerbo and Orion tops
    aligned at 266 (Orion 255 so its lugs clear the tile lap), opening the band
    over the shelf's bus bars and shunt. Plate units may carry a side flag;
    asserts: every unit has a hole pattern, no insert in the tiles' lap band.
    README bolting table: screw lengths so nothing is proud on the far face.
    Clash: 0 pairs.
    Co-Aut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
    [print_plate_inverter_tile_00.stl, print_plate_inverter_tile_01.stl, print_plate_inverter_tile_10.stl, print_plate_inverter_tile_11.stl, print_plate_inverter_tile_20.stl, print_plate_inverter_tile_21.stl]
2026-10-24 Breaker stand-in modelled as the Bussmann 285 (285150F): flange with holes in corner wells, stud insulators on the opposite diagonal, PTT button, reset lever out of the -y side
    No STEP is published for the 285 series (Eaton's CAD configurator does not
    cover it); the body follows the series drawing. Clash: 0 pairs.
    [print_plate_inverter_tile_00.stl, print_plate_inverter_tile_01.stl, print_plate_inverter_tile_10.stl, print_plate_inverter_tile_11.stl, print_plate_inverter_tile_20.stl, print_plate_inverter_tile_21.stl]
2026-10-24 Inverter plate pilots cut through (1 mm skin was left on the column face)
    The pilot cut started 1 mm inside the plate instead of 1 mm outside it, so
    every pilot was blind from the column side, where the MPPT, Cerbo and Orion
    inserts are set. Verified with a 4 mm pin through all 18 pilots; drop-shelf
    holes verified against the breaker's holes the same way. Clash: 0 pairs.
    [print_plate_inverter_tile_00.stl, print_plate_inverter_tile_01.stl, print_plate_inverter_tile_10.stl, print_plate_inverter_tile_11.stl, print_plate_inverter_tile_20.stl, print_plate_inverter_tile_21.stl]
2026-10-25 Breaker drop shelf: 2 mm lower, M5 insert holes, full-length ribs instead of end gussets
    - shelf_drop=2 on v12s/v12s_pack: the plate sits 1 mm over the battery body (the user still saw 2 mm of daylight after the reprint); the modelled pad is pad - drop.
    - The two breaker holes were 8.0 mm for M6 inserts that were never ordered; now 6.4 mm for the McMaster 94180A361 M5 inserts and M5 x 12 + washer from the order.
    - The 18 mm end gussets are now ribs along the whole 130 mm (18 at the hanger, 5 at the lip, asserted clear of the breaker flange and the hanger countersinks): printed on its edge, the top pair of gussets was 162 mm2 hanging in air and strung. Overhang scan 534 -> 195 mm2, the rest i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
    [plate_breaker_shelf.stl, print_breaker_shelf_0.stl, print_breaker_shelf_1.stl]
2026-10-25 Inverter plate: add the six bottom-band pilots for the bus shelf wall bolts (were never collected); --clash now pin-checks every plate pilot
    Found by an external review of the exported code: the shelf wall had its M4 clearance holes at z 28 and the manual
    said to set six short inserts in the plate's bottom band, but the plate's patch list only held the inverter and unit
    holes. The shelf now records its sill hole positions and the plate takes them as pilots; check_plate_pilots() pushes a
    pin through all 24 and reports any blocked one.
    [print_plate_inverter_tile_00.stl, print_plate_inverter_tile_10.stl, print_plate_inverter_tile_20.stl]
2026-10-25 Inverter plate tiles: each row's lap rabbets and spline pockets on one face (zero unsupported area); 8 splines clear of the laps, on their own plate
    The lower row had its rabbet on the front and its pockets on the back, so printed on either face it carried
    18 mm bridges at the pockets (Gemini review). Now even rows cut the back face, odd rows the front, neighbours still
    keep opposite halves; two splines per row per vertical joint at 30/70 % of the row. plates.py wraps rows on the bed.
    All six tiles scan at 0 mm2 downward area; pilot pin check 24/24; clash clean. Manual images regenerated.
    [plate_inverter_splines.stl, print_plate_inverter_spline_v1_110.stl, print_plate_inverter_spline_v1_187.stl, print_plate_inverter_spline_v1_238.stl, print_plate_inverter_spline_v1_59.stl, print_plate_inverter_spline_v2_110.stl, print_plate_inverter_spline_v2_187.stl, print_plate_inverter_spline_v2_238.stl]
2026-10-25 Trays and bus shelf bolt straight to the width rails (no L brackets); real 82-degree countersinks with a face probe check; manual steps 1-10 regenerated
    - Each tray butts its width rail and takes two countersunk 1/4-20 through its end wall; brackets, pads and 4 inserts gone.
    - Bus shelf runs rail face to rail face: two 1/4-20 through each end wall (plate 2 had stopped 6.6 mm short of the front rail).
    - The 'countersinks' on the tray walls, brackets and shelf wall were 13 mm counterbores placed 0.5 mm off the wall, in air:
    plain holes, flat heads 4 mm proud against the batteries. Now countersink() cones; check_countersinks() probes all 16 under --clash.
    - 20 T-nuts / 20 flat heads / 12 long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
    [plate_breaker_shelf.stl, plate_tray_rail_brackets.stl, plate_tray_rail_brackets_front.stl, print_breaker_shelf_0.stl, print_breaker_shelf_1.stl, print_bus_shelf_0.stl, print_bus_shelf_1.stl, print_bus_shelf_2.stl]
2026-10-25 Viewer: v12s dimension overlay regenerated for the trays on the rails
2026-10-25 v12s trays: snug pocket (0.5 mm per side) and no strap groove or slots; placement, manual images and renders regenerated
    [print_bus_shelf_1.stl, print_bus_shelf_2.stl, print_tray_battery_0.stl, print_tray_battery_1.stl]
2026-10-25 Viewer: v12s + pack view rebuilt (direct rail ties, snug trays), labels updated, cache stamp bumped; v12s_pack STLs regenerated
    [plate_breaker_shelf.stl, plate_inverter_splines.stl, print_breaker_shelf_0.stl, print_breaker_shelf_1.stl, print_bus_shelf_0.stl, print_bus_shelf_1.stl, print_bus_shelf_2.stl, print_pack_panel_back_spline_v1_132.stl]
2026-10-25 Docs: bus shelf plates need no supports (the laps are in the walls since PR #4); size 215
2026-10-25 README: bus shelf plates print without supports
2026-10-30 Docs: the donor IceBox has no bottom front width rail; add one (47065T101 cut to 436.6, tapped) or a mod-kit bar
2026-10-30 Docs: bottom front width rail = Goose Gear mod-kit x.31 bar (ordered 2026-10-30), no cut or tap
2026-10-31 Tap guide: 25.3 mm pocket for the 25 mm metric rail (was 25.6, loose)
    [print_tool_tap_guide.stl]
2026-10-31 v12s as built: 22.5 in deep on the metric frame; Garmin hanger; GX Touch 50 in the back panel; audit
    - Frame set to what was built: 25 mm rails, 25.75 cubes, height rails 230.2, box 571.5 x 488.1 x 281.7; depth rails to be cut to 520.0.
    - Bus shelf: end plates unchanged (as printed), middle plate 132 + tongue (shelf_end_len).
    - Trays notched 2 mm at the corner that meets two rails (cubes stand proud); panel tongues stop at the cubes.
    - Garmin PowerSwitch on a printed hanger plate from the top inboard rail (user's idea): 2 countersunk 1/4-20, 2 short M4 inserts.
    - GX Touch 50 flush display let into the back panel's inboard end with a printed trim bezel; new back-panel render view (opaque pane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
    [plate_breaker_shelf.stl, plate_inverter_posts.stl, print_breaker_shelf_0.stl, print_breaker_shelf_1.stl, print_bus_shelf_0.stl, print_bus_shelf_1.stl, print_bus_shelf_2.stl, print_garmin_hanger.stl]
2026-10-31 Garmin hanger runs to the bottom rail (second plate, cable-tie slots); docs brought current
    - print_garmin_hanger_lower: 130 x 127 x 6 on the bottom inboard rail's inner slot, 2 countersunk 1/4-20, 1 mm under the
    upper plate; cable-tie slots (4 x 10, pairs) on both plates. 24 T-nuts now. Checks: pilots 22/22, countersinks 20/20, clash 0.
    - Docs: bore/tapping notes for the 25-series (M6 vs 1/4-20 cube screws), bench cut list (height rails done, depth rails to 520),
    superseded 3/4 in screws and nut count in the order file, component status, retired v6 render links, with-icebox-top path.
    - Placement (T-nuts on the bottom inboard rail), manual images, renders, viewer (Version 101) regenerate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
    [print_garmin_hanger.stl, print_garmin_hanger_lower.stl]
2026-10-31 Add v13 slot-captured lid variant, replacement corner cube STL, and visual product manual
    [plate_breaker_shelf.stl, plate_inverter_posts.stl, plate_inverter_splines.stl, print_breaker_shelf_0.stl, print_breaker_shelf_1.stl, print_bus_shelf_0.stl, print_bus_shelf_1.stl, print_bus_shelf_2.stl]
2026-10-31 Add 13-page IKEA-style visual assembly manual (IKEA-MANUAL.md)
2026-10-31 Render IKEA manual with exact OpenCascade HLR vector CAD line-art at 200 DPI and Helvetica Neue typography
2026-10-31 feat(battery-box): pre-print all 46 insert bores, add heat-sert guide & GX Touch 50 step, fix Step 4 MPPT layout
    [plate_inverter_posts.stl, print_bus_shelf_0.stl, print_bus_shelf_1.stl, print_bus_shelf_2.stl, print_garmin_hanger.stl, print_plate_inverter_tile_00.stl, print_plate_inverter_tile_01.stl, print_plate_inverter_tile_10.stl]
2026-10-31 Update IKEA manual with visibly rounded corners, cache-busted step images, and out-of-scope wiring note on Step 13
2026-11-01 Bus bar ears at 132 mm centres, Garmin ground bus on the lower hanger plate
    - HOLES busbar_p/n: 11.5/143.5 (132 mm on centre, owner-measured) instead of the 131 mm
    "verify" guess; the end plates printed before the bores existed get a drill guide in
    MANUAL.md Step 7 (plate 0: 31.5/163.5 from the back end, plate 2: 37/169 from the front
    end, 26 mm in from the plate-side wall's outer face).
    - components.md: the bus bars are the owner's 5 x M8 250 A covered stud bars, not the Blue
    Sea 2300 10-gang #8-32 screw bar (which cannot take 4 AWG lugs); lug exit is toward the
    batteries (85 mm) because the plate side has only 24 mm.
    - Blue Sea 2701 DualBus stand-in (power_busbar_gnd_hanger) on t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
    [print_bus_shelf_0.stl, print_bus_shelf_2.stl]
2026-11-01 IceBox stack straps: 4 mm plates tying the box's bottom depth rails to the IceBox's top depth rails
    The box stands rail on rail on the IceBox and both frames are the same MaxLite 25 mm rail with bare outer faces, so the tie is a straight 60 x 46 x 4 strap across the seam on each bottom depth rail's outer face: two 1/4-20 x 1/2 in button heads into drop-in T-nuts in the box rail's outer slot, two into the IceBox rail's directly under it. The upper pair are 2.4 mm vertical slots so the 25.75 mm row pitch absorbs the cube-on-cube seam gap. Four straps, 70 mm in from the corner cubes (past the IceBox's own Goose Gear gussets), --clash clean.
    - cage.py: STRAP dict, stack_strap(), add_stack_strap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
    [plate_stack_straps.stl, print_stack_strap.dxf, print_stack_strap_in_0.stl, print_stack_strap_in_1.stl, print_stack_strap_out_0.stl, print_stack_strap_out_1.stl]
2026-11-01 Bus shelf: bus bars and shunt in one row on the tray side
    The (-) bar sat in the shelf's inboard row directly under the inverter
    plate's cable window, where the MultiPlus, Orion and Garmin leads come
    through and would rest on a bus bar. All three units now sit along the
    tray side on one stud line 23 mm from the shelf's tray edge (bars 1 mm
    off the lip, ears 16 in; shunt 4.5 mm off it, slots 12.5 in), and the
    inboard band under the window is empty.
    Found on the way: the SmartShunt's two mounting slots are on its stud
    line, 12.5 mm from the stud edge of the 46 mm housing (STEP), not
    centred as HOLES["shunt"] assumed, which is why the printed shunt sat
    15.5 mm off the lip. shunt_x gets its own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
    [print_bus_shelf_0.stl, print_bus_shelf_1.stl, print_bus_shelf_2.stl]
2026-11-01 Manuals: PLA heat-set insert temperature for the test prints
    The owner prints every part in PLA first to check fit and finish before
    the PETG run. Add 190-210 C for PLA alongside the PETG and ASA settings
    in the IKEA pages, IKEA-MANUAL.md and MANUAL.md, with the PLA notes:
    1-2 s of pressure is enough, and the inserts can be reclaimed from the
    PLA test parts with the same iron for the PETG parts. The material rule
    now says never PLA for the final build rather than never PLA.
    The IKEA pages were not regenerated in PR #30, so pages 10 and 11 also
    pick up the bus shelf's tray-side layout here.
2026-11-01 M5 heat-set inserts: flush at every site, bores at Ø6.7
    At the bench the Ø6.4 M5 bores printed too tight for the 94180A361
    (an M4 insert dropped in), and the 6.7 mm insert showed proud through
    the 6 mm bus shelf floor. Flush inserts, no standoffs, at all 18 sites:
    - Bores modelled Ø6.7 (M5_BORE_R) so they print at the insert's Ø6.4.
    - Bus shelf floor and breaker drop shelf plates 6 -> 9 mm, thickened
    on top so the units sit flat with 2.3 mm of floor under the insert.
    The M5 x 12 bar screws' tips no longer exit the floor either. The
    breakers and bus units sit 3 mm higher; 14 mm stays under the lid.
    - Inverter plate tiles stay 6 mm (they print on their plain back, so
    a far-side bo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
    [plate_breaker_shelf.stl, print_breaker_shelf_0.stl, print_breaker_shelf_1.stl, print_bus_shelf_0.stl, print_bus_shelf_1.stl, print_bus_shelf_2.stl, print_plate_inverter_tile_00.stl, print_plate_inverter_tile_01.stl]
2026-11-01 IKEA page 2: three side-wall inserts, three leaders
    The tray page drew four side-wall insert squares with two leader
    lines for the "3x A1" callout. Each tray has three: Tray 0 at x 40 /
    100 / 140 (drawn), Tray 1 at x 40 / 120 / 200 in the same wall, now
    noted on the page.
2026-11-01 IKEA page 5: shunt in line with the bus bars
    The bus shelf bench page still drew the pre-2026-11-01 layout (shunt
    on the tray side, bars in the inboard row). Now all three sit on the
    one stud line 23 mm from the tray edge, with the bars 1 mm off the lip
    and the shunt 4.5 mm off it, and the inboard band marked empty.
2026-11-01 Deck M5 bores blind: 11 mm floors, Ø6.7 x 9.5 from the top
    Owner: no melt out the back of an insert hole, like the trays' M4
    bores. The bus shelf floor and the breaker drop shelf plates go from
    9 to 11 mm and their ten M5 bores become blind Ø6.7 x 9.5 from the
    top: 6.7 mm insert, 2.8 mm of melt room, 1.5 mm of solid skin. The
    M5 x 12 bar and shunt screws stop inside the bore. Units sit 2 mm
    higher than the 9 mm build; the breaker keeps 12 mm under the lid.
    The 6 mm inverter plate keeps its through bores with the far-face
    relief: a blind bore there would need 9.5 mm of plate.
    Probe: shelf bores z 1.5..11 with solid floor under them, drop shelf
    bores z 216.5..226, breaker 226..269.5, lid a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
    [plate_breaker_shelf.stl, print_breaker_shelf_0.stl, print_breaker_shelf_1.stl, print_bus_shelf_0.stl, print_bus_shelf_1.stl, print_bus_shelf_2.stl]
2026-11-02 battery-box: insert bores to McMaster's tapered-insert hole spec (M5 Ø8.0 + 8° mouth, short M4 Ø6.0)
    The Ø6.7 M5 bores still printed too tight. McMaster 94180A361 is a TAPERED
    heat-set insert (body Ø7.82, flange Ø8.33): its hole is Ø7.7 (drill N, max
    0.303") with the top half tapered 8°. The Ø6.4 the repo had been using is the
    hole of McMaster's straight M5 line, not this part.
    - all 18 M5 sites: Ø8.0 modelled (+0.3 FDM) with an 8° tapered mouth 3.4 mm
    deep (Ø8.95 at the face) so the flange seats flush; deck bores stay blind
    x 9.5 in the 11 mm floors; tiles' far-face relief Ø8.6 -> Ø9.0
    - short M4 94180A351 (14 tile bores, 2 Garmin hanger) Ø5.6 -> Ø6.0 from the
    same sh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
    [plate_breaker_shelf.stl, print_breaker_shelf_0.stl, print_breaker_shelf_1.stl, print_bus_shelf_0.stl, print_bus_shelf_1.stl, print_bus_shelf_2.stl, print_garmin_hanger.stl, print_plate_inverter_tile_00.stl]
2026-11-02 battery-box: M5 bores Ø8.0 -> Ø7.5 (bench-tuned), short-M4 bores back to Ø5.6
    The Ø8.0 M5 print let the 94180A361 fall into the hole: this printer makes
    holes to size, so the +0.3 FDM allowance was wrong. M5 bores are now Ø7.5
    (0.2 under McMaster's Ø7.7 drill N for bite on the Ø7.82 knurl), still blind
    x 9.5 in the decks with the 8° tapered mouth (Ø8.46 at the face).
    The short-M4 sites (tiles x14, Garmin hanger x2) drop the same allowance,
    Ø6.0 -> Ø5.6. Owner: both M4 bores are perfect at Ø5.6, do not touch them.
    - cage.py: M5_BORE = 7.5 (M5_BORE_R 3.75), M4S_BORE_R = 2.8, FDM_HOLE gone
    - STLs, viewer JSON, manuals, IKEA pages, bench steps, order sheet, HISTORY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
    [plate_breaker_shelf.stl, print_breaker_shelf_0.stl, print_breaker_shelf_1.stl, print_bus_shelf_0.stl, print_bus_shelf_1.stl, print_bus_shelf_2.stl, print_garmin_hanger.stl, print_plate_inverter_tile_00.stl]
2026-11-06 v12s_h2d: the same box with the inverter plate as two 253 x 256 tiles for the H2D bed (tile_max and bed per variant)
    [plate_breaker_shelf.stl, plate_inverter_posts.stl, plate_inverter_splines.stl, plate_stack_straps.stl, print_breaker_shelf_0.stl, print_breaker_shelf_1.stl, print_bus_shelf_0.stl, print_bus_shelf_1.stl]
2026-11-07 Bus bar ears 134 mm on centre: outer bores moved 2 mm toward the shelf ends (plates 0 and 2)
    [plate_breaker_shelf.stl, plate_inverter_posts.stl, plate_stack_straps.stl, print_breaker_shelf_0.stl, print_breaker_shelf_1.stl, print_bus_shelf_0.stl, print_bus_shelf_1.stl, print_bus_shelf_2.stl]
2026-11-07 Flat-head relief cut into the floors at every tray and shelf wall bolt; --clash now probes a full-size head at each countersink
    [print_bus_shelf_0.stl, print_bus_shelf_2.stl, print_stack_strap.dxf, print_tray_battery_0.stl, print_tray_battery_1.stl]
2026-11-07 Drop shelf hanger jogged 2 mm below the rail for the 4 AWG leads; zip-tie slot pairs through the lower hanger
    [plate_breaker_shelf.stl, print_breaker_shelf_0.stl, print_breaker_shelf_1.stl, print_stack_strap.dxf]
2026-11-07 Drop shelf hanger redone clean: 13 mm flat-front band with 3/4 in screws, 2 mm back relief for the 4 AWG channel, tabs that close the channel (no jog, no tie slots)
    [plate_breaker_shelf.stl, print_breaker_shelf_0.stl, print_breaker_shelf_1.stl, print_stack_strap.dxf]
2026-11-07 Drop shelf: back relief 4 mm (13.5 mm channel for the lead and an adhesive tie mount), tabs removed; nothing around the battery moves
    [plate_breaker_shelf.stl, print_breaker_shelf_0.stl, print_breaker_shelf_1.stl, print_stack_strap.dxf]
2026-11-07 feat(battery-box): promote H2D master build, archive legacy variants to backup/, refine shelves, straps, ports & Fusion script
    [plate_breaker_shelf.stl, plate_inverter_posts.stl, plate_inverter_splines.stl, plate_stack_straps.stl, plate_tray_rail_brackets.stl, plate_tray_rail_brackets_front.stl, print_backing_inverter_14_311.stl, print_backing_inverter_14_343.stl]
2026-11-07 feat(battery-box): replace 2-piece inverter post + clip with 1-piece full-height H2D post (278.7 mm)
    [plate_inverter_posts.stl, plate_stack_straps.stl, print_plate_inverter_tile_00.stl, print_plate_inverter_tile_10.stl, print_post_clip_0.stl, print_post_clip_1.stl, print_post_inverter_0.stl, print_post_inverter_1.stl]
2026-11-07 Model Blue Sea 2701 DualBus with M4 bores, remove middle zip-tie row & sb50_solar_in
    [print_garmin_hanger_lower.stl, print_panel_front_inboard_ports.stl, print_stack_strap.dxf]
2026-11-07 Add BatteryBox_master Fusion script bundle and auto-evict Fusion sys.modules cache
2026-11-07 Model Garmin PowerSwitch per official drawing & make inverter post top ears symmetrical
    [plate_inverter_posts.stl, print_garmin_hanger.stl, print_post_inverter_0.stl, print_post_inverter_1.stl, print_stack_strap.dxf]
2026-11-08 Extend floor head_relief pocket length to 15.0 mm (0.6 in) for 1/2-in screws
    [print_bus_shelf_0.stl, print_bus_shelf_2.stl, print_stack_strap.dxf, print_tray_battery_0.stl, print_tray_battery_1.stl]
2026-11-08 Center SB50 alt between inverter post and AC ports (Y=355), stack 12V above, and raise 22mm round ports to Z=215
    [print_panel_front_inboard_ports.stl, print_stack_strap.dxf]
2026-11-08 Add 2x full-length 10 mm bus bar riser spacers (155 x 35 x 10 mm) & lift bus bars
    [plate_busbar_spacers.stl, print_busbar_spacer_0.stl, print_busbar_spacer_1.stl, print_stack_strap.dxf]
2026-11-08 Arrange plate_busbar_spacers.stl side-by-side (155 x 82 mm footprint)
    [plate_busbar_spacers.stl]
2026-11-08 Orient busbar spacers 35 x 155 mm (along Y) so Bambu Studio H2D packs them side-by-side
    [plate_busbar_spacers.stl, print_busbar_spacer_0.stl, print_busbar_spacer_1.stl]
2026-11-08 Narrow busbar spacers to 1.0 in (25.4 mm) wide (155 x 25.4 x 10 mm)
    [plate_busbar_spacers.stl, print_busbar_spacer_0.stl, print_busbar_spacer_1.stl]
2026-11-08 Update viewer/cage-master.json with 1.0 in (25.4 mm) wide busbar spacers
    [plate_busbar_spacers.stl, print_busbar_spacer_0.stl, print_busbar_spacer_1.stl, print_stack_strap.dxf]
2026-11-08 Extend bus_shelf_1 by 2.5mm on MPPT (-X) side and update busbar spacers to 15mm tall with Ø8.25mm holes
    [plate_busbar_spacers.stl, print_bus_shelf_1.stl, print_busbar_spacer_0.stl, print_busbar_spacer_1.stl]
2026-11-08 Extend print_plate_inverter_tile_10 +X post fin by 2.5mm without moving bolt holes
    [print_plate_inverter_tile_10.stl]
2026-11-08 Move MPPT-side (-X) sill hole on print_bus_shelf_1 2.5mm toward MPPT
    [print_bus_shelf_1.stl]
2026-11-09 Align Cerbo GX centerline with MPPT (Z=155mm) and shift tile_10 bus-shelf sill holes +2.5mm away from MPPT
    [print_plate_inverter_tile_00.stl, print_plate_inverter_tile_10.stl]
2026-11-09 Align Cerbo GX bottom M4 holes with Orion-Tr bottom M4 holes (Z=130mm)
    [print_plate_inverter_tile_00.stl, print_plate_inverter_tile_10.stl]
2026-11-09 Document final production Bambu ABS-GF Black print & heat-set insert settings in README.md
2026-11-10 feat(battery-box): add v14 variant for Victron BAT512120610 12.8V/200Ah Smart battery + front breaker/BMS deck
    [plate_busbar_spacers.stl, plate_inverter_posts.stl, plate_inverter_splines.stl, plate_stack_straps.stl, print_breaker_deck_0.stl, print_bus_shelf_0.stl, print_bus_shelf_1.stl, print_bus_shelf_2.stl]
2026-11-10 feat(v14): swap 200Ah battery & BMS bays, add elevated breaker deck over BMS, equidistant rail & bus-shelf holes
    [print_breaker_deck_0.stl, print_bus_shelf_0.stl, print_bus_shelf_1.stl, print_bus_shelf_2.stl, print_stack_strap.dxf, print_tray_battery_0.stl, print_tray_battery_1.stl]
2026-11-10 Remove 3x M4 through-bolts from front and back 2-tile end panel half-laps on master and v14
    [print_panel_back_inboard_gx.stl, print_panel_back_outboard.stl, print_panel_front_inboard_ports.stl, print_panel_front_outboard.stl, print_stack_strap.dxf]
2026-11-11 Update print_panel_back_inboard_gx (and back_outboard): +7.8mm bottom height, R=8.6mm corner notch, 6.5mm thickness
    [print_panel_back_inboard_gx.stl, print_panel_back_outboard.stl]
2026-11-11 Double back panel corner notch radius to R=17.2mm on master and v14
    [print_panel_back_inboard_gx.stl, print_panel_back_outboard.stl]
2026-11-11 Apply +7.8mm bottom height, R=17.2mm corner notch, and 6.5mm thickness to front printed panels on master and v14
    [print_panel_front_inboard_ports.stl, print_panel_front_outboard.stl]
2026-11-11 Reduce printed front and back panel thickness from 6.5mm (+0.5mm) to 6.25mm (+0.25mm) on master and v14
    [print_panel_back_inboard_gx.stl, print_panel_back_outboard.stl, print_panel_front_inboard_ports.stl, print_panel_front_outboard.stl]
2026-11-12 Flip print_panel_back_outboard onto outer textured face and reduce lap flap by 0.15mm on master and v14
    [print_panel_back_outboard.stl]
2026-11-12 Orient print_panel_back_inboard_gx textured-side-out with Z=3.20..6.10mm lap relief and restore support-free back_outboard
    [print_panel_back_inboard_gx.stl, print_panel_back_outboard.stl]
2026-11-12 Keep flipped -0.15mm lap on print_panel_back_outboard and original print_panel_back_inboard_gx to match printed GX panel
    [print_panel_back_inboard_gx.stl, print_panel_back_outboard.stl]
2026-11-13 Finalize H2D front port panels and add 2-piece solid side panel pairs (Textured side out, -0.15mm lap relief)
    [print_panel_front_inboard_ports.stl, print_panel_front_outboard.stl, print_panel_side_inboard_back.stl, print_panel_side_inboard_front.stl, print_panel_side_outboard_back.stl, print_panel_side_outboard_front.stl]
2026-11-13 Add dual-nozzle White PETG flush port rings/labels (.3mf + STL) and removable outboard MOLLE panel
    [print_panel_front_inboard_ports.stl, print_panel_front_inboard_ports_inlay_white.stl, print_panel_front_inboard_ports_multicolor.3mf, print_panel_front_outboard_molle.stl]
2026-11-13 Add flush White PETG outline and AUX BATT label to print_panel_front_outboard
    [print_panel_front_outboard.stl, print_panel_front_outboard_inlay_white.stl, print_panel_front_outboard_multicolor.3mf]
2026-11-13 Extend SB50 white outline +5mm per side (55x79 ID / 58.6x82.6 OD) to clear cover and bolts
    [print_panel_front_inboard_ports.stl, print_panel_front_inboard_ports_inlay_white.stl, print_panel_front_inboard_ports_multicolor.3mf, print_panel_front_outboard.stl, print_panel_front_outboard_inlay_white.stl, print_panel_front_outboard_multicolor.3mf]
2026-11-13 Shift P4-P6 port column left 10mm (u=65) and align P4 bottom with P1 for even spacing
    [print_panel_front_inboard_ports.stl, print_panel_front_inboard_ports_inlay_white.stl, print_panel_front_inboard_ports_multicolor.3mf]
2026-11-13 Swap P5 and P6 labels so both top-row ports read DC OUT
    [print_panel_front_inboard_ports.stl, print_panel_front_inboard_ports_inlay_white.stl, print_panel_front_inboard_ports_multicolor.3mf]
2026-11-13 Front panels & MOLLE: 4x DC OUT inboard, stacked SB50s by lap on outboard, trimmed 4x8 MOLLE
    [print_panel_front_inboard_ports.stl, print_panel_front_inboard_ports_inlay_white.stl, print_panel_front_inboard_ports_multicolor.3mf, print_panel_front_outboard.stl, print_panel_front_outboard_inlay_white.stl, print_panel_front_outboard_molle.stl, print_panel_front_outboard_multicolor.3mf]
2026-11-13 4-piece H2D half-lapped roof w/ 82-deg beveled 1/4-20 bolts + MOLLE countersinks
    [print_panel_front_outboard_molle.stl, print_panel_lid_back_inboard.stl, print_panel_lid_back_outboard.stl, print_panel_lid_front_inboard.stl, print_panel_lid_front_outboard.stl]
2026-11-13 battery-box: 3-color continuous topographic side panel inlays (.3mf)
    [print_panel_side_inboard_back.stl, print_panel_side_inboard_back_inlay_green.stl, print_panel_side_inboard_back_inlay_white.stl, print_panel_side_inboard_back_multicolor.3mf, print_panel_side_inboard_front.stl, print_panel_side_inboard_front_inlay_green.stl, print_panel_side_inboard_front_inlay_white.stl, print_panel_side_inboard_front_multicolor.3mf]
2026-11-13 battery-box: add steep/gentle topo contour spacing variety on side panels
    [print_panel_side_inboard_back.stl, print_panel_side_inboard_back_inlay_green.stl, print_panel_side_inboard_back_inlay_white.stl, print_panel_side_inboard_back_multicolor.3mf, print_panel_side_inboard_front.stl, print_panel_side_inboard_front_inlay_green.stl, print_panel_side_inboard_front_inlay_white.stl, print_panel_side_inboard_front_multicolor.3mf]
2026-11-13 battery-box: extend front end panel slot tongues to 6.0mm (450.1mm / 17.72 in)
    [print_panel_front_inboard_ports.stl, print_panel_front_inboard_ports_multicolor.3mf, print_panel_front_outboard.stl, print_panel_front_outboard_inlay_white.stl, print_panel_front_outboard_multicolor.3mf]
